siglabsoss/graviton/docs/pin_mapping.pdf

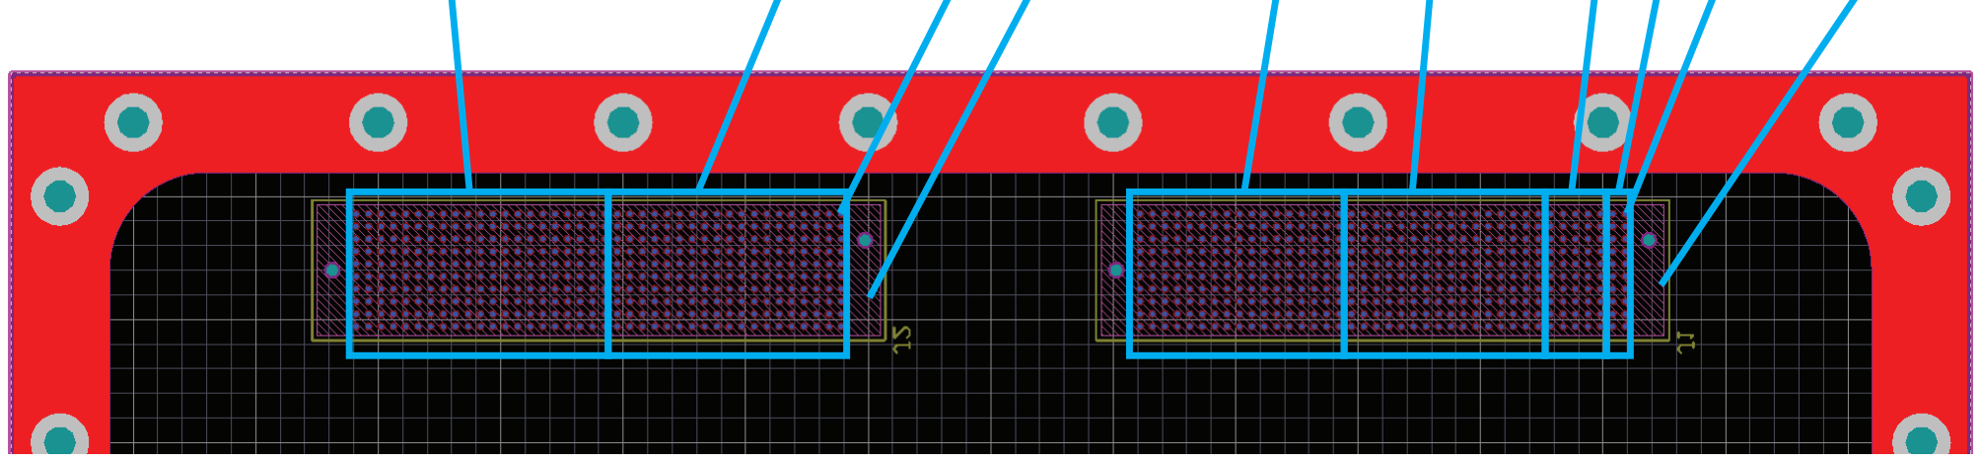
[picture p1: figure]

Graviton Connector: SEAF-40-06.5-S-10-2-A-K-TR (qty. 2)
Viewing from Top and looking through board to connectors on bottom layer

J1(Graviton) goes to J3 (Copper Suicide)
J2 (Graviton) goes to J4 (Copper Suicide)
pin1 | pin1 | J1 J2

JTAG/GPMC/SPI

DAC DATA FROM ETHERNET

ADC DATA FROM ETHERNET

ADC FPGA

DAC FPGA

POWER
