siglabsoss/graviton/docs/system_block_diagram.pdf

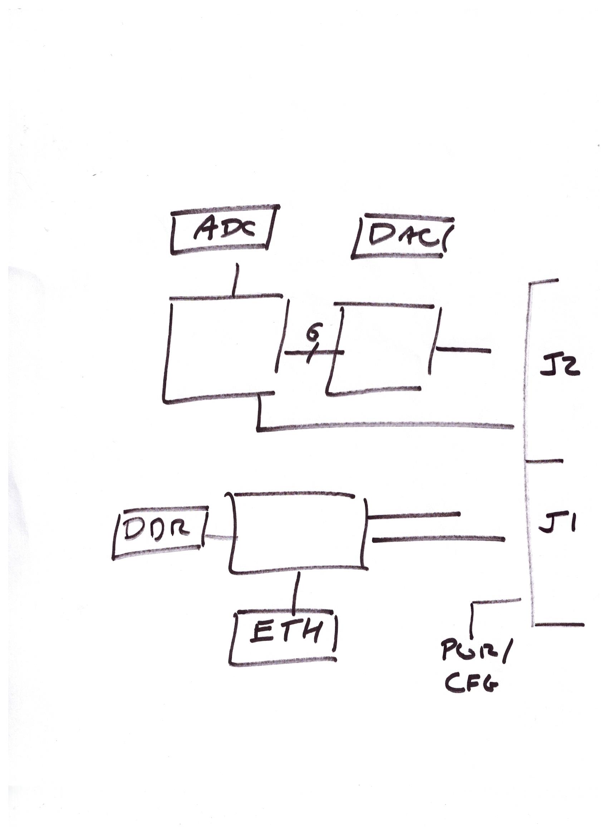
[picture p3: page 1]
