siglabsoss/graviton/docs/Block Diagram v2.png

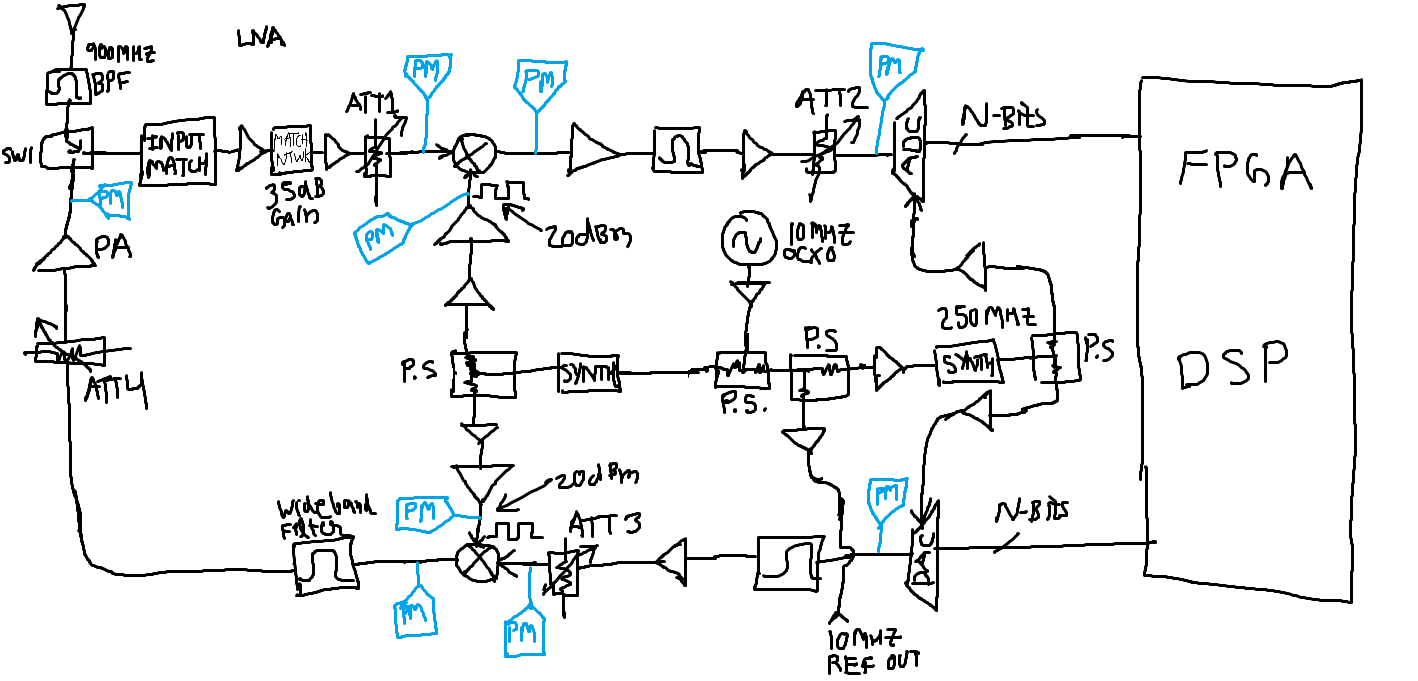
docs/Block Diagram v2.png
