siglabsoss/graviton/docs/graviton_master.xlsx

Sheet: rx_chain
 |  |  |  |  | passband, fc (Hz) | 915000000
Graviton Receiver Analog Front End Cascade Analysis |  |  |  |  | baseband, fc (Hz) | 35000000
 |  |  |  |  | subcarrier bw (Hz) | 30517.57812
 |  |  |  |  | subcarrier noise floor (dBm) | -129.1544993 | dBm
output Z | part number | desc | gain | gain | NF | F |  | cascade F | cascade NF | total gain | total gain | FS limit #1 | FS limit #2 | fs input | fs input | IIP3 | IP3 spur @ FS | noise contribution | notes
 |  |  | dB | W/W | dB |  |  |  | dB | dB | W/W | dBm | dBm | dBm | uW | dBm | dBm | db
377-Ohms S.E. |  | link | 0 | 1.0 | 0 | 1.00 |  | 1.00 | 0.0 | 0 | 1.0 |  |  | -34.8 | 0.330
50-Ohm S.E. |  | antenna matching | 0 | 1.0 | 0.0 | 1.00 |  | 1.00 | 0.0 | 0 | 1.0 |  |  | -34.8 | 0.330369541 |  |  | 0.00
50-Ohm S.E. |  | helical filter | -0.5 | 0.9 | 0.5 | 1.12 |  | 1.12 | 0.5 | -0.5 | 0.9 |  |  | -34.8 | 0.330369541 |  |  | 0.50
50-Ohm S.E. | 132136 | connector IL | -0.2 | 1.0 | 0.2 | 1.05 |  | 1.17 | 0.7 | -0.7 | 0.9 |  |  | -35.3 | 0.2944421634 |  |  | 0.20
50-Ohm S.E. | PE42820 | switch IL | -0.3 | 0.9 | 0.3 | 1.07 |  | 1.26 | 1.0 | -1 | 0.8 |  |  | -35.5 | 0.281190083 |  |  | 0.30
50-Ohm S.E. | SKY67150-396LF | LNA | 20.5 | 112.2 | 0.2 | 1.05 |  | 1.33 | 1.2 | 19.5 | 89.1 |  |  | -35.8 | 0.2624218543 |  |  | 0.23
50-Ohm S.E. | SF2098H | SAW filter IL | -2 | 0.6 | 2.0 | 1.58 |  | 1.33 | 1.3 | 17.5 | 56.2 |  |  | -15.3 | 29.44421634 |  |  | 0.02
50-Ohm S.E. | MMG3004NT1 | block RF amplifier | 16.5 | 44.7 | 3.5 | 2.24 |  | 1.36 | 1.3 | 34 | 2511.9 |  |  | -17.3 | 18.57804455 |  |  | 0.07
50-Ohm S.E. | PE43713 | DSA insersion Loss | -1.3 | 0.7 | 1.3 | 1.35 |  | 1.36 | 1.3 | 32.7 | 1862.1 |  |  | -0.8 | 829.8507675 |  |  | 0.0004449245997
50-Ohm S.E. |  | DSA setting | 0 | 1.0 | 0.0 | 1.00 |  | 1.36 | 1.3 | 32.7 | 1862.1 |  |  | -2.1 | 615.1768727 |  |  | 0.00
50-Ohm S.E. | MAX2031 | MIXER | -7 | 0.2 | 7.0 | 5.01 |  | 1.36 | 1.3 | 25.7 | 371.5 | 0 | -10 | -2.1 | 615.1768727 | 36 | -116.44 | 0.01 | critical
50-Ohm D.E. |  | impedance matching | -3 | 0.5 | 3.0 | 2.00 |  | 1.36 | 1.3 | 22.7 | 186.2 |  |  | -9.1 | 122.7439231 |  |  | 0.01
100-Ohm D.E. | XLF-151+ | reflectionless filter | -1.4 | 0.7 | 1.4 | 1.38 |  | 1.36 | 1.3 | 21.3 | 134.9 |  |  | -12.1 | 61.51768727 |  |  | 0.01
300-Ohm D.E. | LMH6554 | IF Amp | 9 | 7.9 | 6.7 | 4.68 |  | 1.39 | 1.4 | 30.3 | 1071.5 |  |  | -13.5 | 44.56562484 | 20.1 |  | 0.09 | NF derived from Spice simulation
100-Ohm D.E. | TC3-1TG2+ | transformer (Z = 3:1) | -0.49 | 0.9 | 0.5 | 1.12 |  | 1.39 | 1.4 | 29.8 | 957.2 |  |  | -4.5 | 353.9973411 |  |  | 0.0003481871951
100-Ohm D.E. | MEM2012SC470 | MEMS filter | 0 | 1.0 | 0.0 | 1.00 |  | 1.39 | 1.4 | 29.8 | 957.2 |  |  | -5.0 | 316.227766 |  |  | 0.00
300-Ohm D.E. | LMH6554 | AMP | 12 | 15.8 | 7.7 | 5.89 |  | 1.40 | 1.4 | 41.8 | 15170.5 |  |  | -5.0 | 316.227766 |  |  | 0.02
100-Ohm D.E. | placeholder | placeholder | 0 | 1.0 | 0.0 | 1.00 |  | 1.40 | 1.4 | 41.8 | 15170.5 |  |  | 7.0 | 5011.872336 |  |  | 0.00
100-Ohm D.E. | placeholder | placeholder | 0 | 1.0 | 0.0 | 1.00 |  | 1.40 | 1.4 | 41.8 | 15170.5 |  |  | 7.0 | 5011.872336 |  |  | 0.00
50-Ohm D.E. | placeholder | placeholder | 0 | 1.0 | 0.0 | 1.00 |  | 1.40 | 1.4 | 41.8 | 15170.5 |  |  | 7.0 | 5011.872336 |  |  | 0.00
 | AD42LB69 | ADC (250 Msps), Vpp(diff) = 2.0V | 0 | 1.0 | 27.0 | 501.19 |  | 1.43 | 1.5 | 41.8 | 15170.5 | 9 | 7 | 7.0 | 5011.872336 |  |  | 0.10 | Vpp=2Vdiff, Z=100(D.E.), Pin(rms)=5mW(7dBm)
 |  | legend
 | [NUMBER] | things that you can program

Sheet: tx_chain
output z | P/N | desc | gain (worse) | gain (typ) |  | out (worse) | out (typ) | p (W, worse) | r | vrms (worse)
 |  | digital attenuation
 | DAC3484 | DAC (4.7mArms @ 50-Ohm) | -2.5 | -2.6 | dBm | -2.5 | -2.6 | 0.0006 | 50 | 0.167
100 D.E. | TC1-1TG2+ | transformer | -0.3 | -0.4 | dB | -2.9 | -3.0 | 0.001 | 50 | 0.160
100 D.E. | MEM2012V121R | MEMS | -0.2 | -0.2 | dB | -3.1 | -3.2 | 0.0004897788194 | 51 | 0.158
100 D.E. | LMH6554 | IF amp | -4.7 | -4.7 | dB | -7.8 | -7.9 | 0.0001659586907 | 52 | 0.093
100 D.E. | XLF-151+ | reflectionless filter | -1.8 | -1.4 | dB | -9.6 | -9.3 | 0.0001096478196 | 53 | 0.076
 |  | matching (attenuation approximate, depends on matching) | -7.3 | -7.3 | dB | -16.9 | -16.6 | 2.041737945e-05 | 54 | 0.033
50 S.E. | MAX2031 | mixer | -7.0 | -7.0 | dB | -23.9 | -23.6 | 4.073802778e-06 | 54 | 0.015
50 S.E. | SKY67150-396LF | preamp | 19.0 | 20.5 | dB | -4.9 | -3.1 | 0.0003235936569 | 55 | 0.133
50 S.E. | SF2098H | SAW filter | -3.0 | -2.0 | dB | -7.9 | -5.1 | 0.0001621810097 | 56 | 0.095
50 S.E. | MMG3006NT1 | preamp | 16.5 | 17.5 | dB | 8.6 | 12.4 | 0.007 | 57 | 0.643
50 S.E. |  | placeholder | 0.0 | 0.0 | dB | 8.6 | 12.4 | 0.007 | 58 | 0.648
50 S.E. | MMG3006NT1 | preamp | 16.5 | 17.5 | dB | 25.1 | 29.9 | 0.324 | 59 | 4.369
50 S.E. | NPA1006 | power amplifier (12.5W, 41dBm max) | 16.5 | 18.5 | dB | 41.6 | 48.4 | 14.454 | 60 | 29.449
50 S.E. |  | power meter | -0.3 | -0.3 | dB | 41.3 | 48.1 | 13.490 | 61 | 28.686
50 S.E. | PE42820MLBA-X | switch | -0.3 | -0.3 | dB | 41.0 | 47.8 | 12.589 | 62 | 27.938
50 S.E. |  | helical Filter | -1.0 | -1.0 | dB | 40.0 | 46.8 | 10.000 | 63 | 25.100
 |  |  |  |  |  |  |  | Rs | 150 | Ohm
 |  |  |  |  |  |  |  | Rp | 13.63636364 | Ohm
 |  | amp output (dBm) | 40.0 | 46.8 | dBm |  |  | gain | 0.08 | V/V
 |  | power (W) | 10.0 | 47.9 | Watts
 |  | worse case (over spec): | 0.6 |  |  |  |  | op gain | 2.333333333
 |  | typical case (over spec): | 7.4
 |  |  |  |  |  |  |  | total gain | 0.1944444444
 |  |  |  |  |  |  |  | Pin/Pout | 0.07561728395 | W/W
 |  |  |  |  |  |  |  |  | -11.2 | dB

Sheet: power_budget
5.5V Supply
eff | volts | amps | watts
0.85 | 3.8 | 5.8 | 22.1 | 3.7V Supply
1 | 5.5 | 2.4 | 13.2 | AFE #1 5V
1 | 5.5 | 0.1 | 0.6 | AFE #1 -5V
1 | 5.5 | 2.4 | 13.2 | AFE #2 5V
1 | 5.5 | 0.1 | 0.6 | AFE #2 -5V
1 | 5.5 | 2 | 11.0 | Amps
1 | 5.5 | 0.5 | 2.8 | OCXO
1 | 5.5 | 3 | 16.5 | SigCarrier
1 | 5.5 | 1 | 5.5 | Fans
 |  | watts | 85.3
 |  | overrating (W) | 93.9
 |  | volts | 5.5
 |  | amps | 17.1
3.8 Supply
eff | volts | amps | watts
1 | 3.8 | 0.245 | 0.9 | ADC (DRVDD 1.8V)
1 | 3.8 | 0.522 | 2.0 | ADC (AVDD 3.3V)
1 | 3.8 | 0.182 | 0.7 | ADC (AVDD 1.8V)
1 | 3.8 | 0.135 | 0.5 | DAC (AVDD 3.3V)
1 | 3.8 | 0.65 | 2.5 | DAC (DVDD 1.2V)
1 | 3.8 | 0.15 | 0.6 | DAC (DACVDD 1.2)
1 | 3.8 | 0.385 | 1.5 | SYNTH (3.3V)
1 | 3.8 | 0.665 | 2.5 | CLK (3.3V)
1 | 3.8 | 0.14 | 0.5 | MCU (3.0V)
1 | 3.8 | 1 | 3.8 | 2.5V Supply
1 | 3.8 | 1 | 3.8 | 1.8V Supply
1 | 3.8 | 0.2 | 0.8 | ETH (3.3V)
1 | 3.8 | 0.01 | 0.038 | AFE (3.3)
 |  | watts | 20.1
 |  | overrating (W) | 22.1
 |  | volts | 3.8
 |  | amps | 5.8
-5.5V Supply
eff | volts | amps | watts
 |  | watts | 0.0
 |  | volts | 5.5
 |  | amps | 0.0
29V Supply
eff | volts | amps | watts
0.85 | 5.5 | 17.1 | 110.4 | 5.5V supply
0.85 | 5.5 | 5.8 | 37.6 | 3.7V supply
0.85 | 3.7 | 0.0 | 0.0 | -5V supply
1 | 29 | 1 | 29.0 | TX PA #1
1 | 29 | 1 | 29.0 | TX PA #2
 |  | watts | 206.0
 |  | volts | 29.0
 |  | amps | 7.1
