siglabsoss/graviton/docs/20180918-1_grav3_rework_instructions(rev3.1).docx

#1. “DAC 1.2V regulators not regulating”

Solution: Connect feedback pin.

Instructions: Jumper C412 and C416

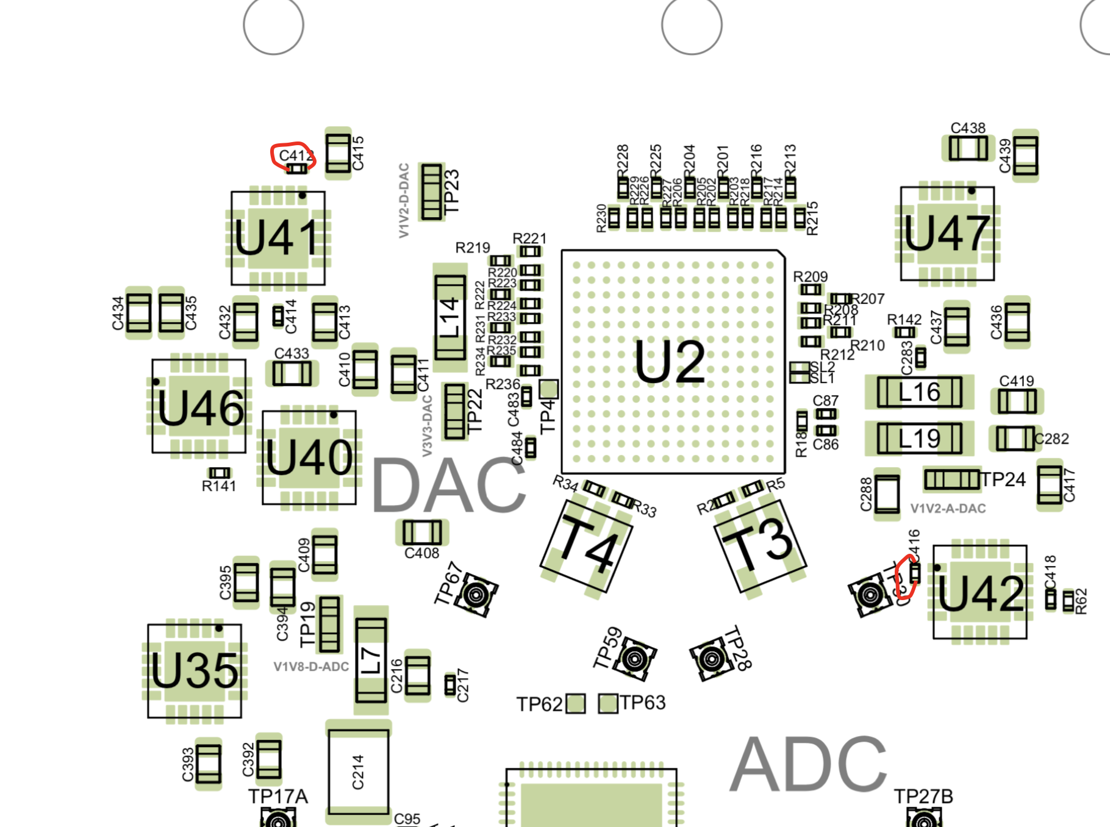
[picture p5: figure]

#2. “SPI bus being held low”

Solution: DAC, SYNTH, and CLOCK power supplies need to be jumpered ON (i.e. on by default).

Instructions: Jumper R62 to C417 (as shown below). Jumper R66 to C428 (as shown below). Jumper R60 to C404 (as shown below).

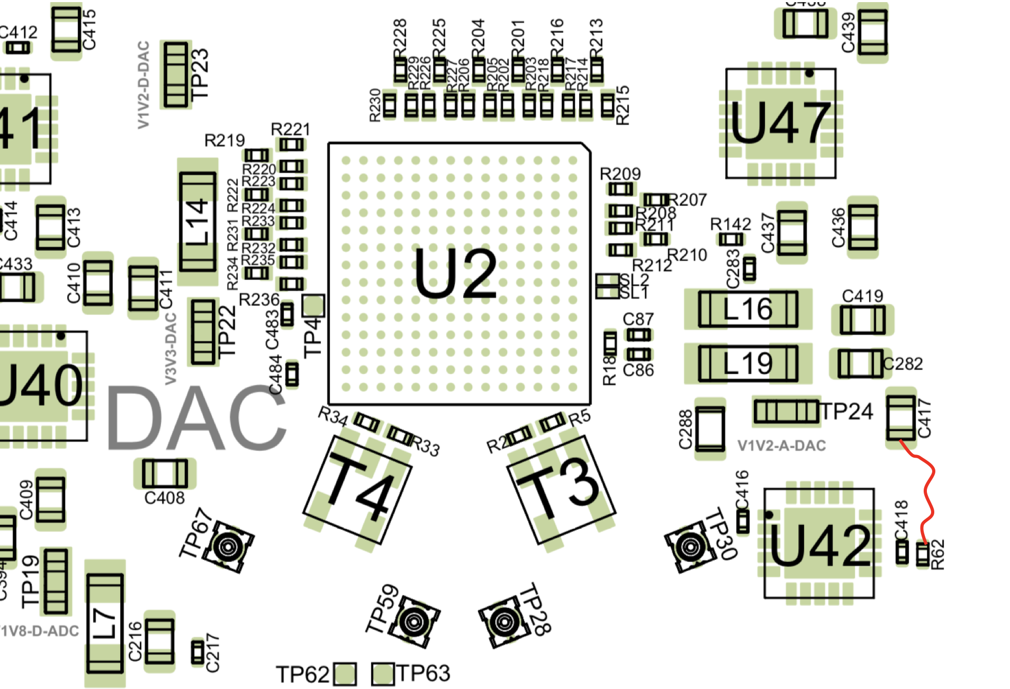
[picture p6: figure]
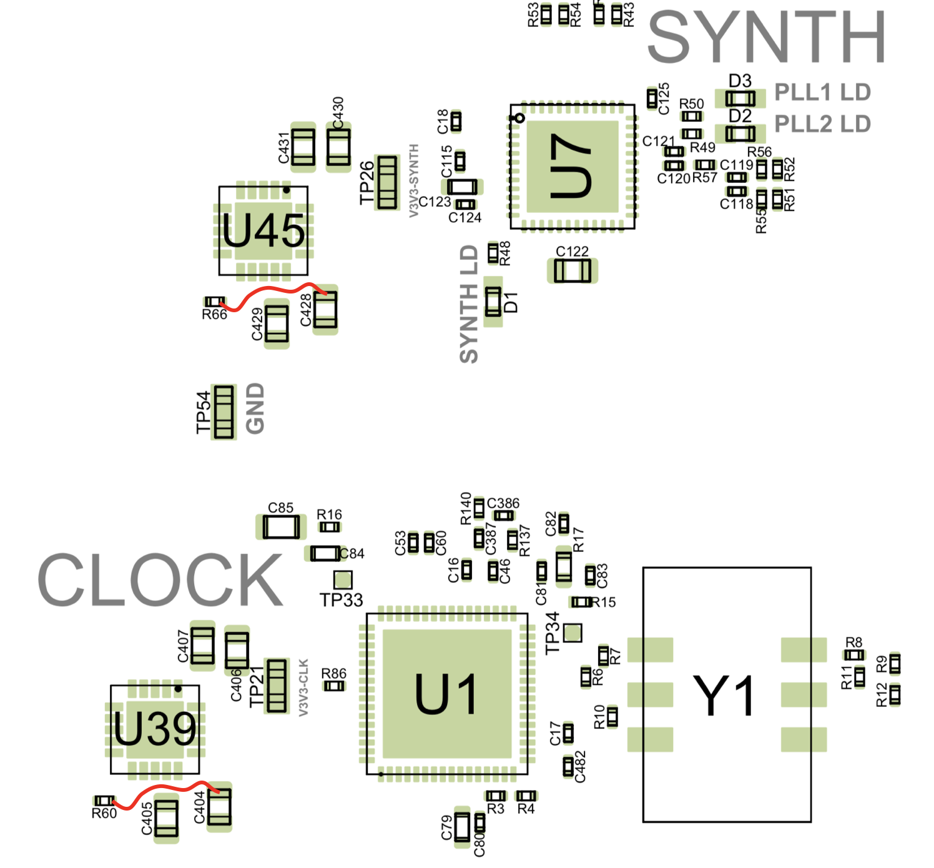
[picture p7: figure]

3. “Not enough solder on Solder-Link pads”

Solution: Verify all solder-links are bridged. If not, bridge them. All solder links are highlighted below.

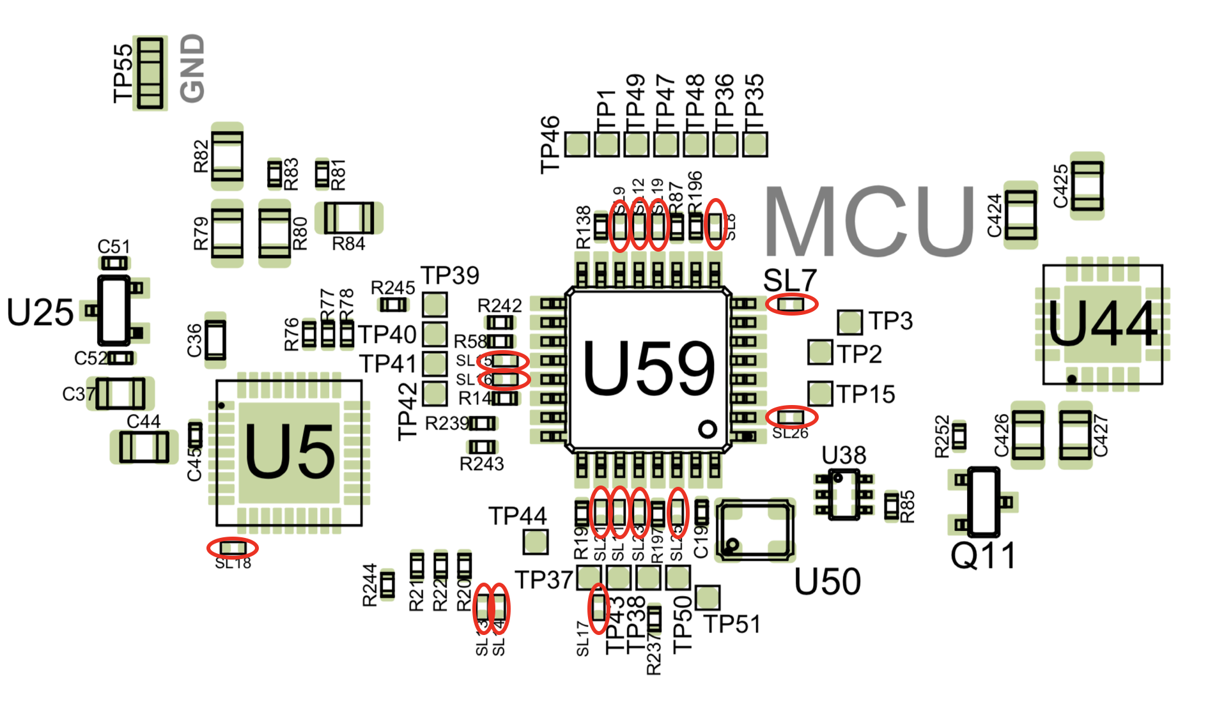
[picture p8: figure]

4. “U25 is wrong”

Solution: substitute P/N MCP1700T-5002E/TT and rotate 120 degrees (as shown below).

Note: MCP1700T-5002E/TT is already in BOM. It just needs rotating.

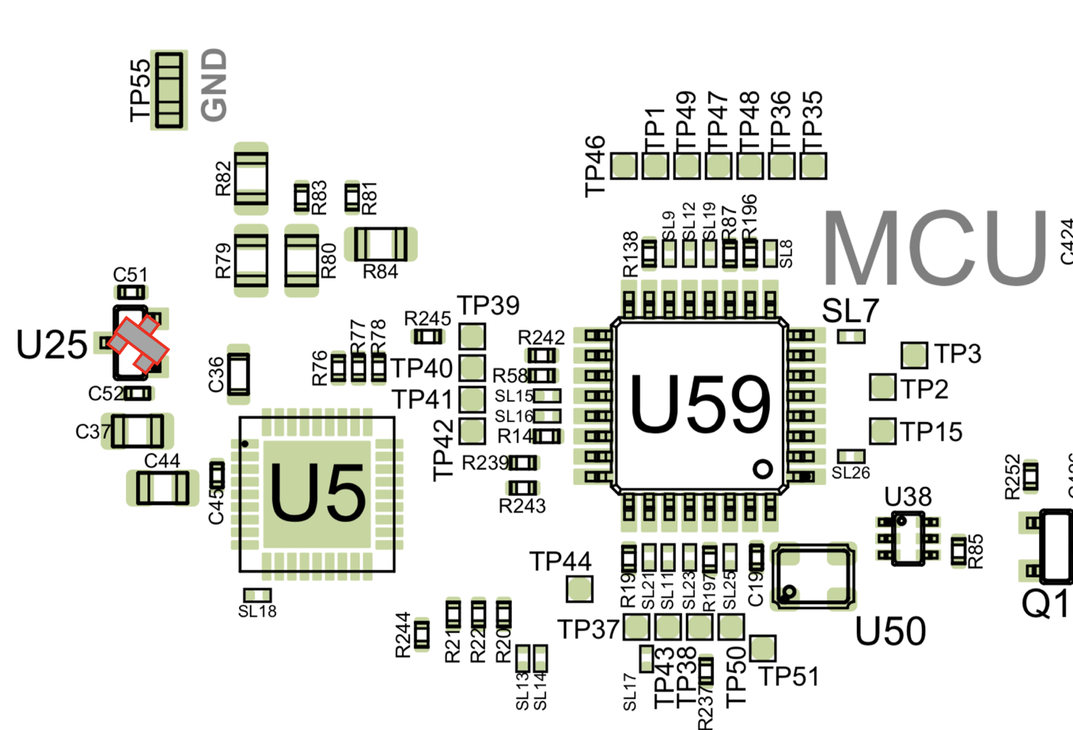
[picture p9: figure]

5. “5MHZ Oscillator Quality Issue”

Solution: terminate at drive side instead of receive side

Instructions: Short R137 (as shown below). Make R198 22-Ohms. Make C385 100nF.

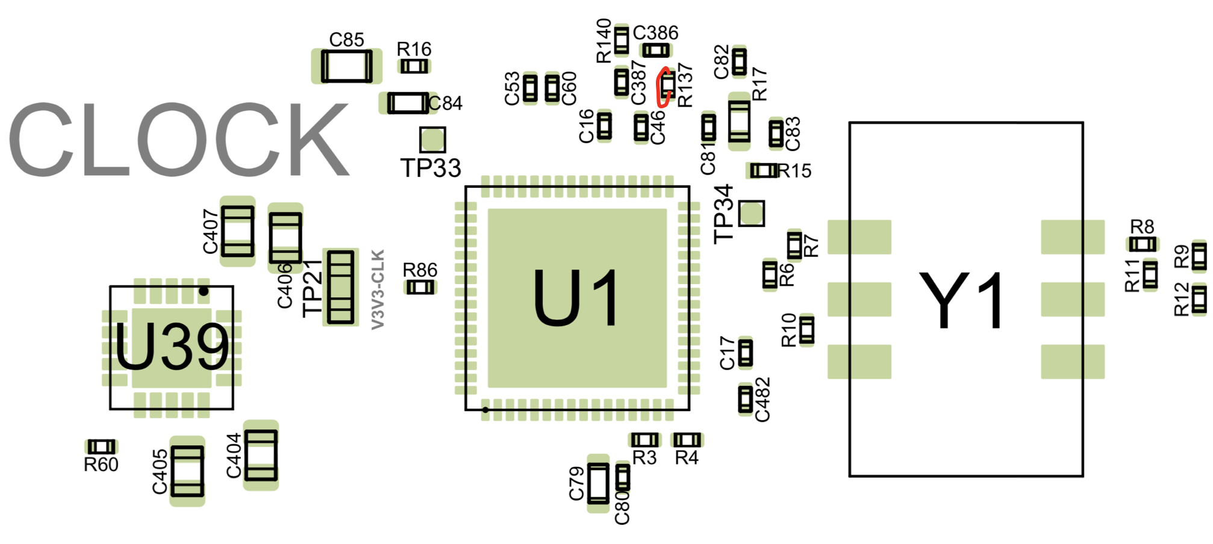
[picture p10: figure]
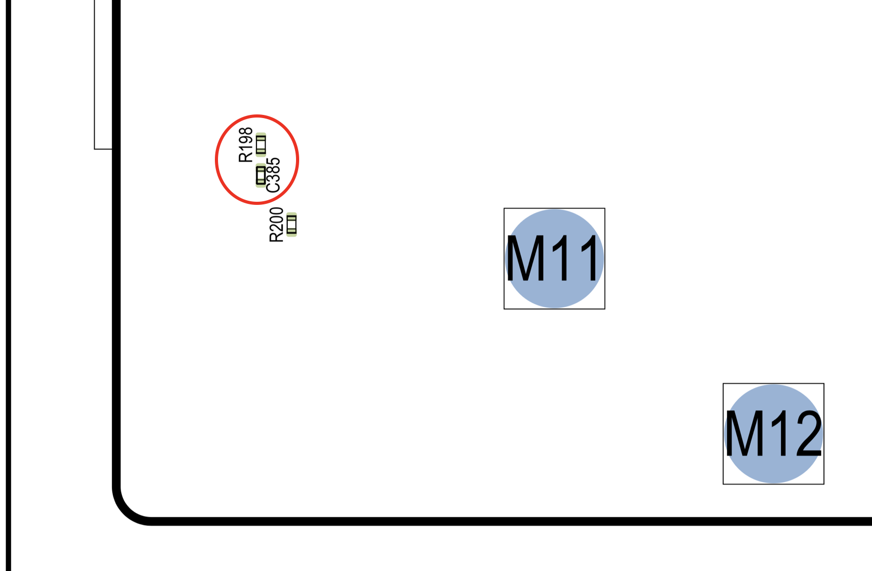
[picture p11: figure]

REWORK INSTRUCTIONS, GRAVITON REV. 3.1
