siglabsoss/graviton/docs/User Guide Block Diagrams.pptx

RX FPGA

RF Front End (x2)

TX Chain

LO from CLOCK
(see clock diagram)

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
RX Chain

BPF

MIX

X

IF AMP

VGA

ADC

LVDS

SPI

TX/RX SW

LO from CLOCK
(see clock diagram)

LVDS

SPI

CONFIG
FPGA

GPIO

SPI

PARALLEL

TX FPGA

## Slide 2

RX FPGA

CONFIG
FPGA

JTAG

MAIN JTAG CONNECTOR

SPI

FLASH

ENET
PHY

MDIO

sysCONFIG SPI

sysCONFIG SPI

SDRAM

DDR3

GPMC 23

RGMII

sysCONFIG SPI

RX FPGA

JTAG

ETHERNET FPGA

JTAG

JTAG

GPIO 8

DDR 47

SDR 23

DDR 47

SDR 23

SDR 23

DDR 47

SDR 23

DDR 47

COPPER SUICIDE CONNECTOR J2

COPPER SUICIDE CONNECTOR J1

GRAVITON JUMPER CONNECTOR J4

GRAVITON JUMPER CONNECTOR J3

GRAVITON JUMPER
(optional)

## Slide 3

BIAS
LDO

8V

RF Front End

PoE
ETH
JACK

48V

5V/6A
BUCK

-2.7

1.2V/2A
BUCK

DAC Core

2.5V/2A
BUCK

I/O Supply, FPGA VCCAUX

COPPER SUICIDE CONENCTOR

1.8V/2A BUCK

I/O Supply

Oscillators, RF LNAs, PAs, Mixers, DSAs, VGAs

1.35V/2A
BUCK

SDRAM

1.1V/6A
BUCK

FPGA Core

3.3V/2A
BUCK

PLLs, ADC

Ultra-low-noise
Supply for LNAs

0.68V
LDO

SDRAM
VTERM

4.8V
LDO

1.8V
LDO

ADC
AVDD

5V/6A
BUCK

x4
