siglabsoss/graviton/hardware/180706-1_graviton(schem_rev3).pdf

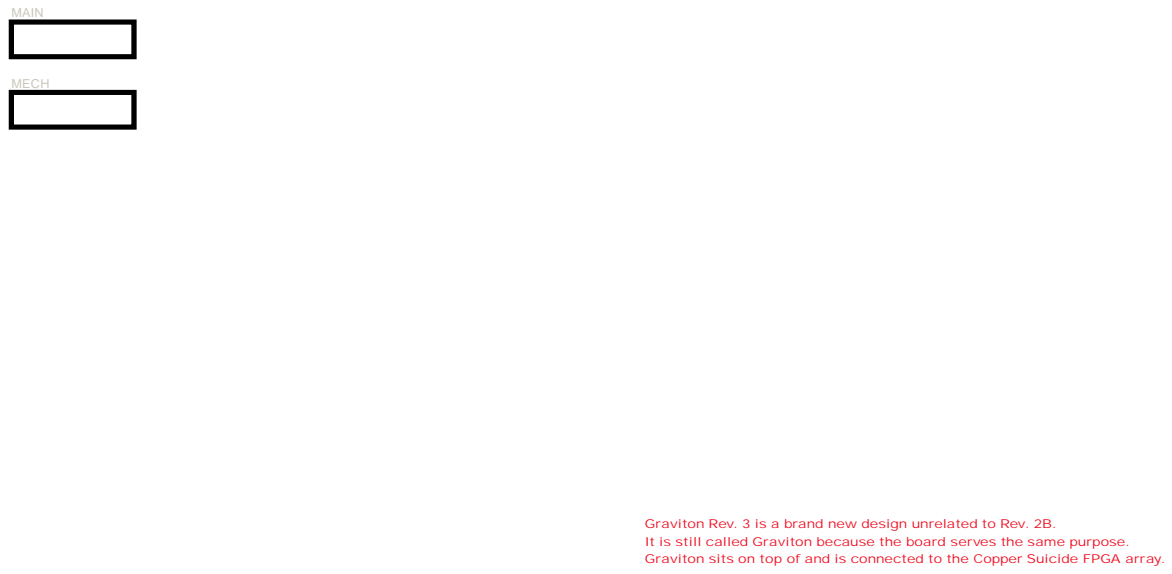
[picture p18: page 1]

Graviton Rev. 3 is a brand new design unrelated to Rev. 2B.
It is still called Graviton because the board serves the same purpose.
Graviton sits on top of and is connected to the Copper Suicide FPGA array.

Signal Laboratories, Inc. 3479 Edison Way Menlo Park CA 94025 +1 (877) 778-8435 siglabs.com | Title Graviton SDR

Engineer J. Brinton | Drawn By J. Brinton | Checked By J. Brinton

Date 7/6/2018 Sheet 1 of 49 Revision

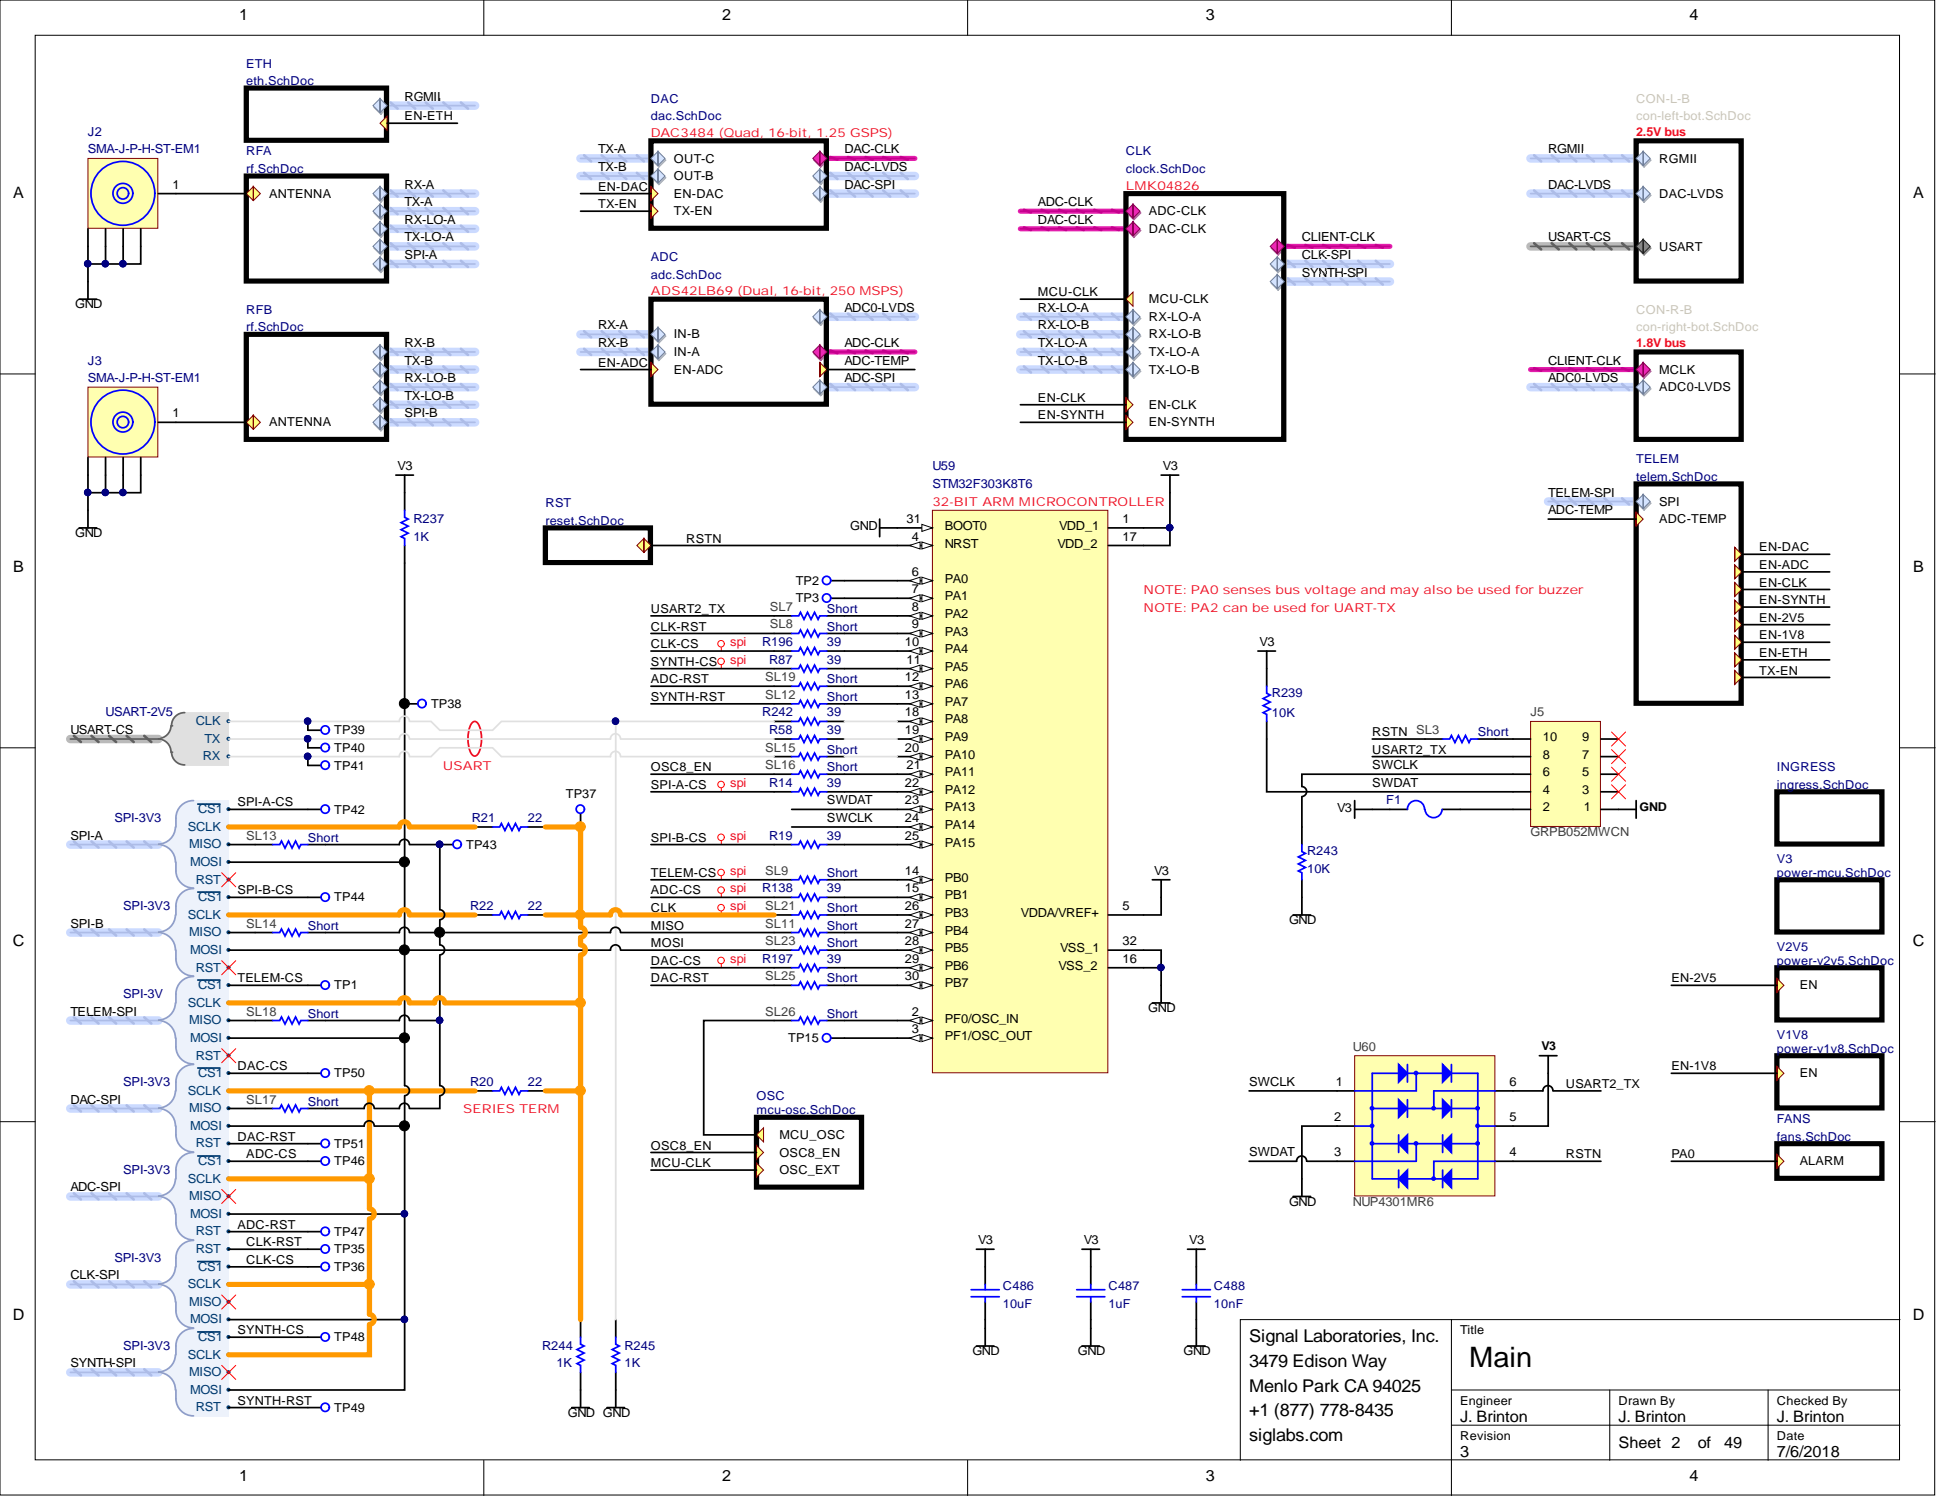
[picture p19: page 2]

CON-L-B
con-left-bot.SchDoc
2.5V bus

CON-R-B
con-right-bot.SchDoc
1.8V bus

NOTE: PA0 senses bus voltage and may also be used for buzzer
NOTE: PA2 can be used for UART-TX

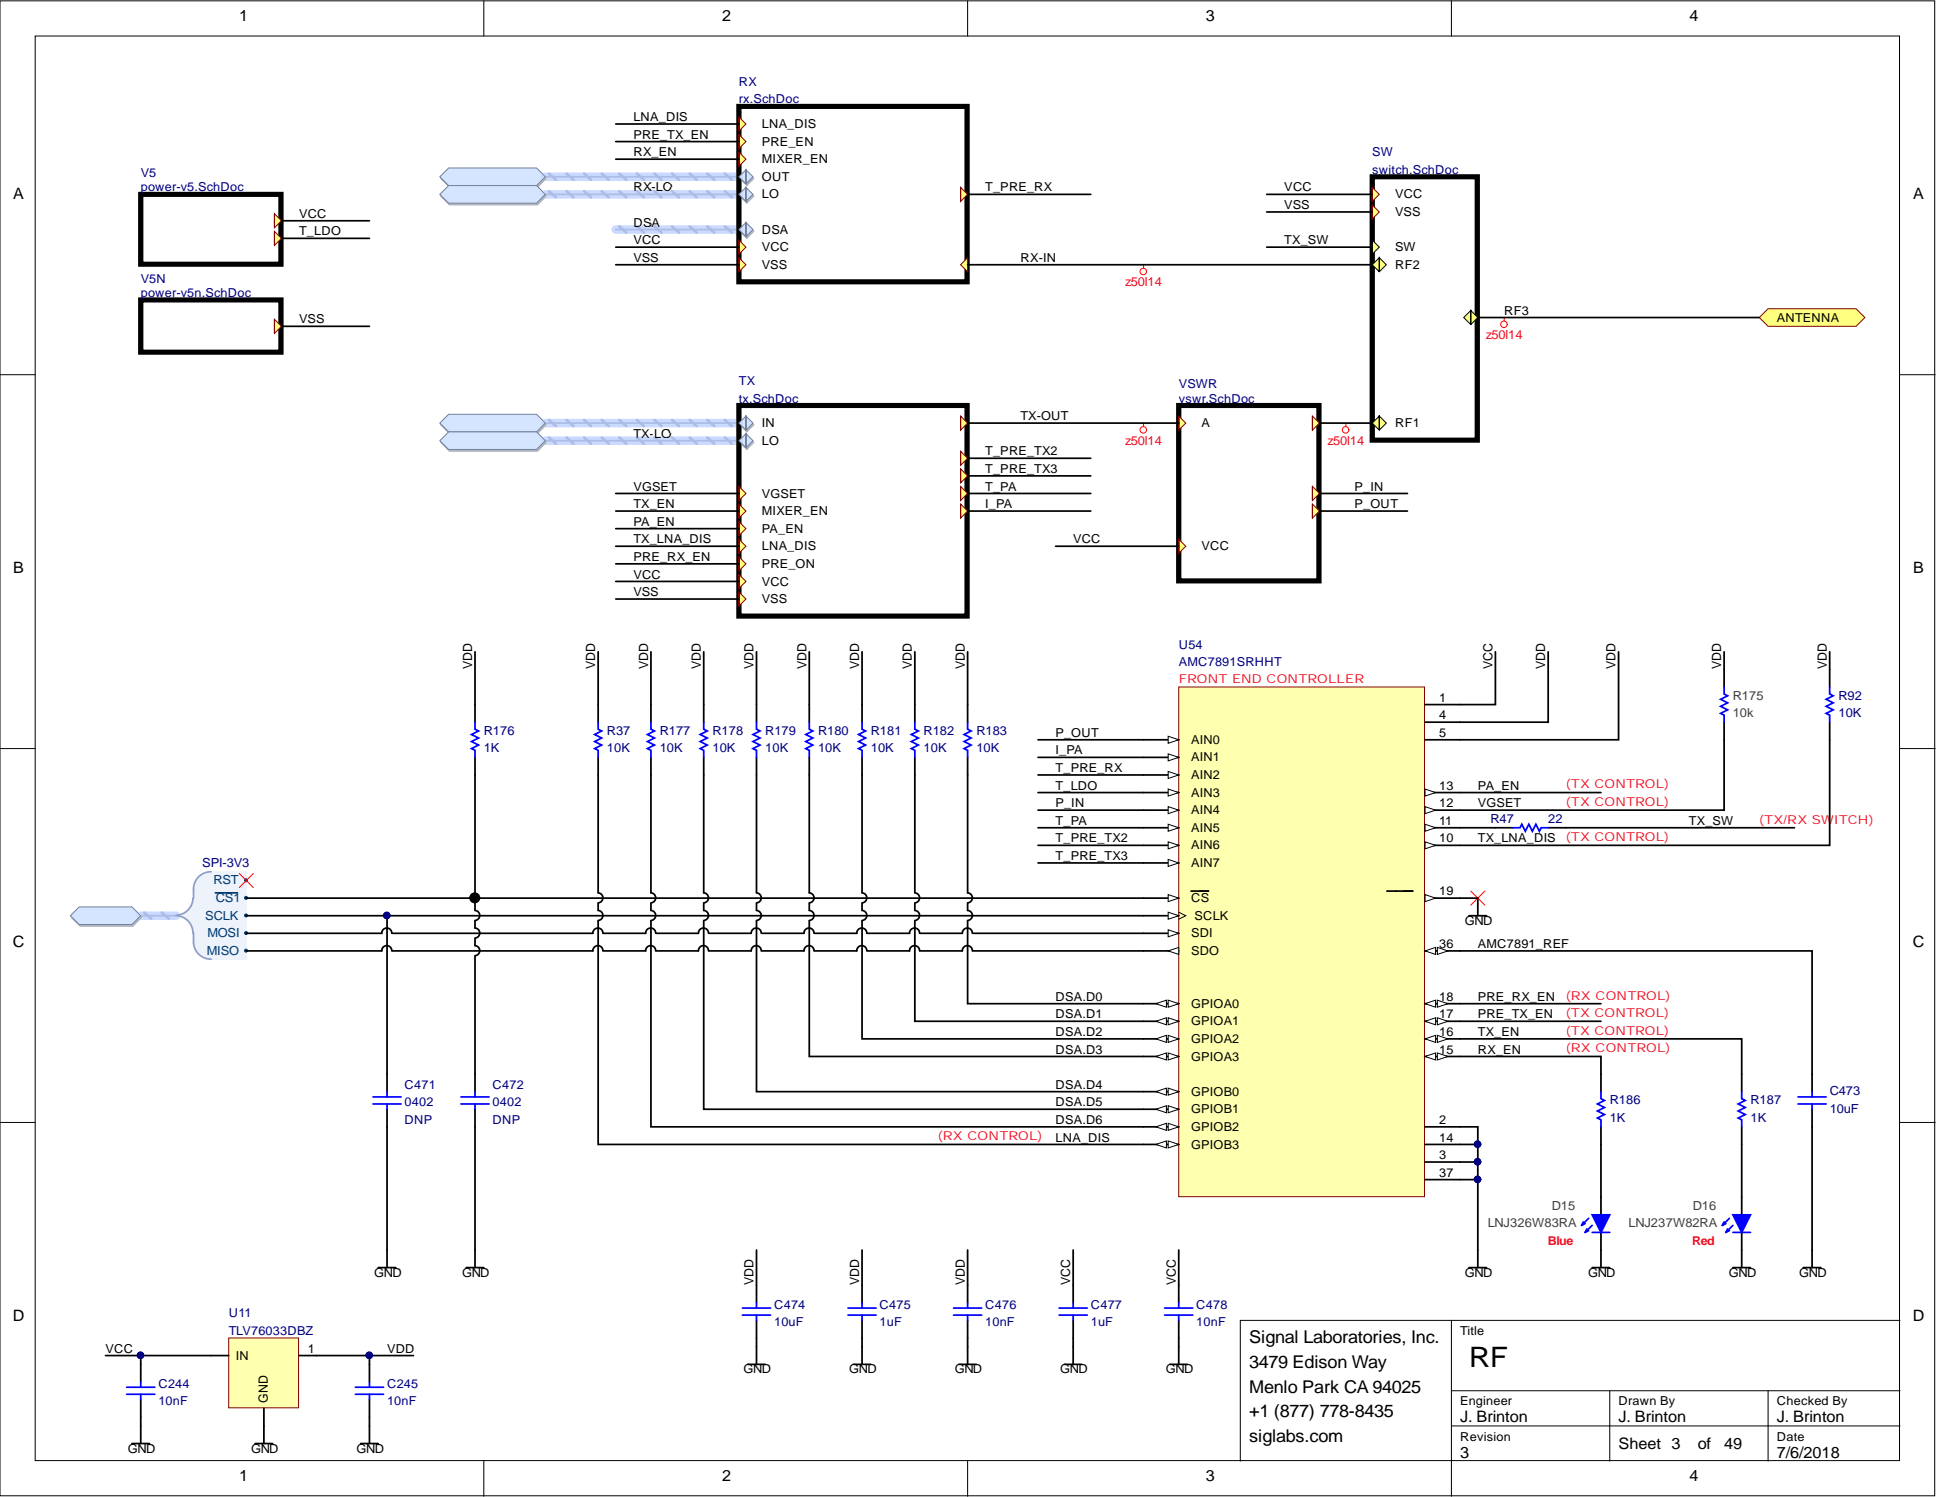
[picture p20: page 3]

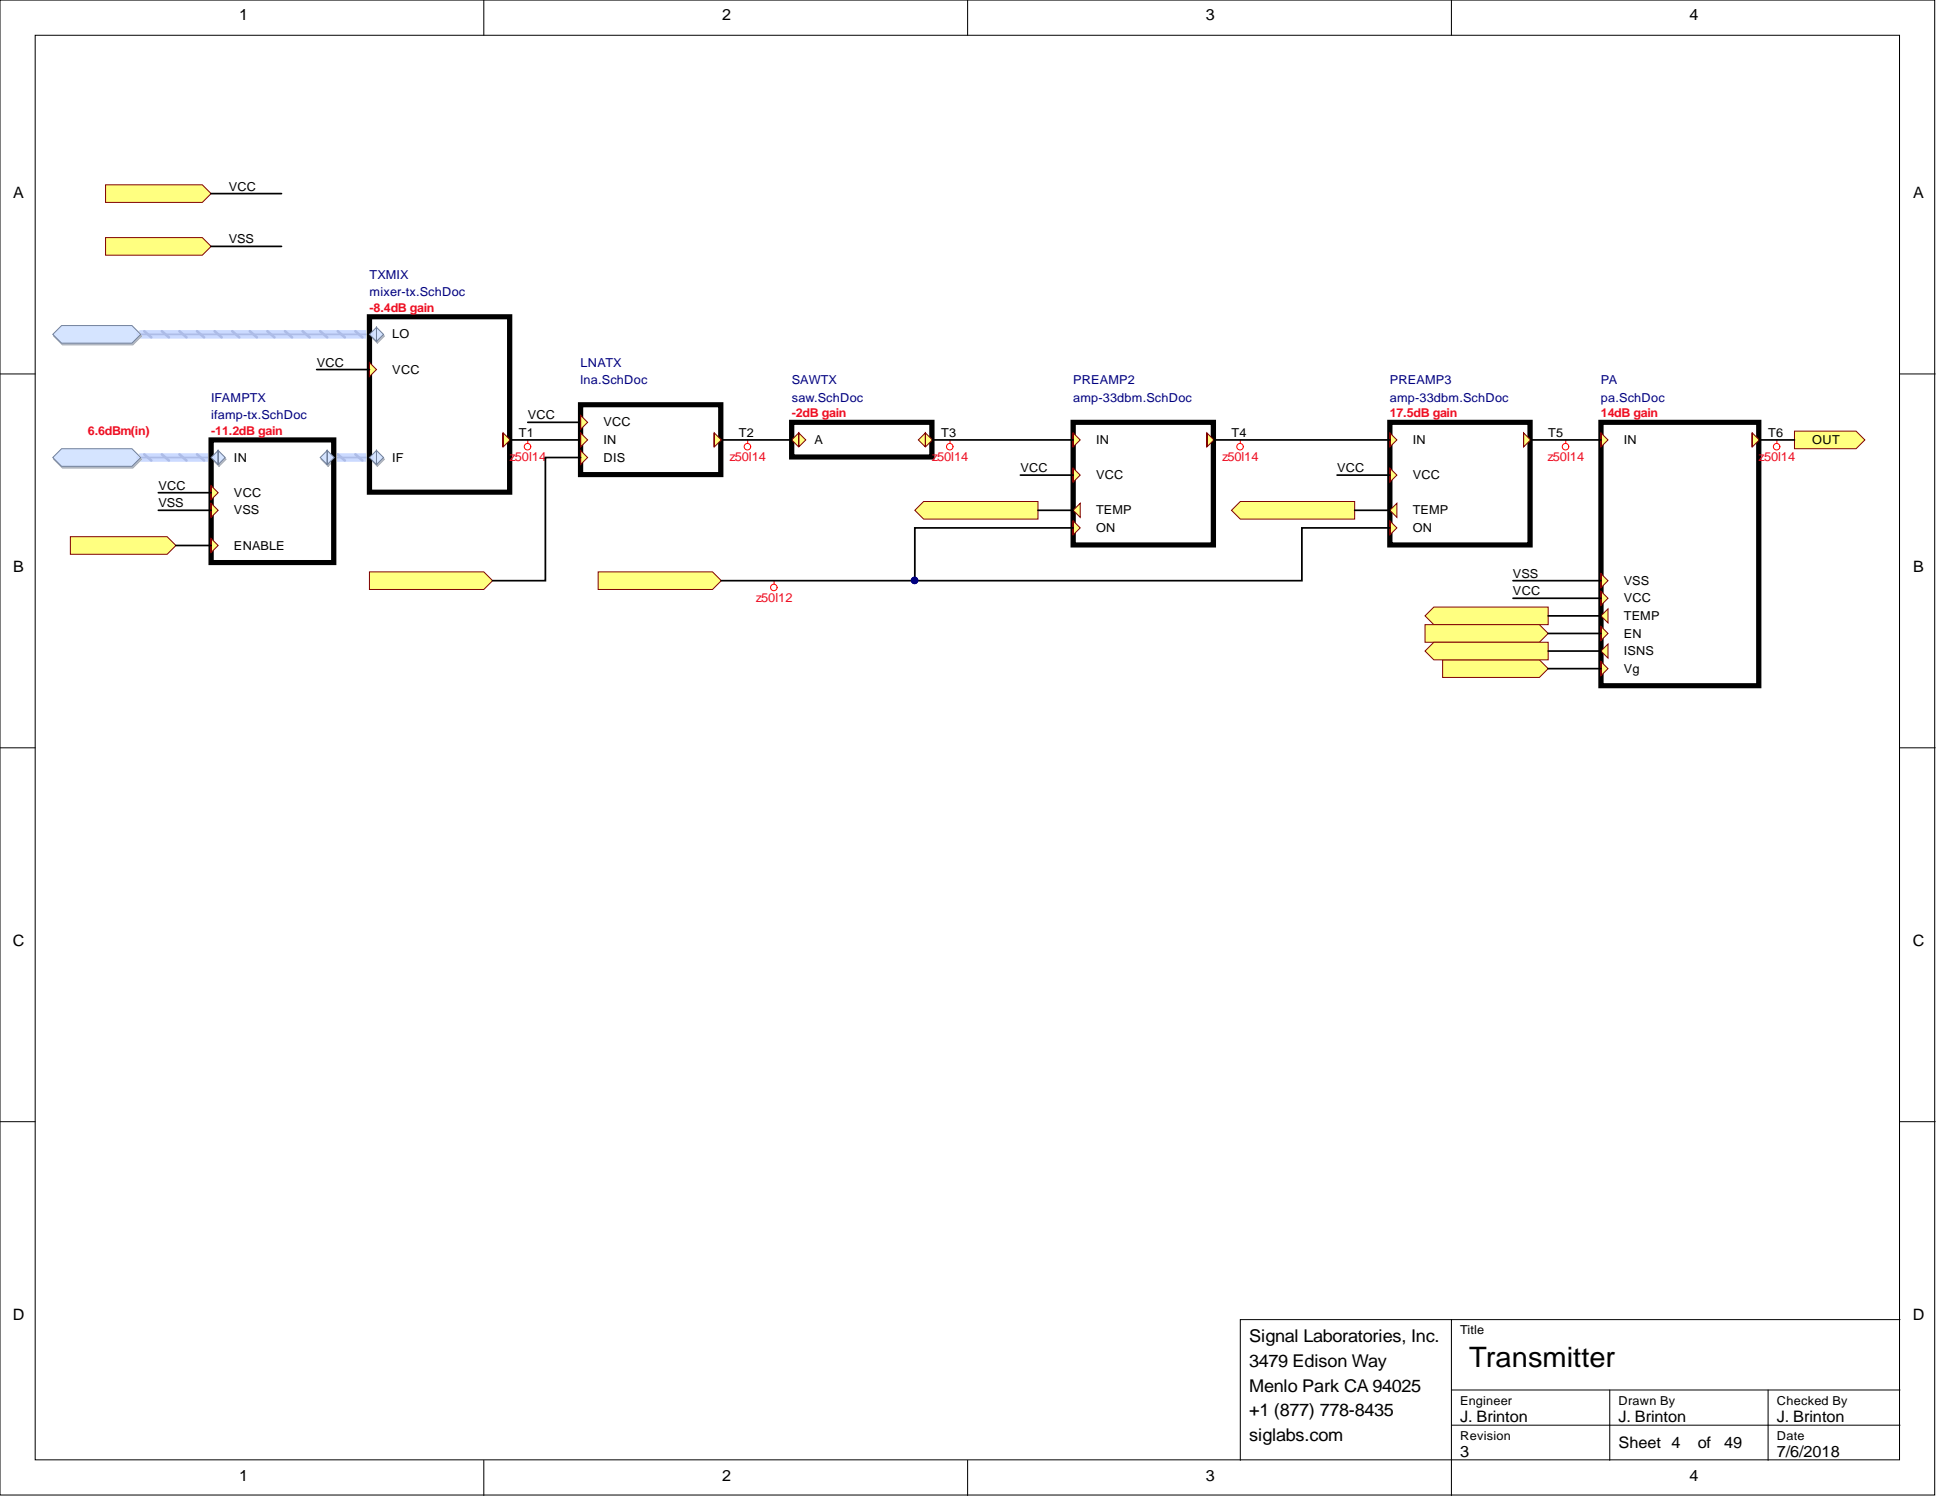
[picture p21: page 4]

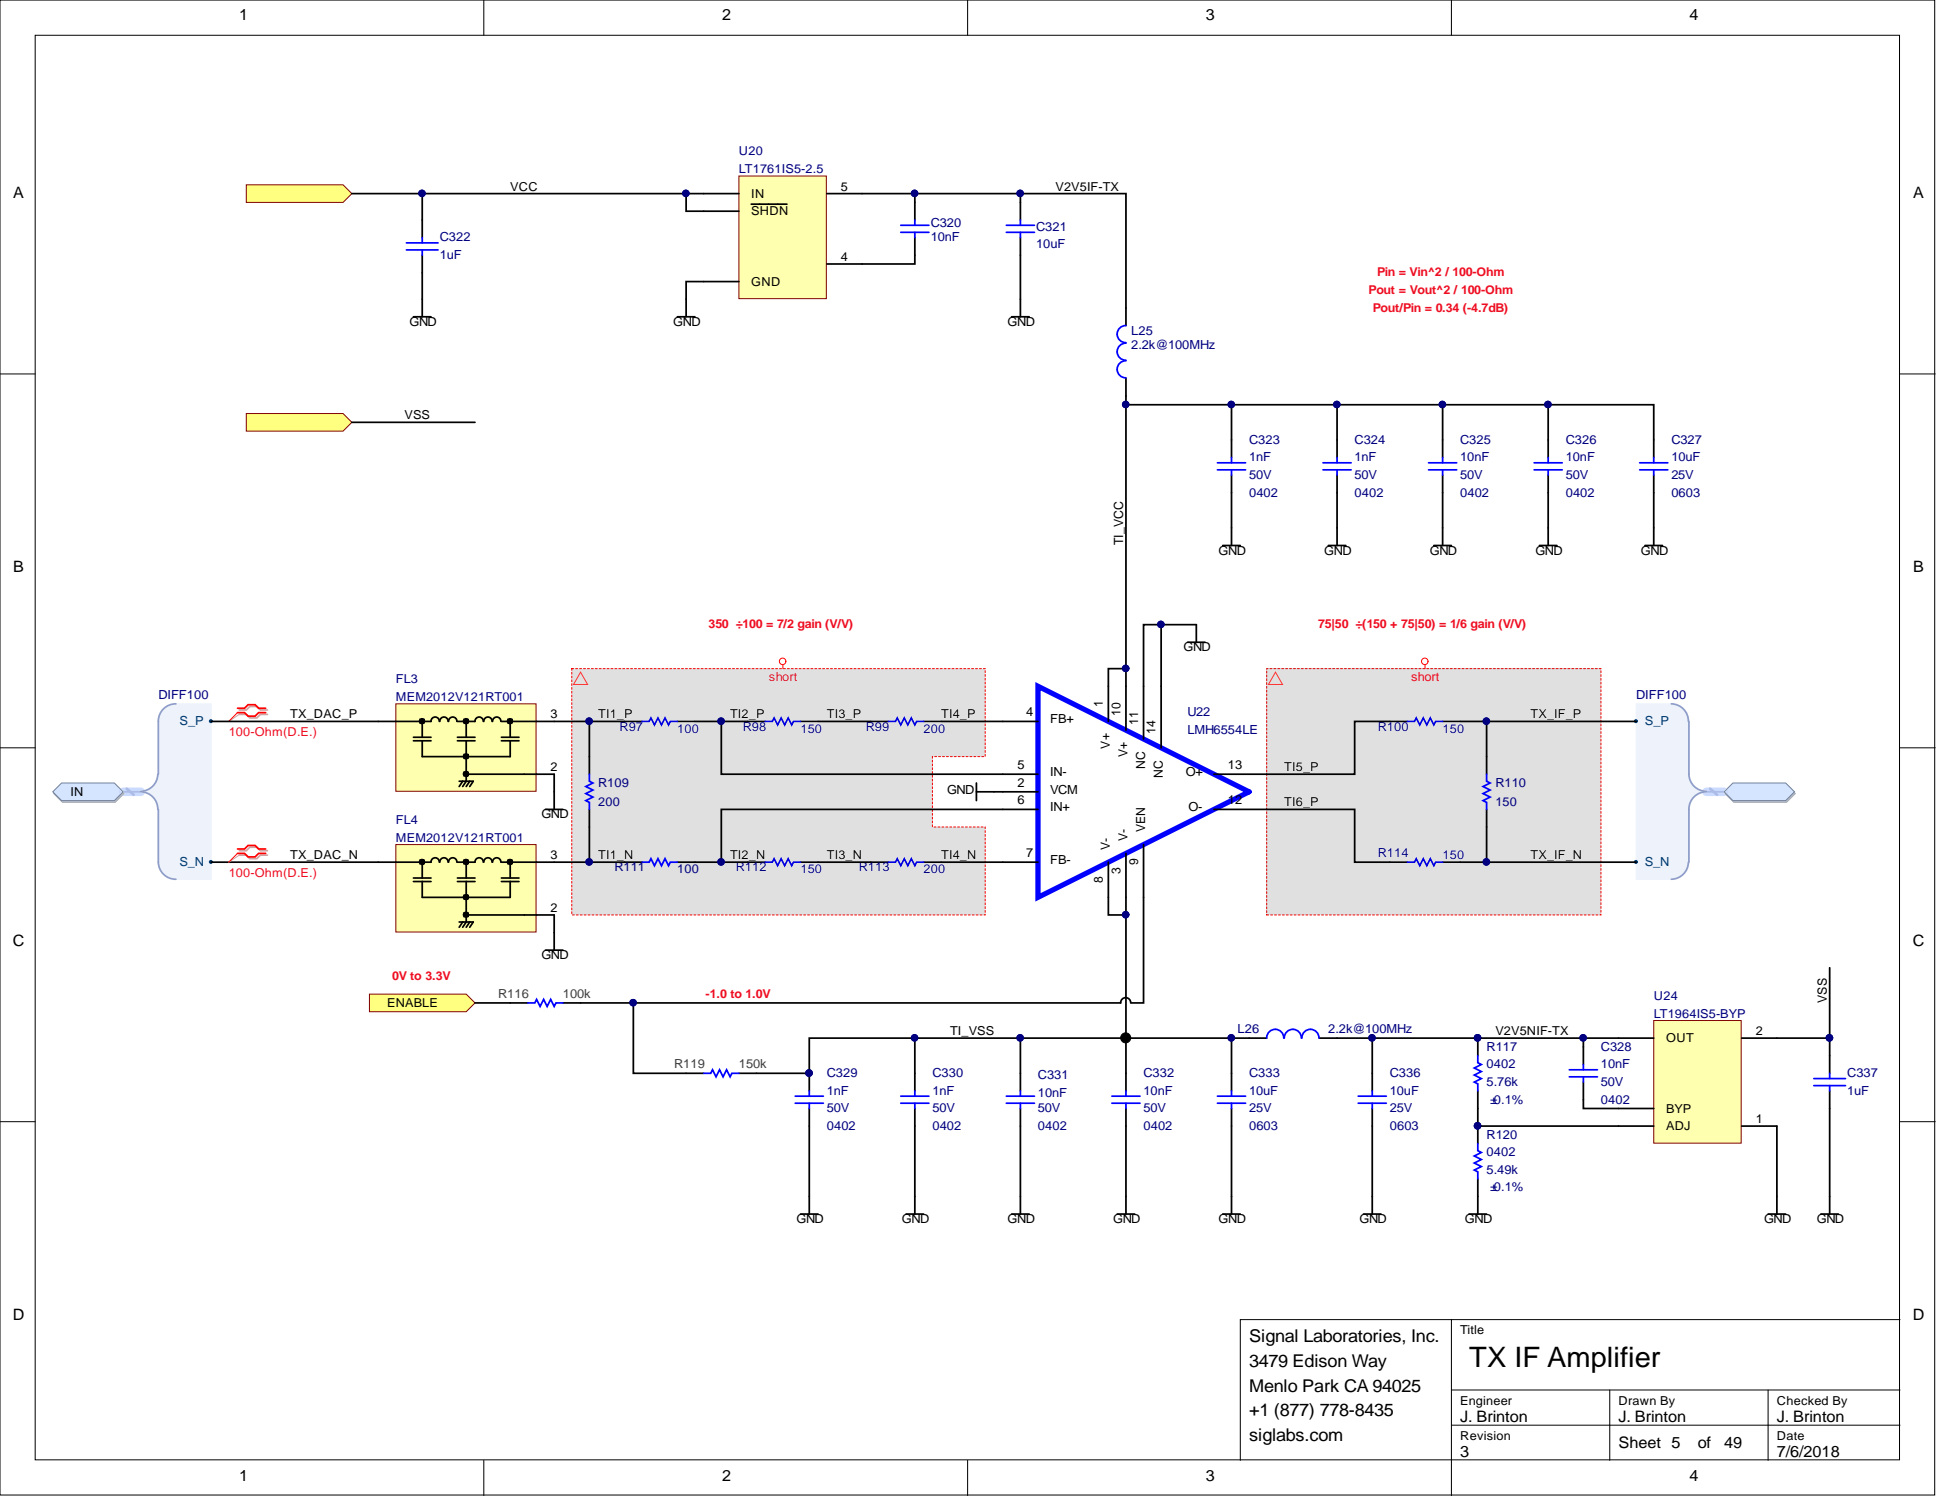
[picture p22: page 5]

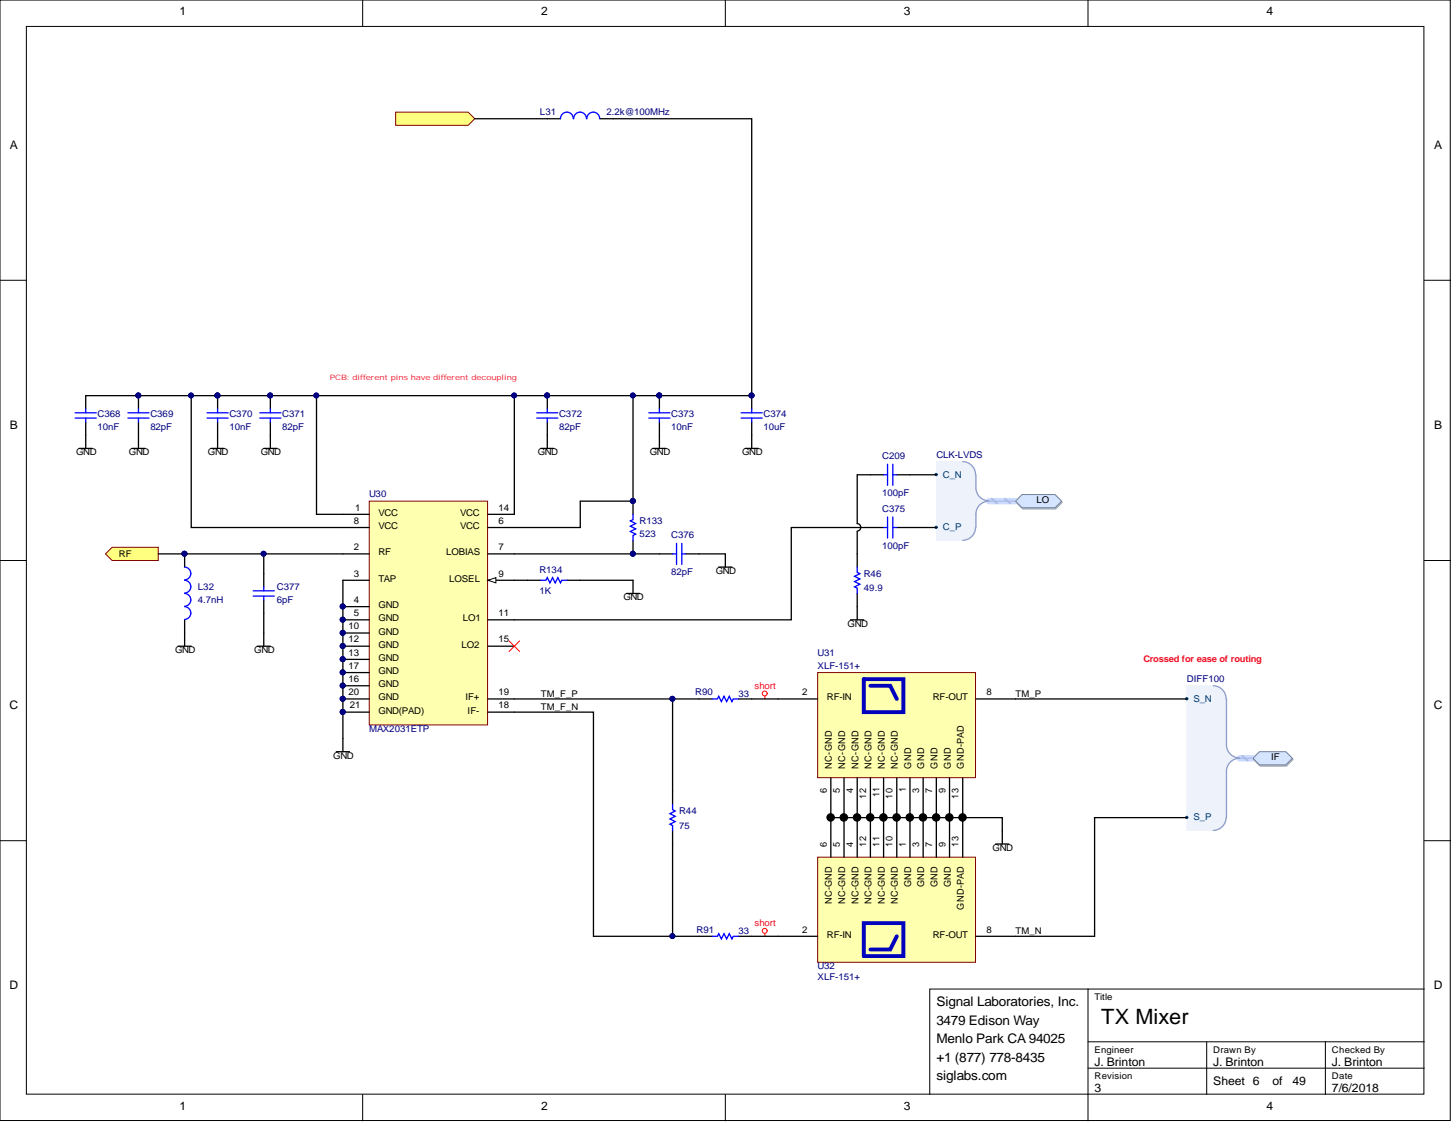
[picture p23: page 6]

PCB: different pins have different decoupling

Crossed for ease of routing

NC-GND 4 NC-GND 5 NC-GND 6

NC-GND 10 NC-GND 11 NC-GND 12

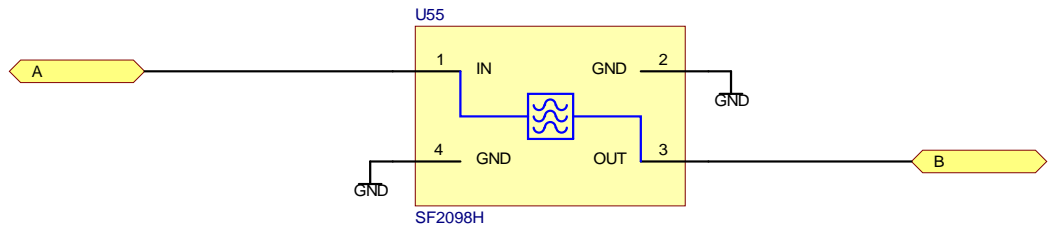
[picture p24: page 7]

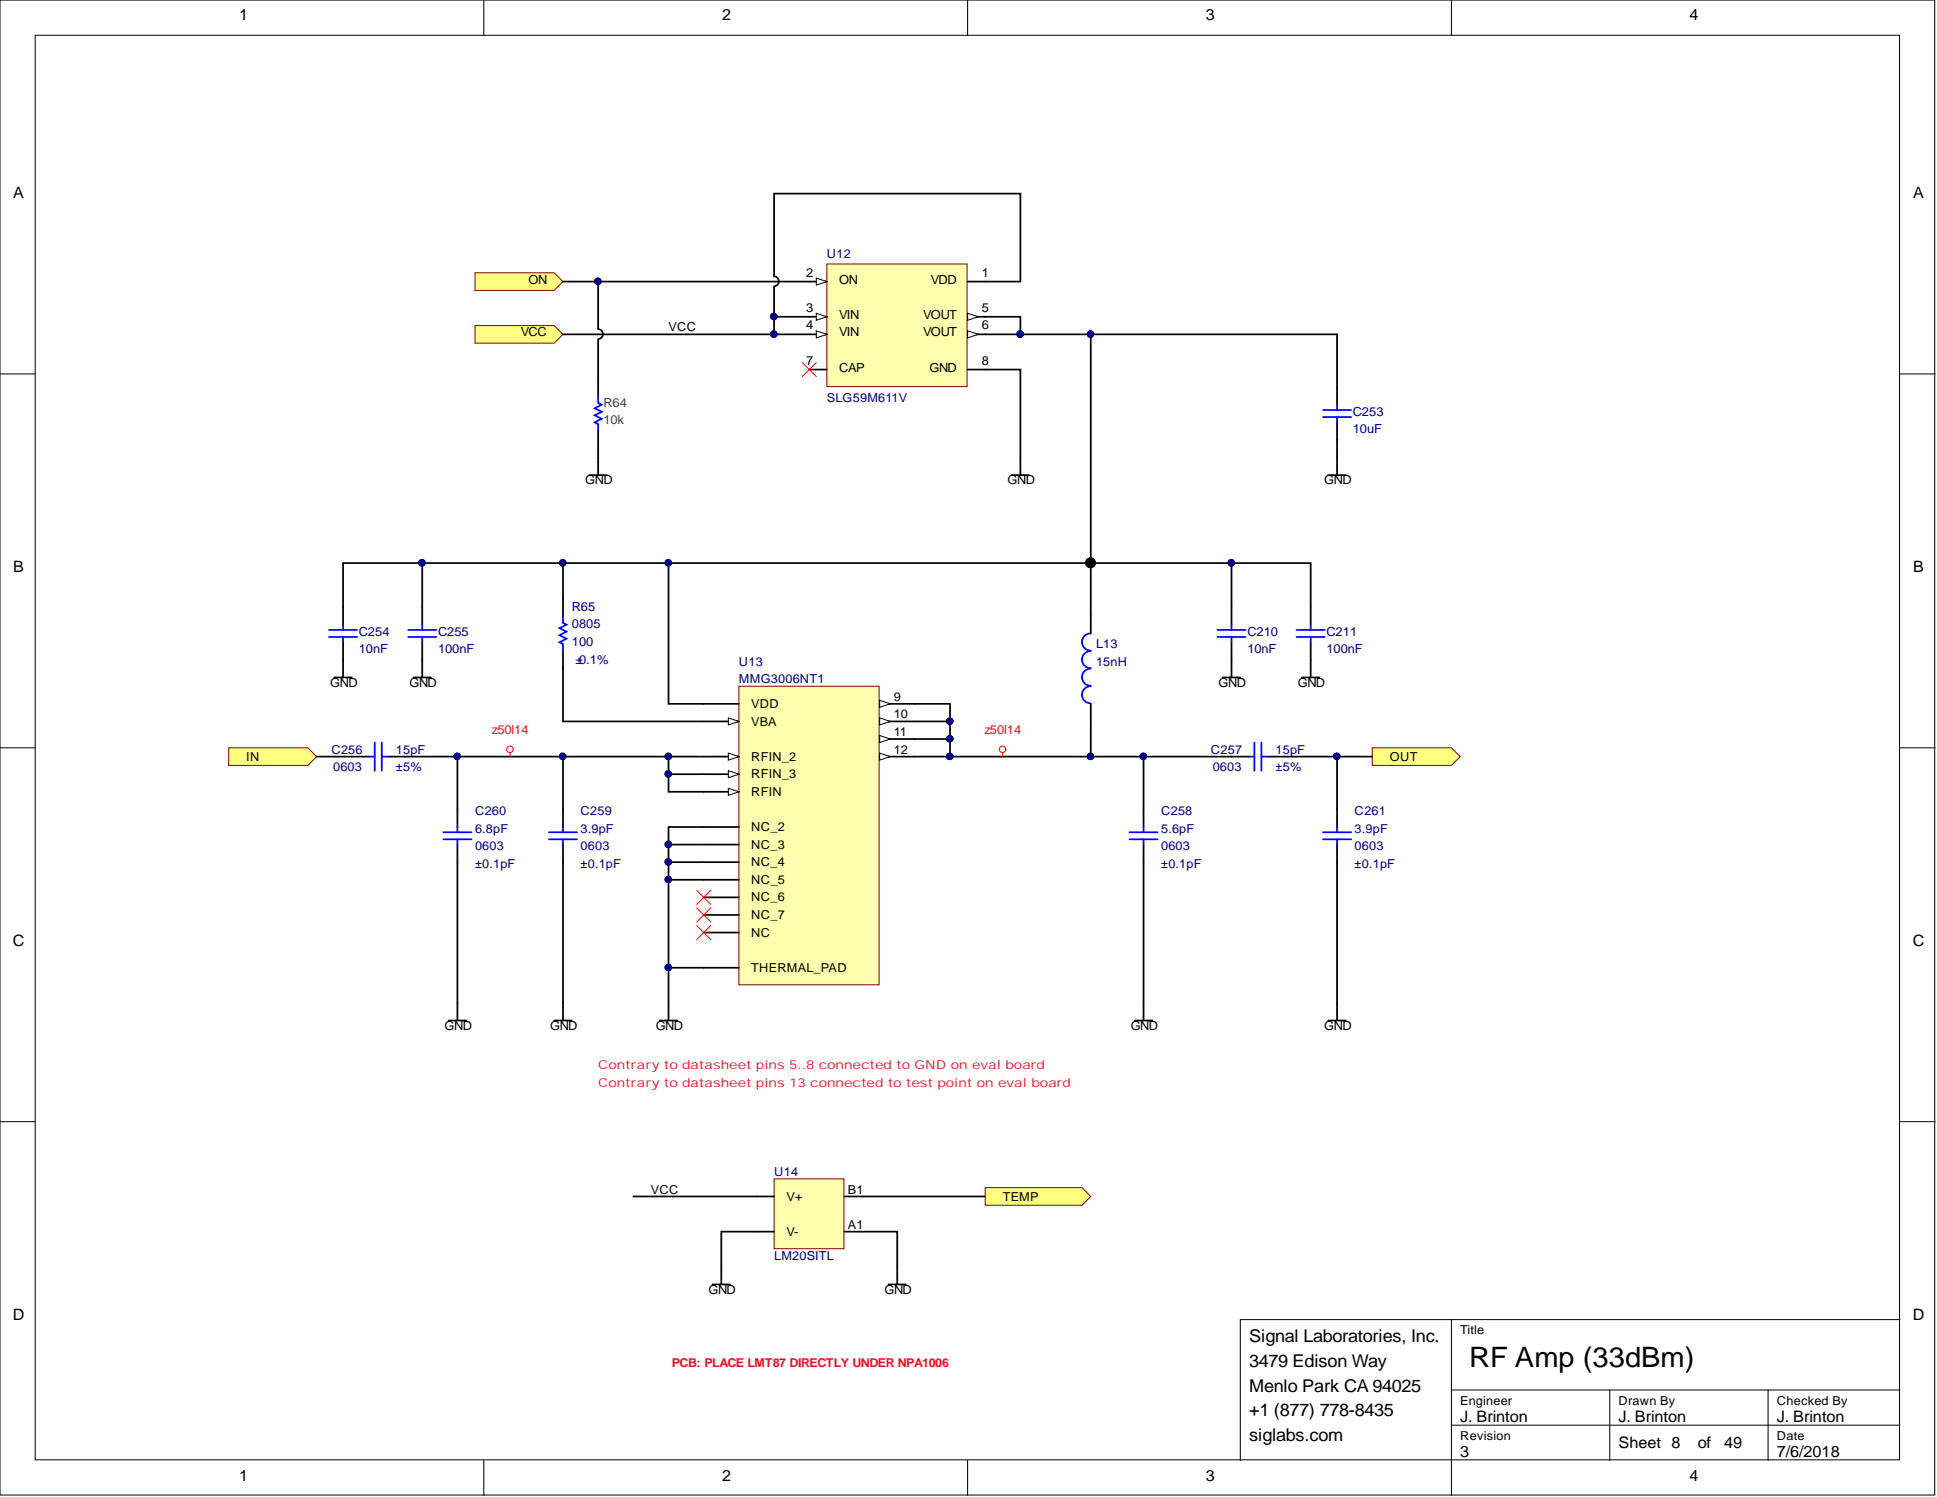
[picture p25: page 8]

VCC | | GND

CAP 7 | 8

Contrary to datasheet pins 5..8 connected to GND on eval board
Contrary to datasheet pins 13 connected to test point on eval board

PCB: PLACE LMT87 DIRECTLY UNDER NPA1006

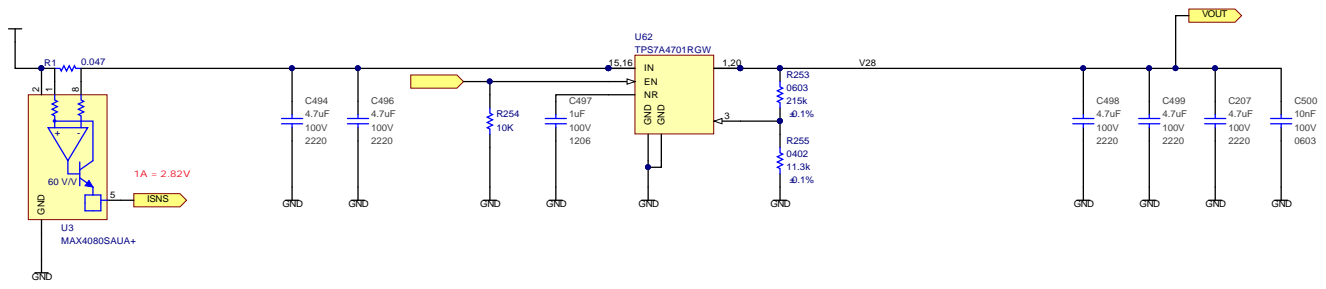
[picture p26: page 9]

Si g n a l L a b ora t ori es, I nc. 3 4 7 9 Ed iso n W a y Me n l o Park C A + 1 (8 7) 8-8 si g l a bs.co m | T itl e Power Amplifier

En g i n e e r J . Brinton | Dra w n By J . Brinton | C h e c k e d By J . Brinton

R e v i s i o n | | D ate 7/6/2018 Sheet 9 of 49

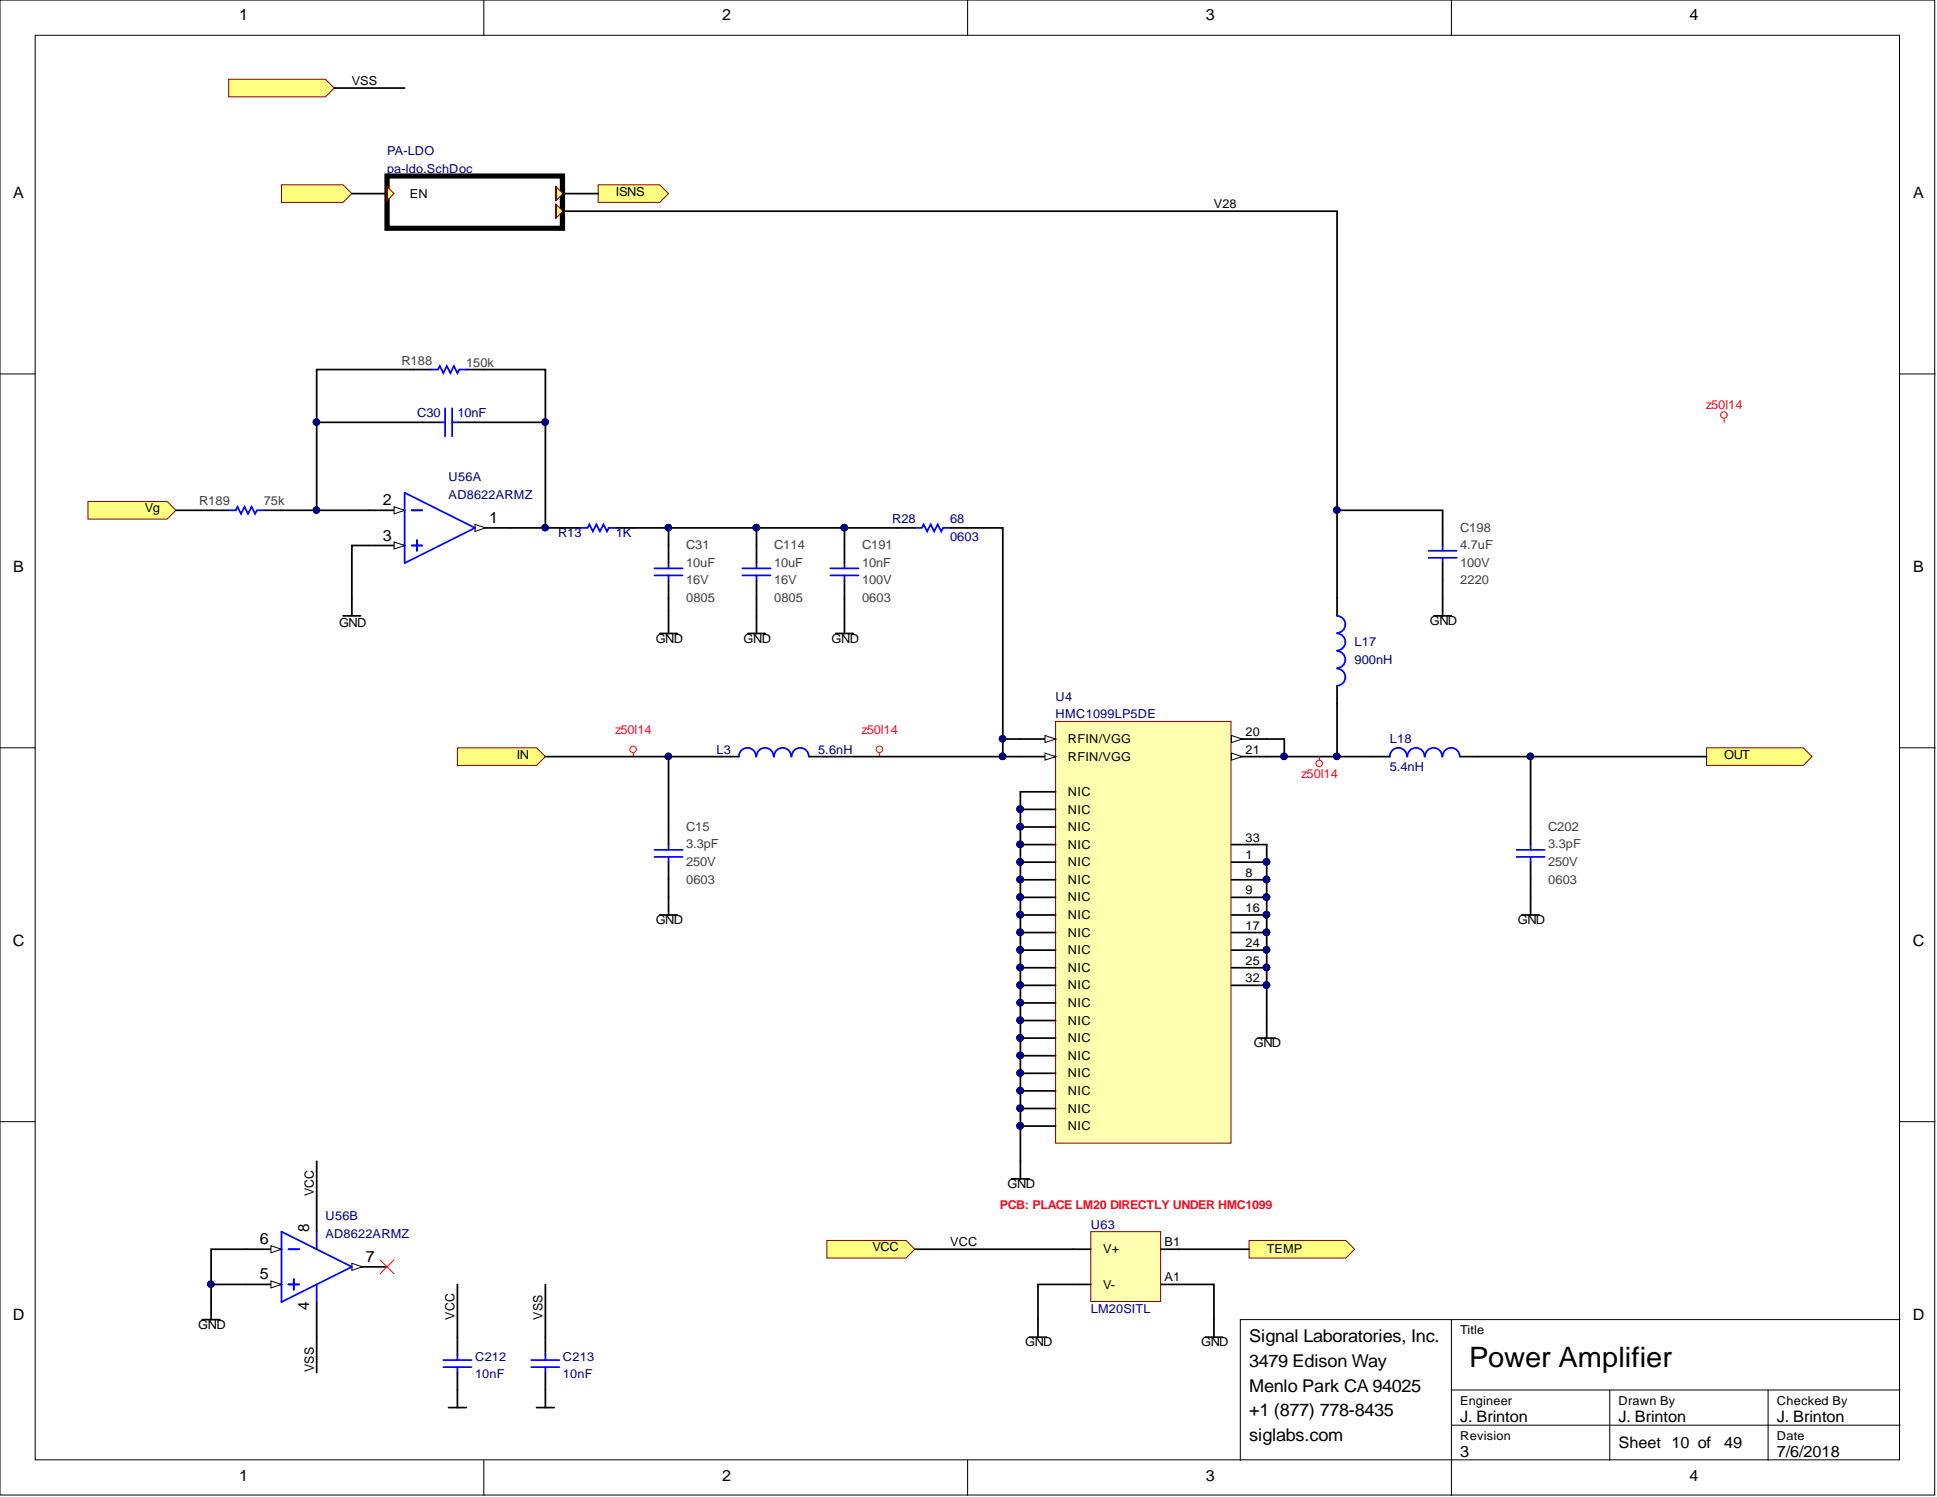
[picture p27: page 10]

GND
PCB: PLACE LM20 DIRECTLY UNDER HMC1099

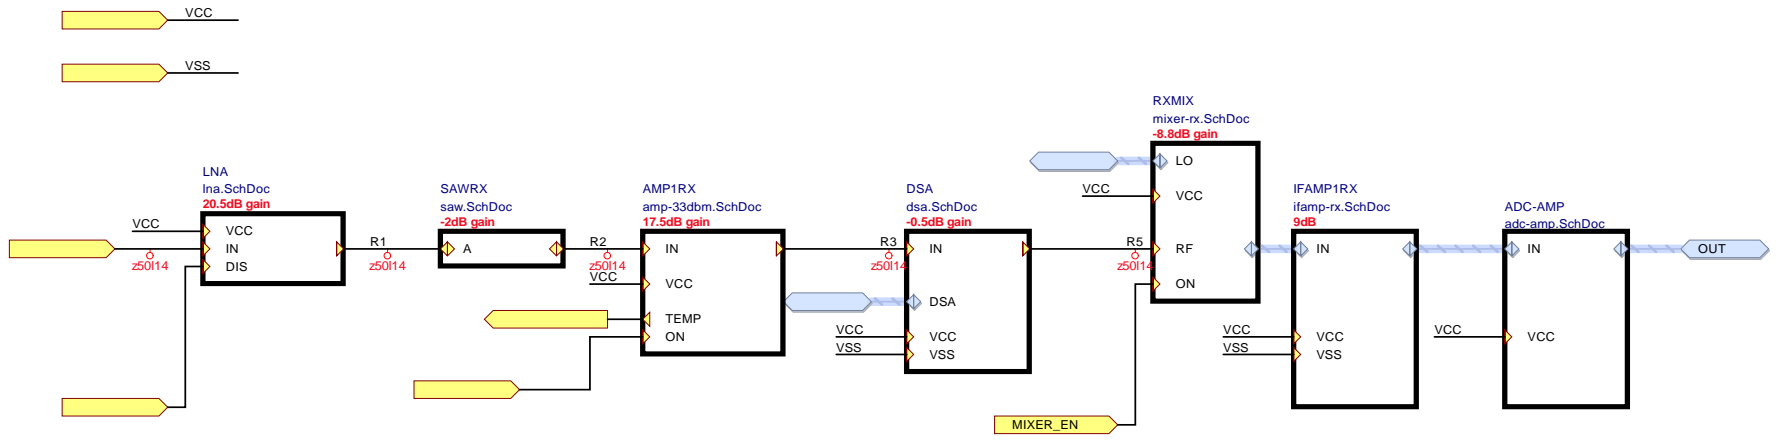
[picture p28: page 11]

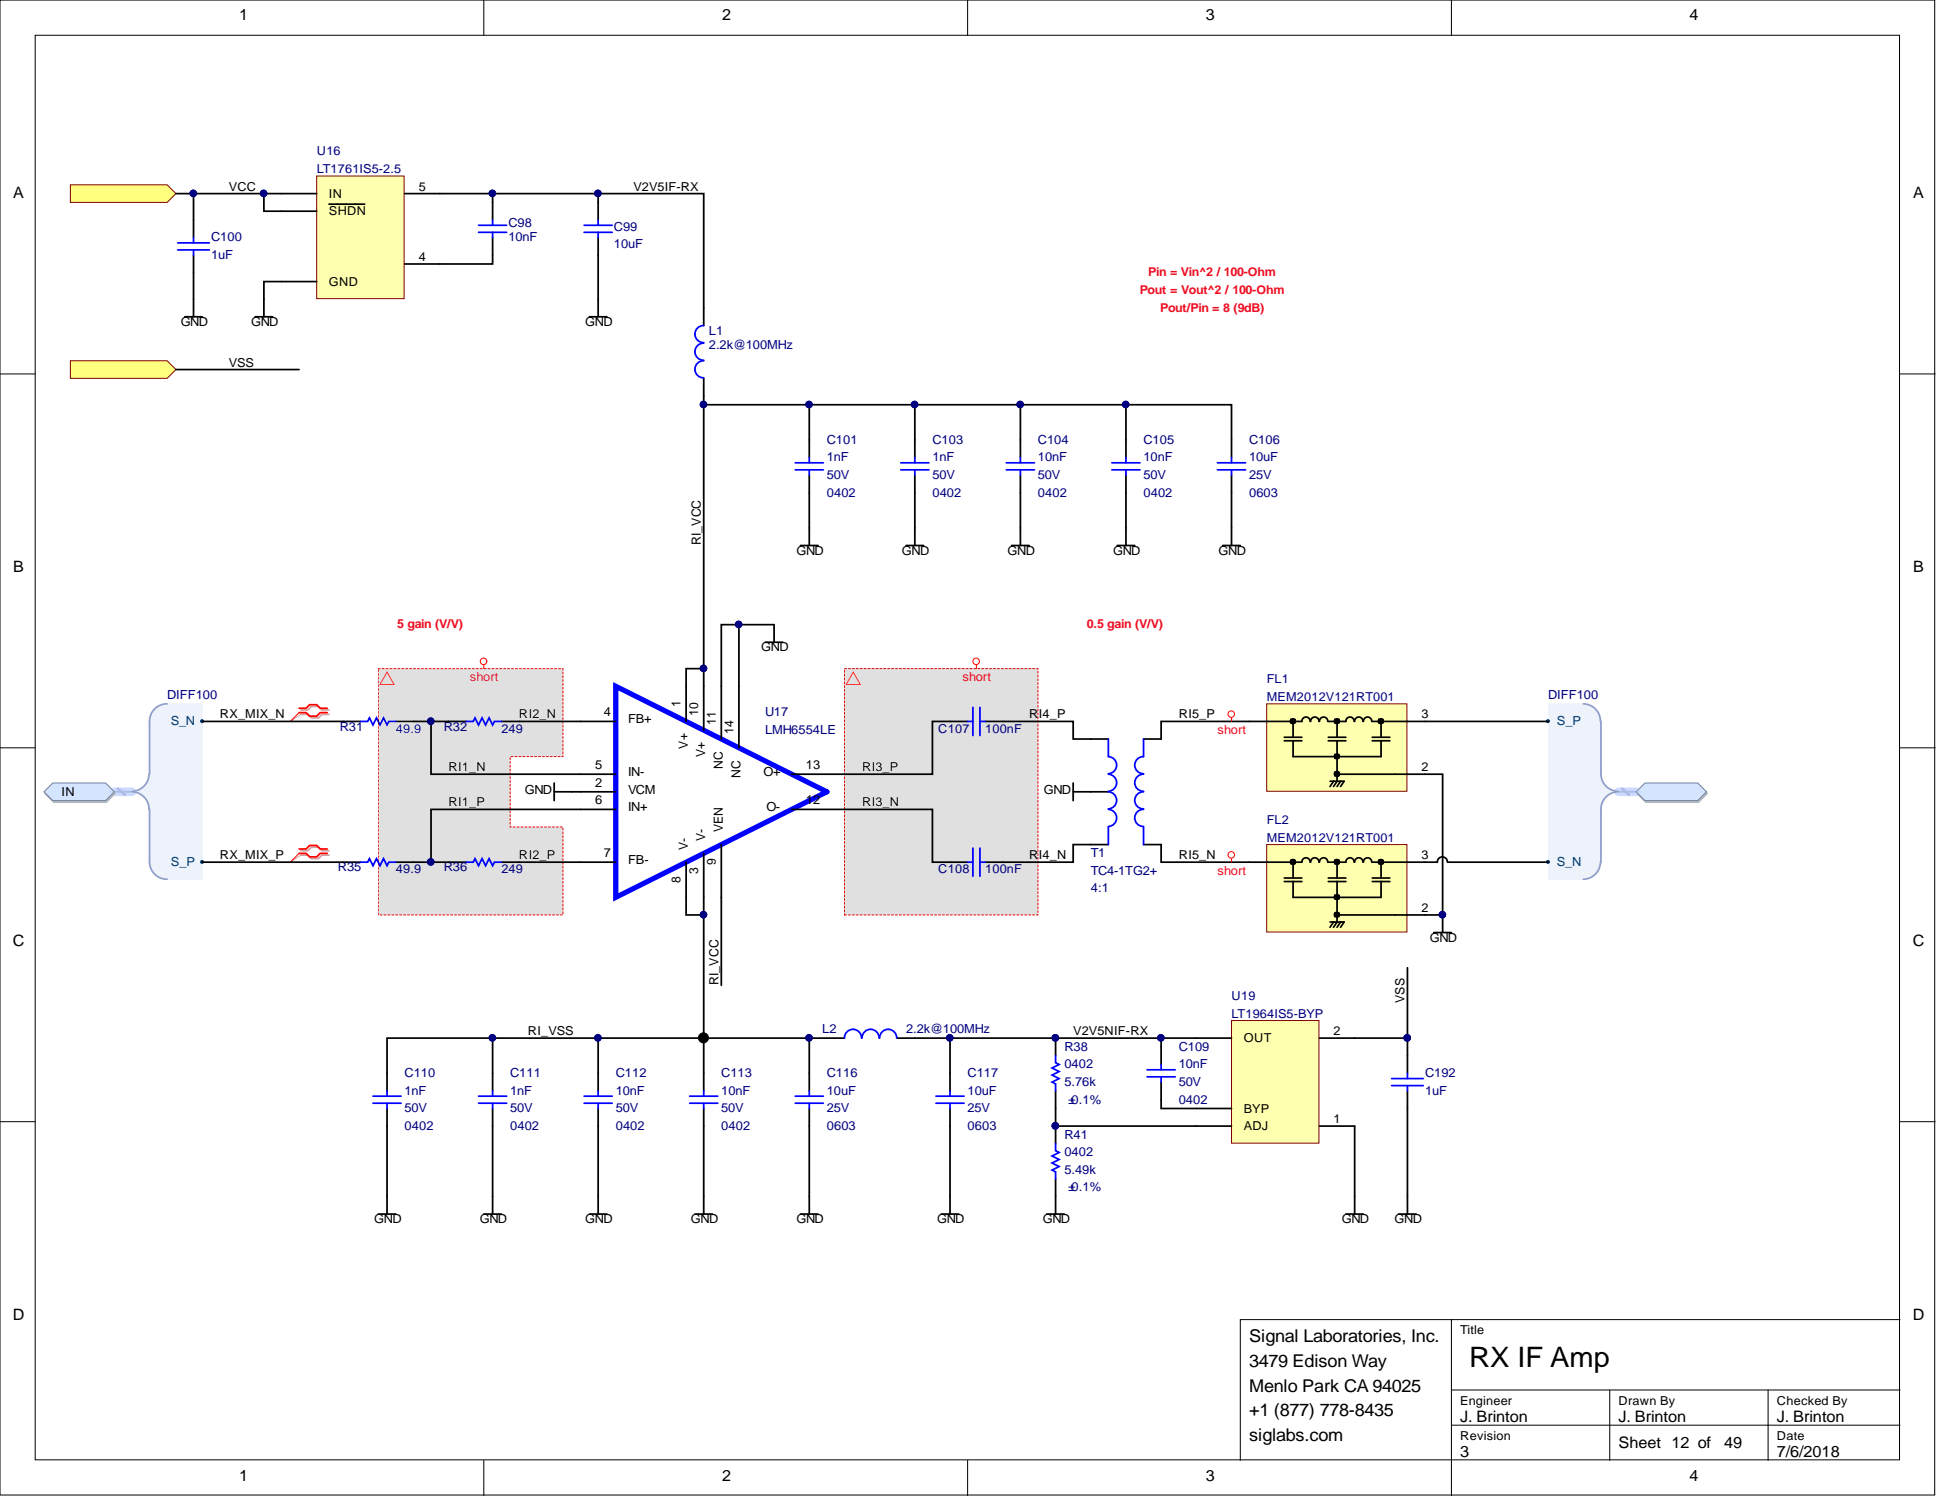
[picture p29: page 12]

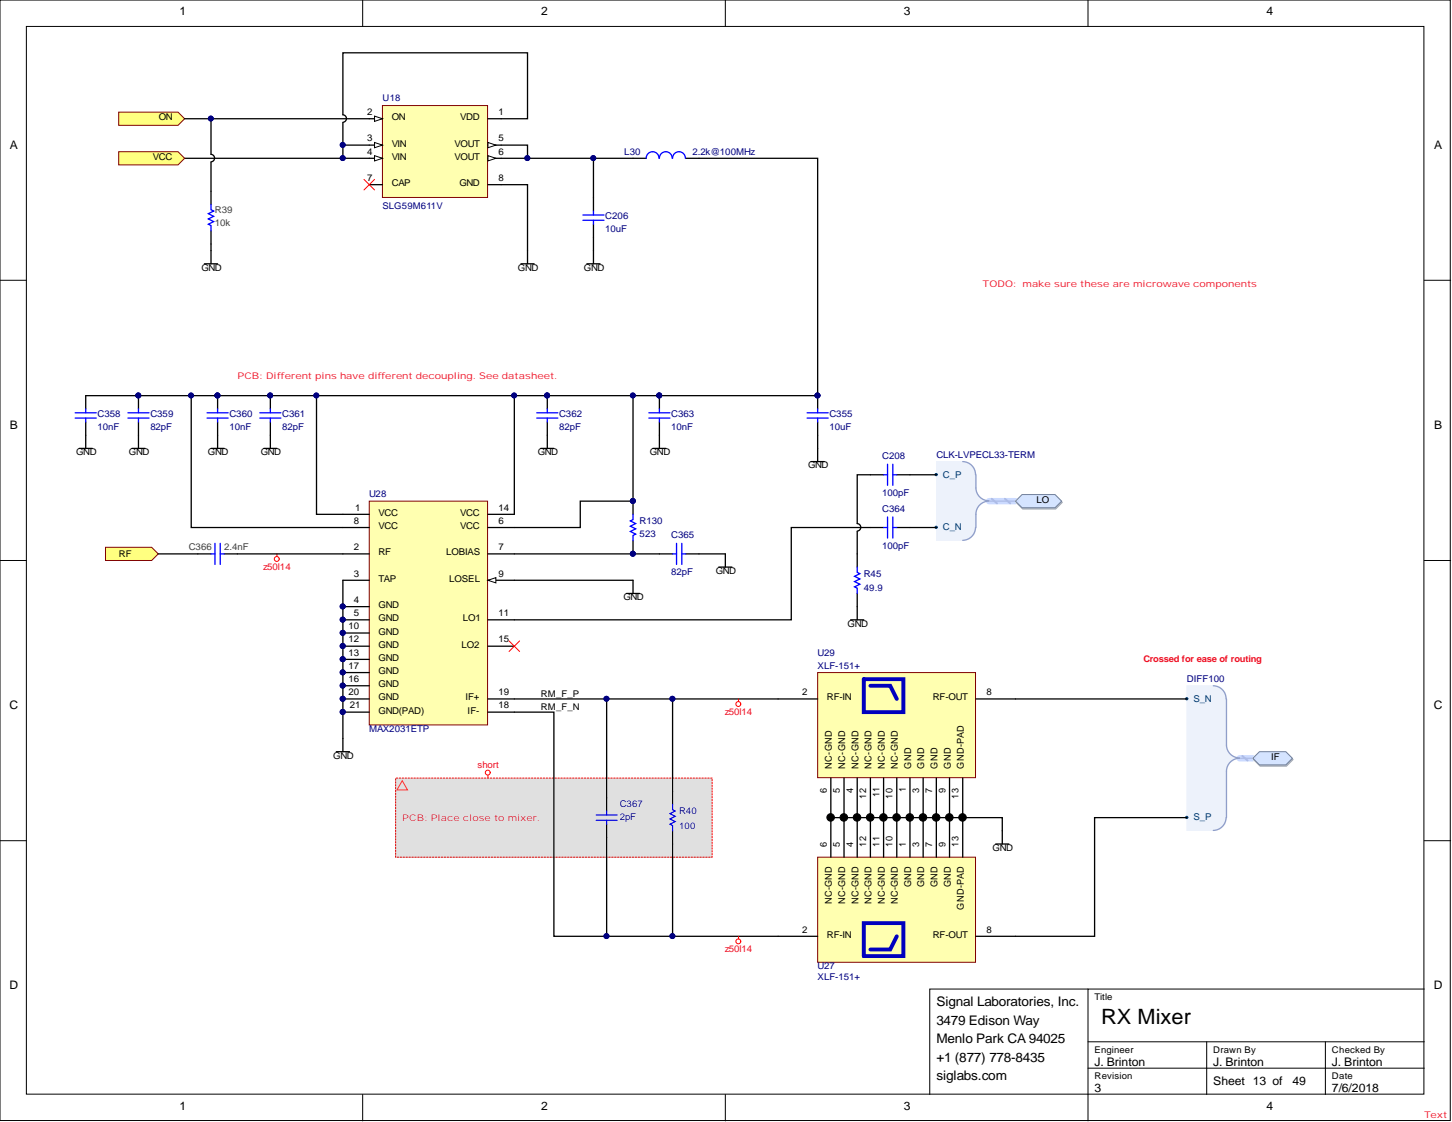
[picture p30: page 13]

TODO: make sure these are microwave components

PCB: Different pins have different decoupling. See datasheet.

Crossed for ease of routing

NC-GND 4 NC-GND 5 NC-GND 6

NC-GND 10 NC-GND 11 NC-GND 12

PCB: Place close to mixer.

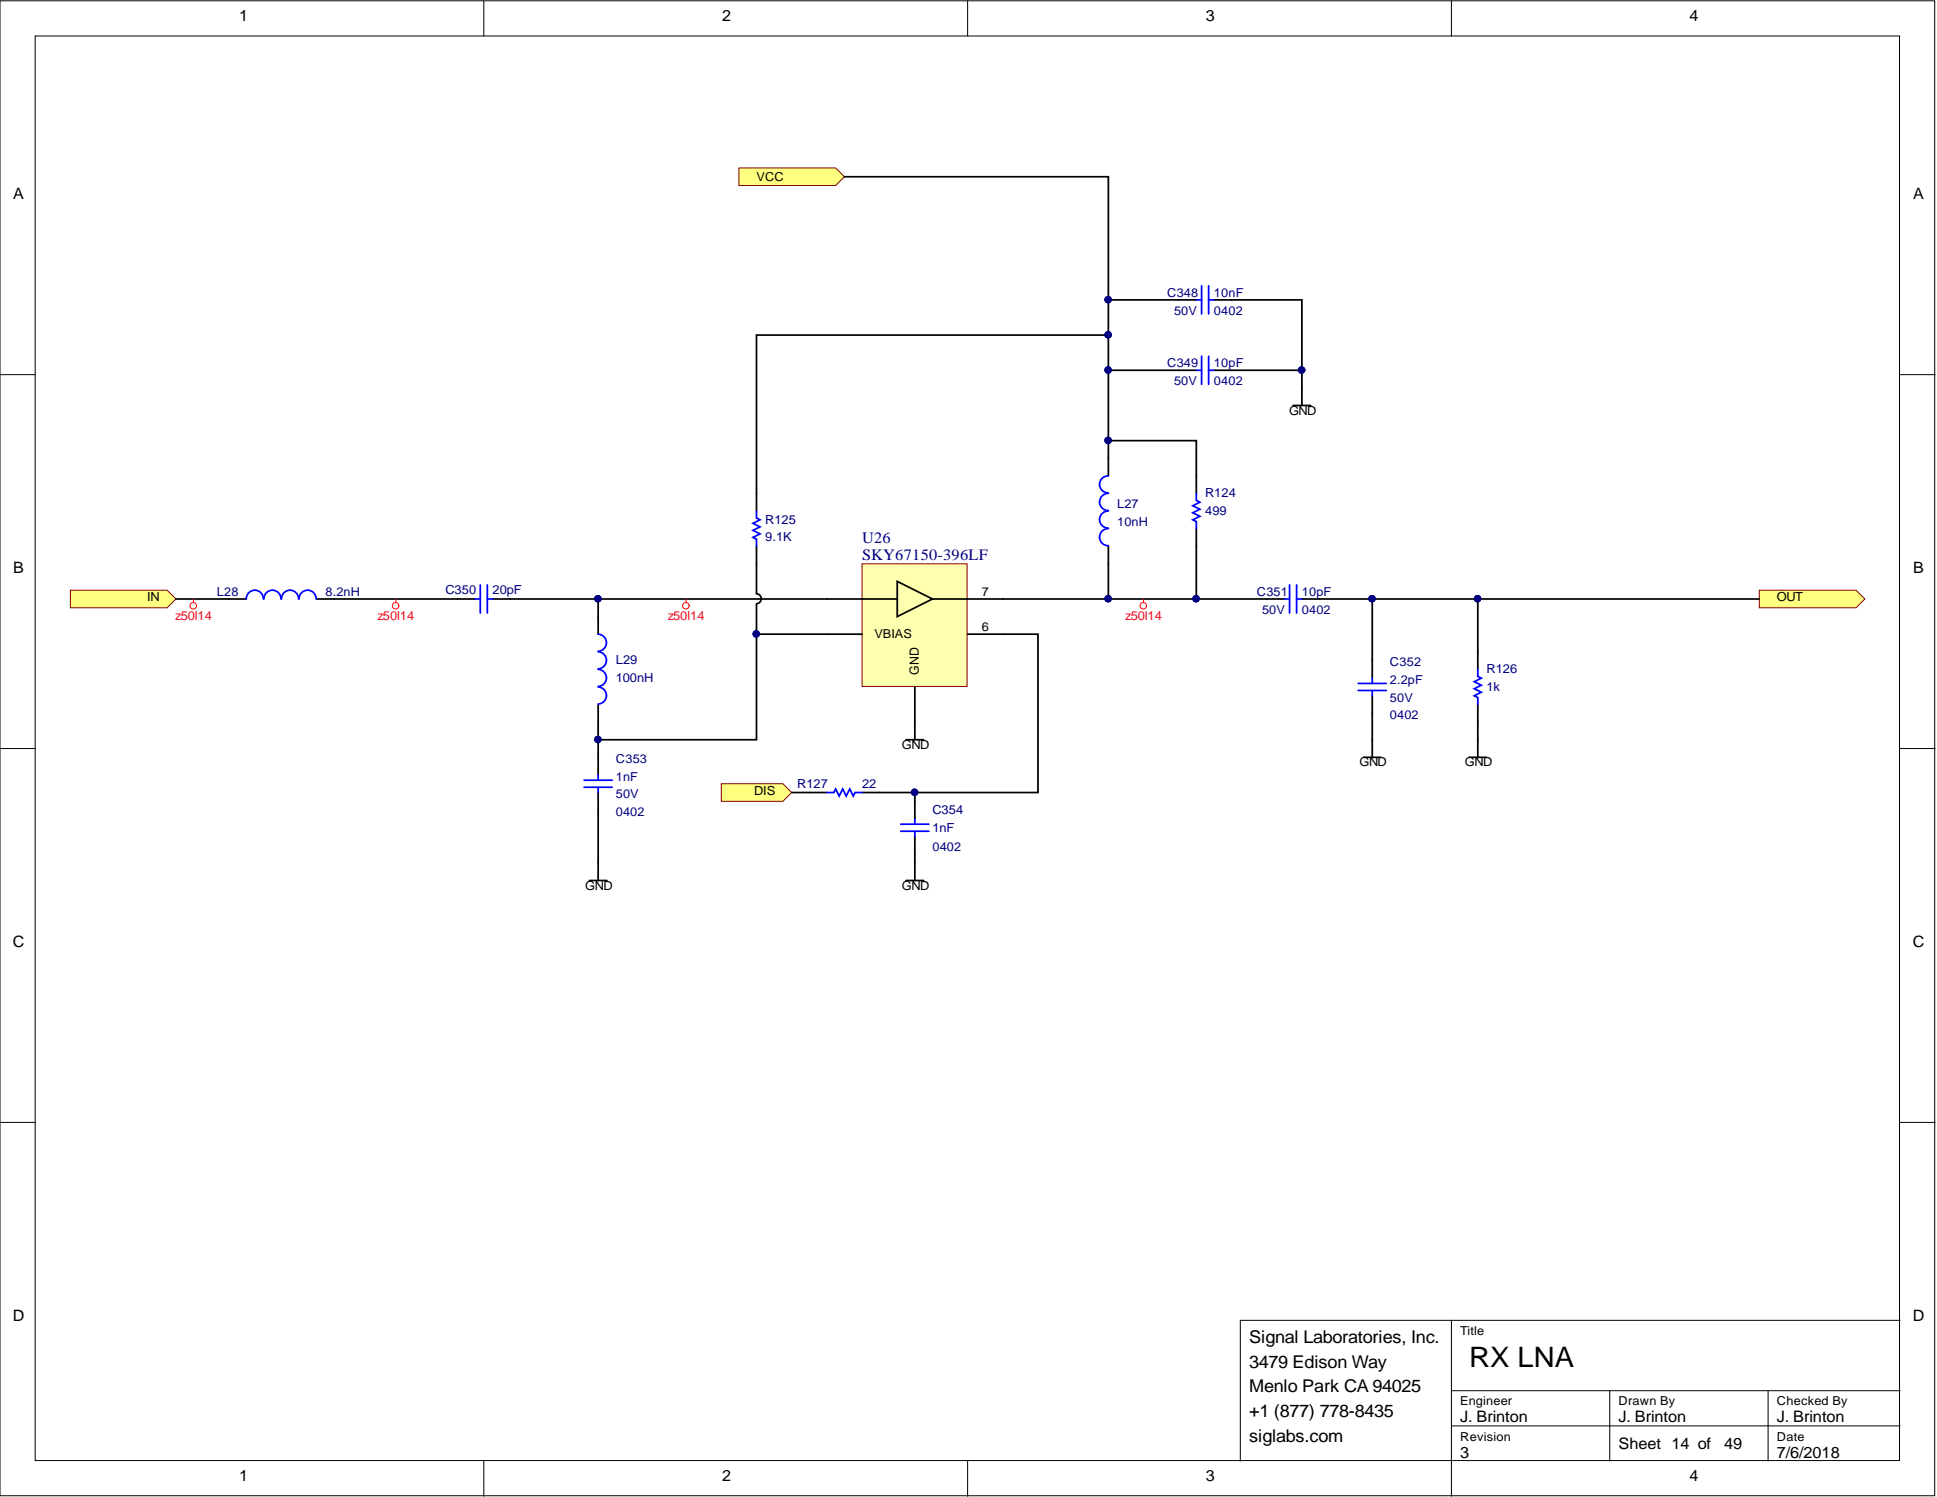
[picture p31: page 14]

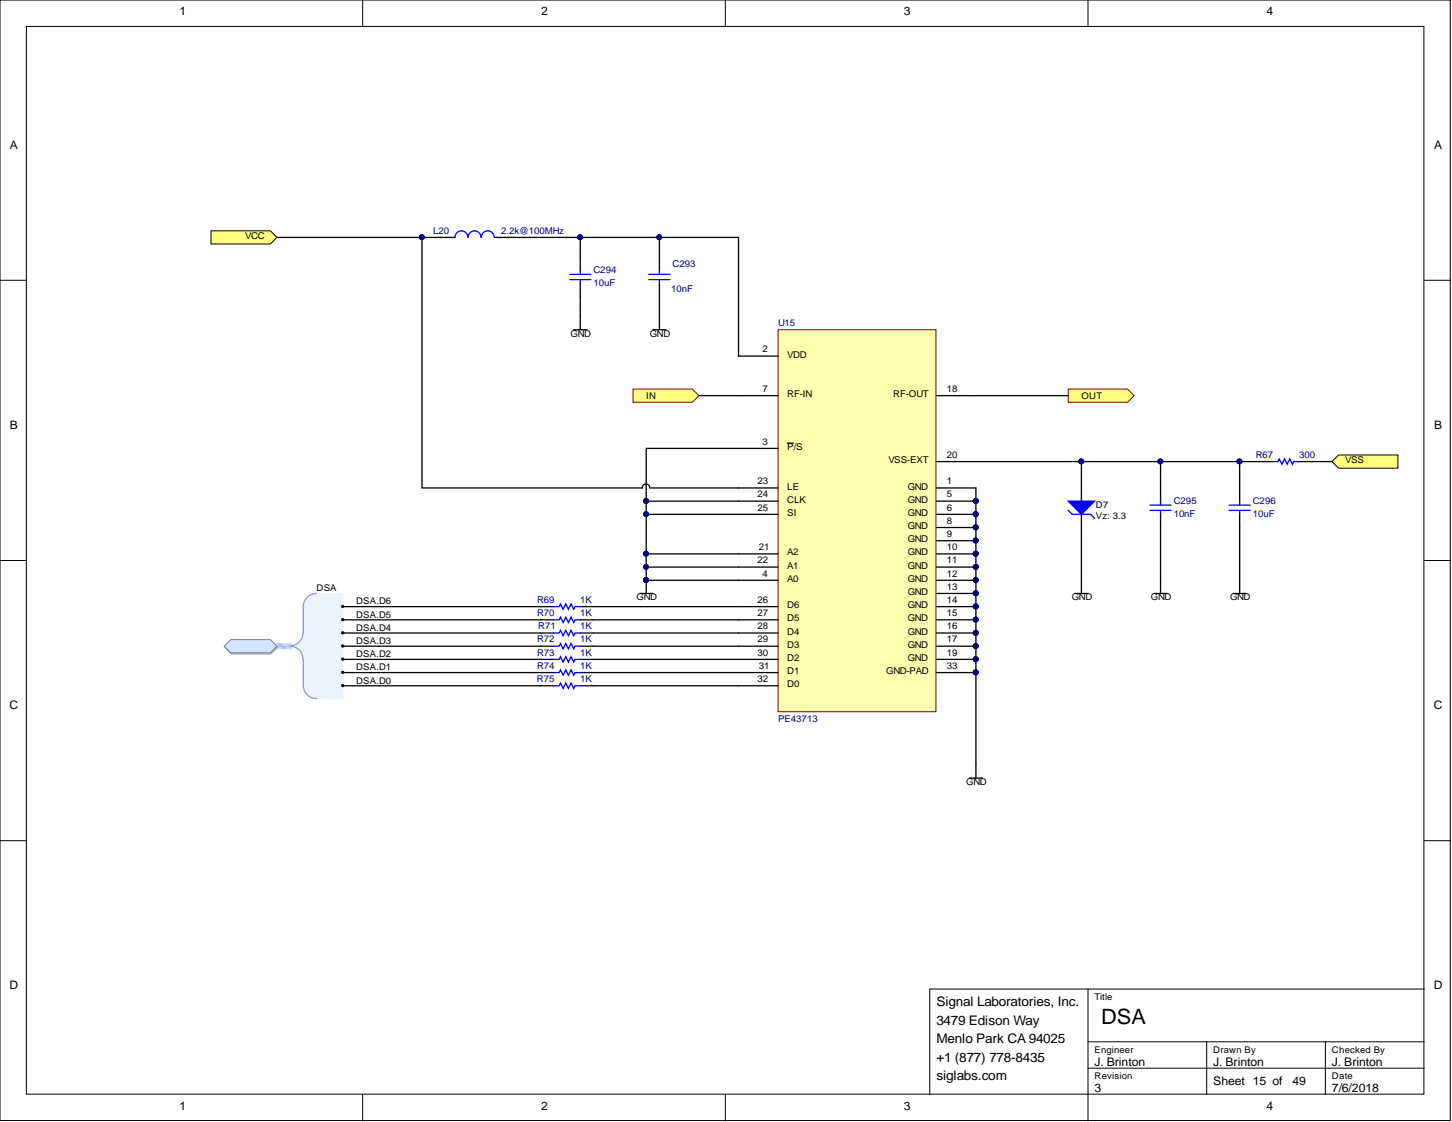
[picture p32: page 15]

LE 23 CLK 24

Si g n a l L a b ora t ori es, I nc. 3 4 7 9 Ed iso n W a y Me n l o Park C A + 1 (8 7) 8-8 si g l a bs.co m | T itl e DSA

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

R e v i s i o n | | D ate 7/6/2018 Sheet 15 of 49

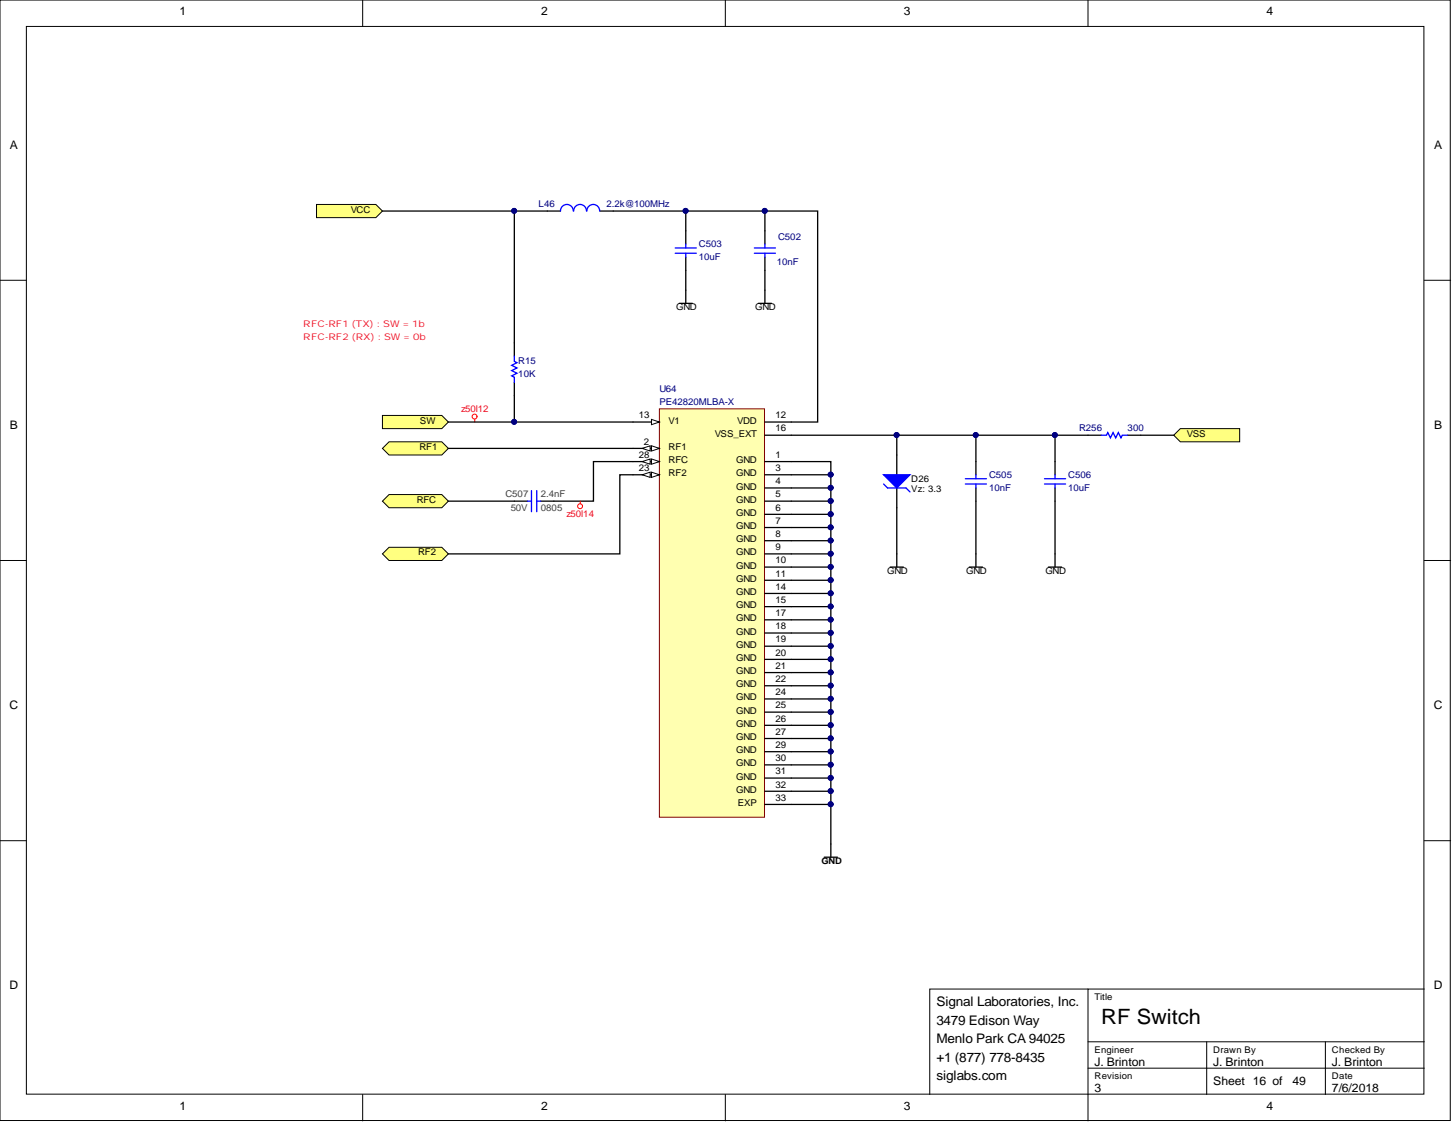
[picture p33: page 16]

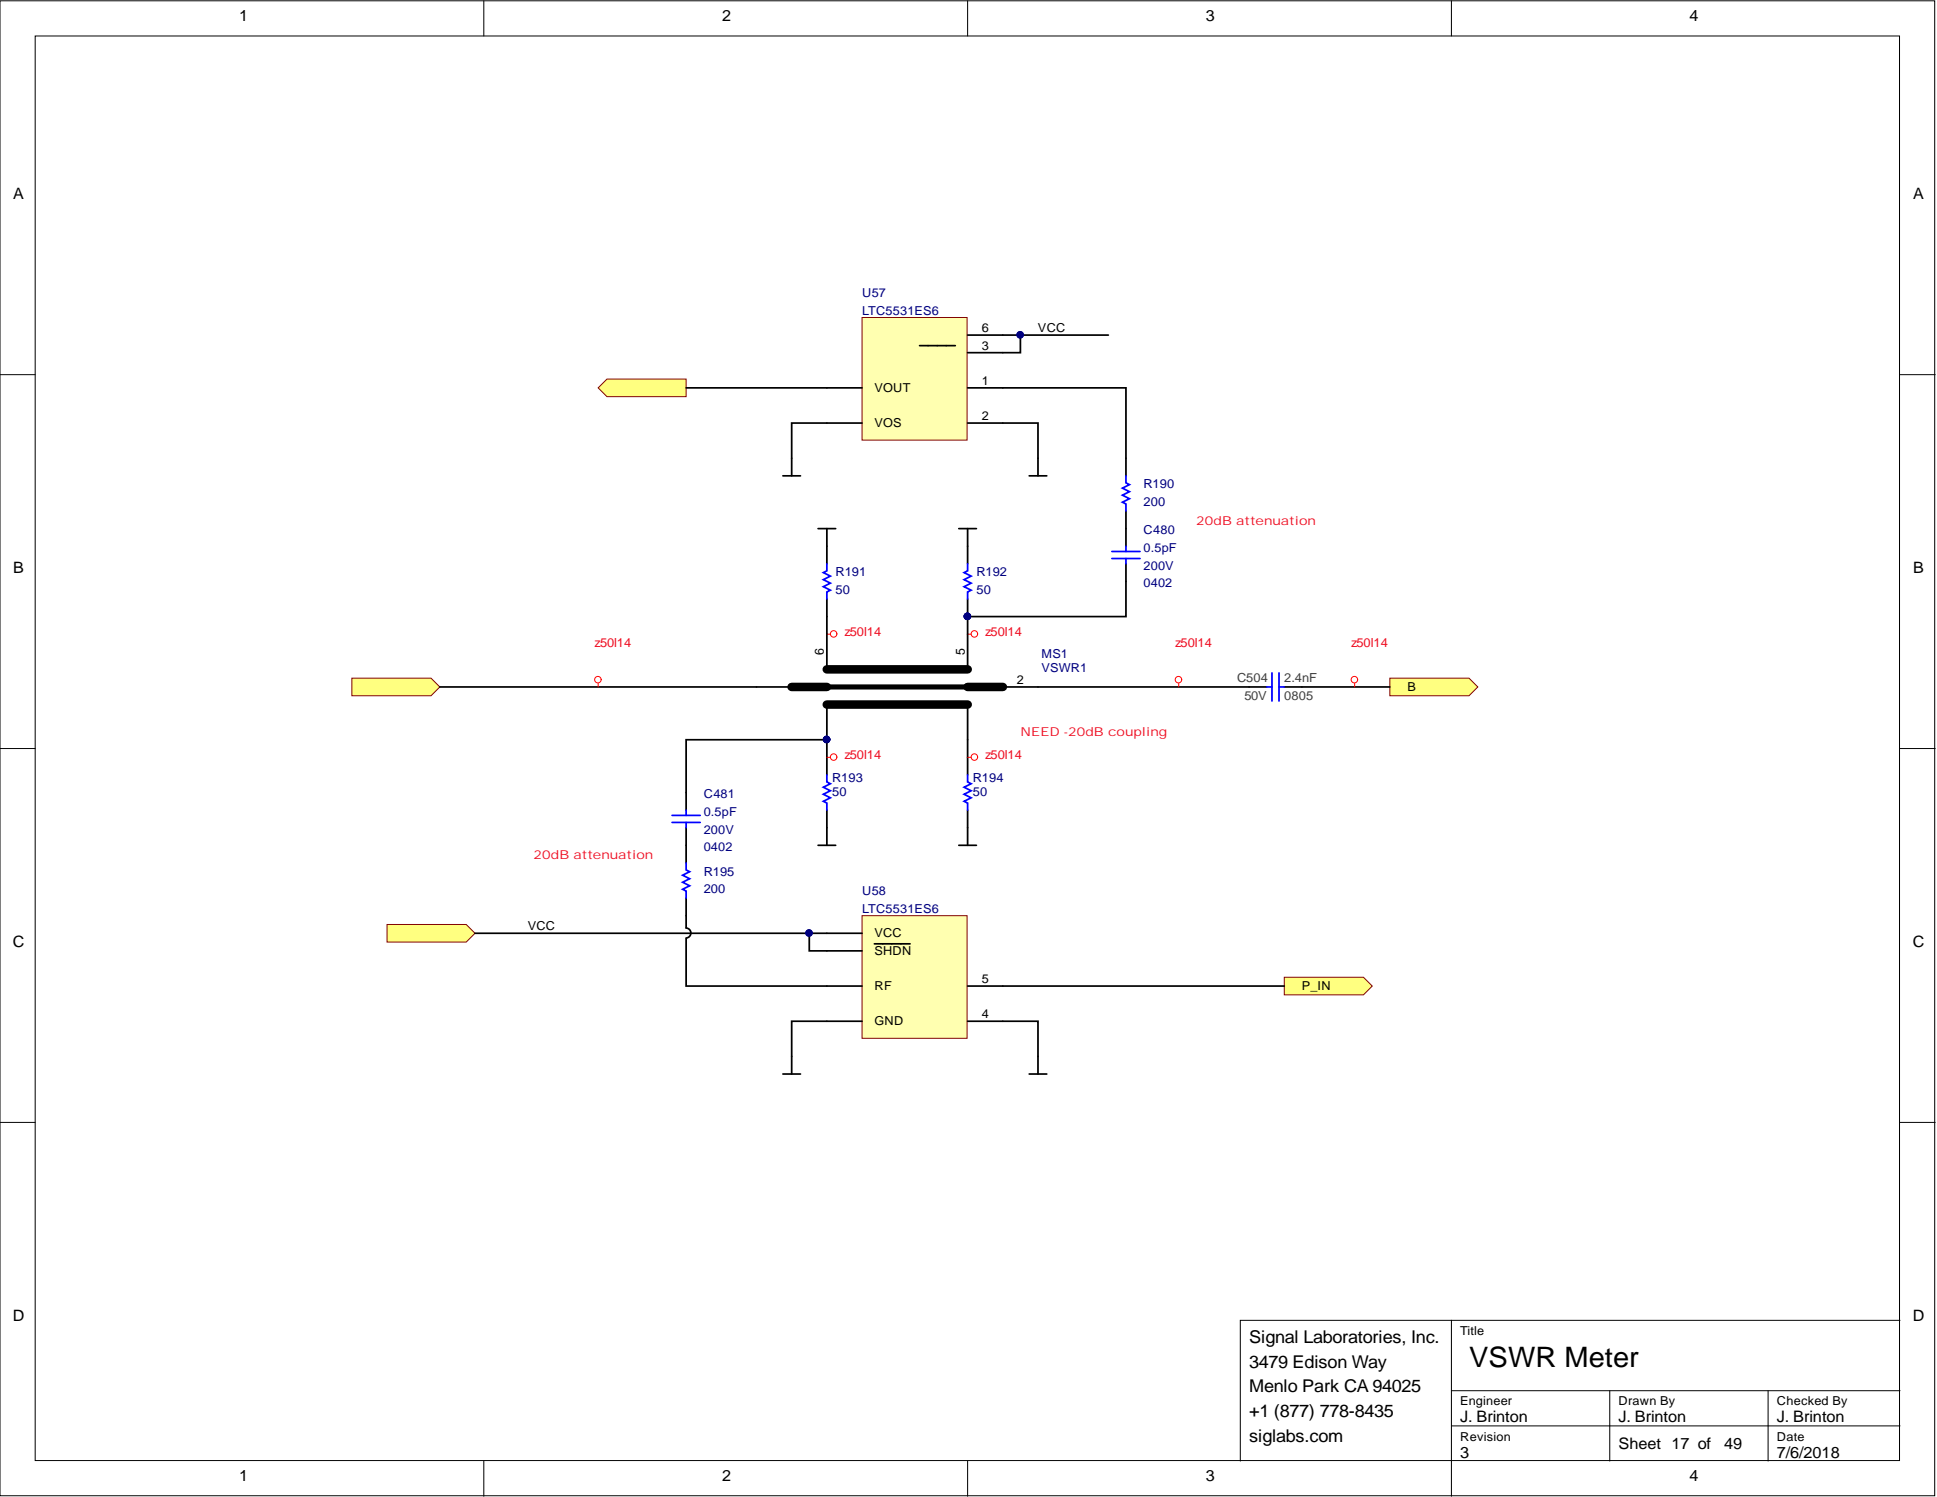
[picture p34: page 17]

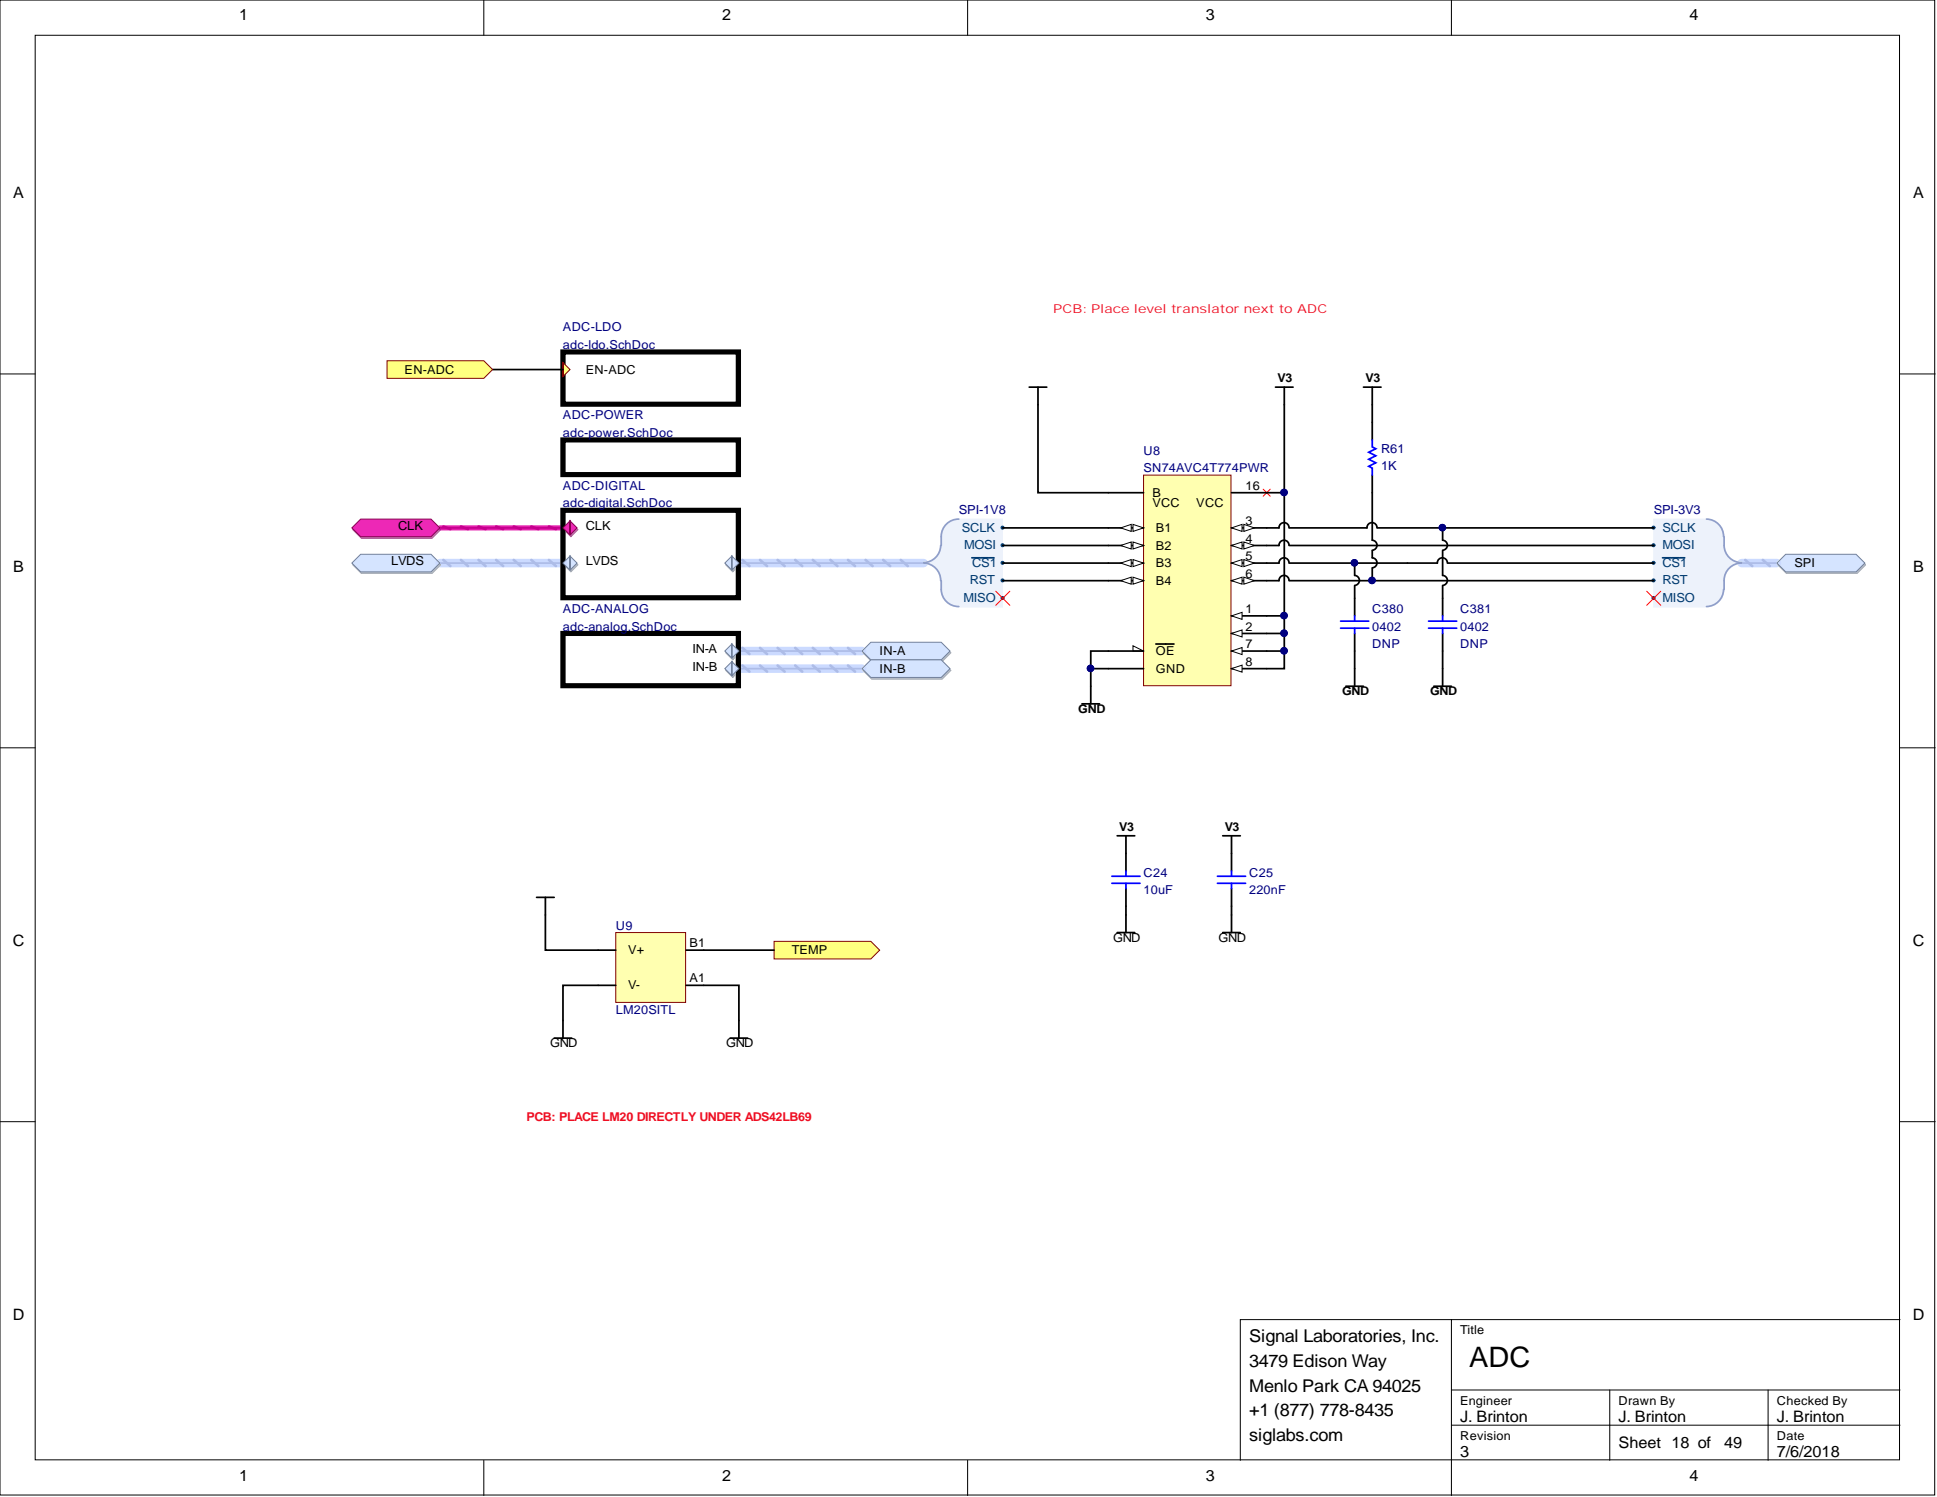
[picture p35: page 18]

PCB: Place level translator next to ADC

PCB: PLACE LM20 DIRECTLY UNDER ADS42LB69

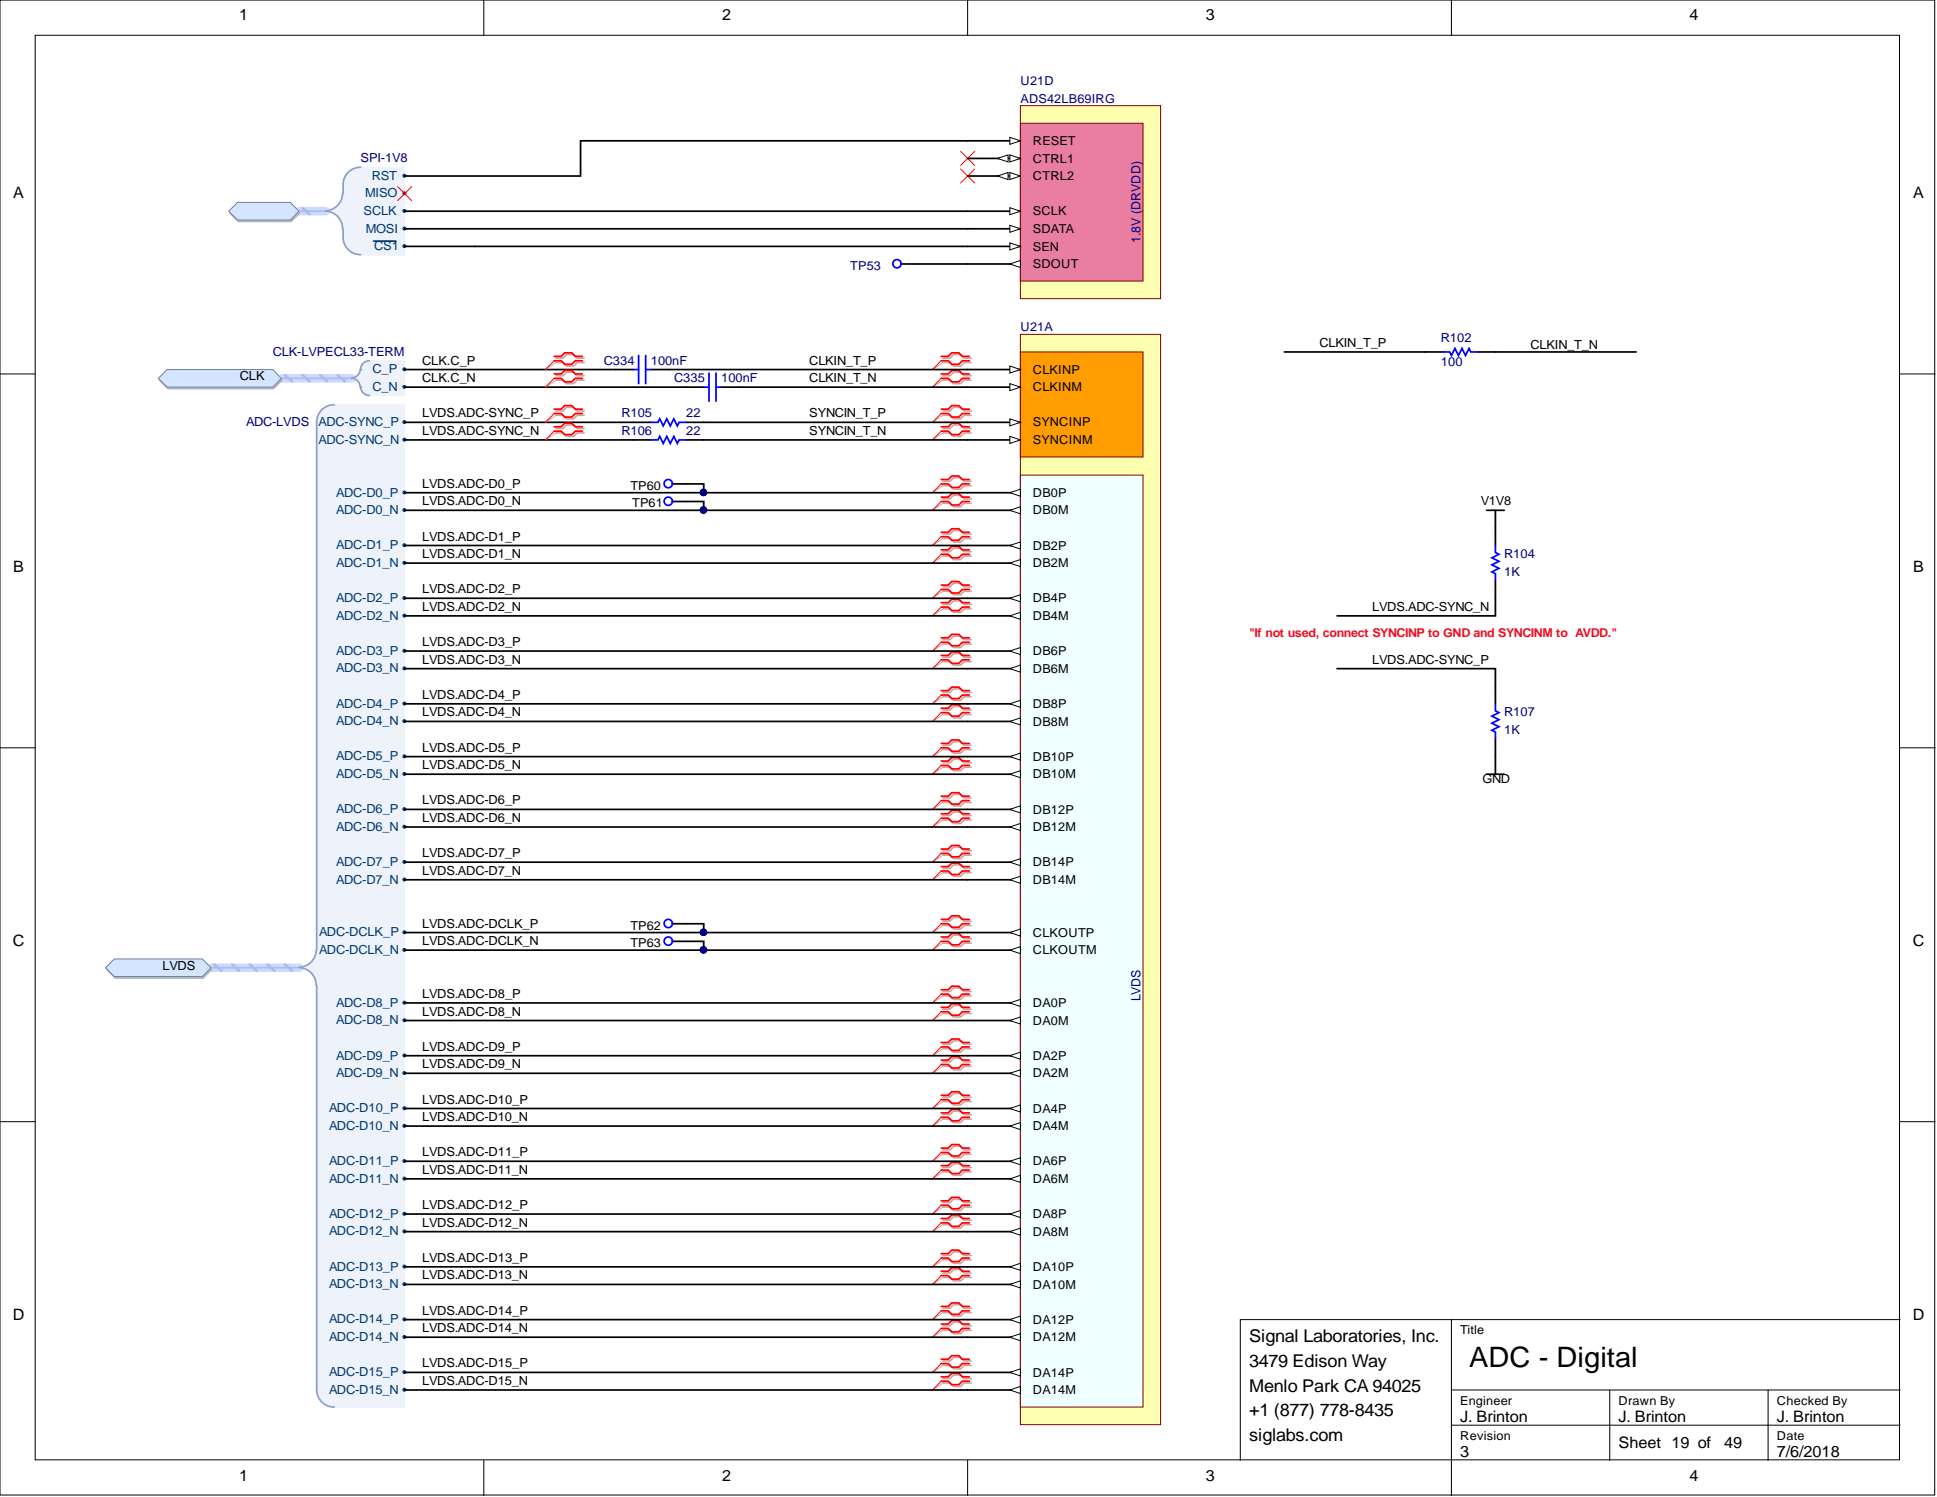
[picture p36: page 19]

"If not used, connect SYNCINP to GND and SYNCINM to AVDD."

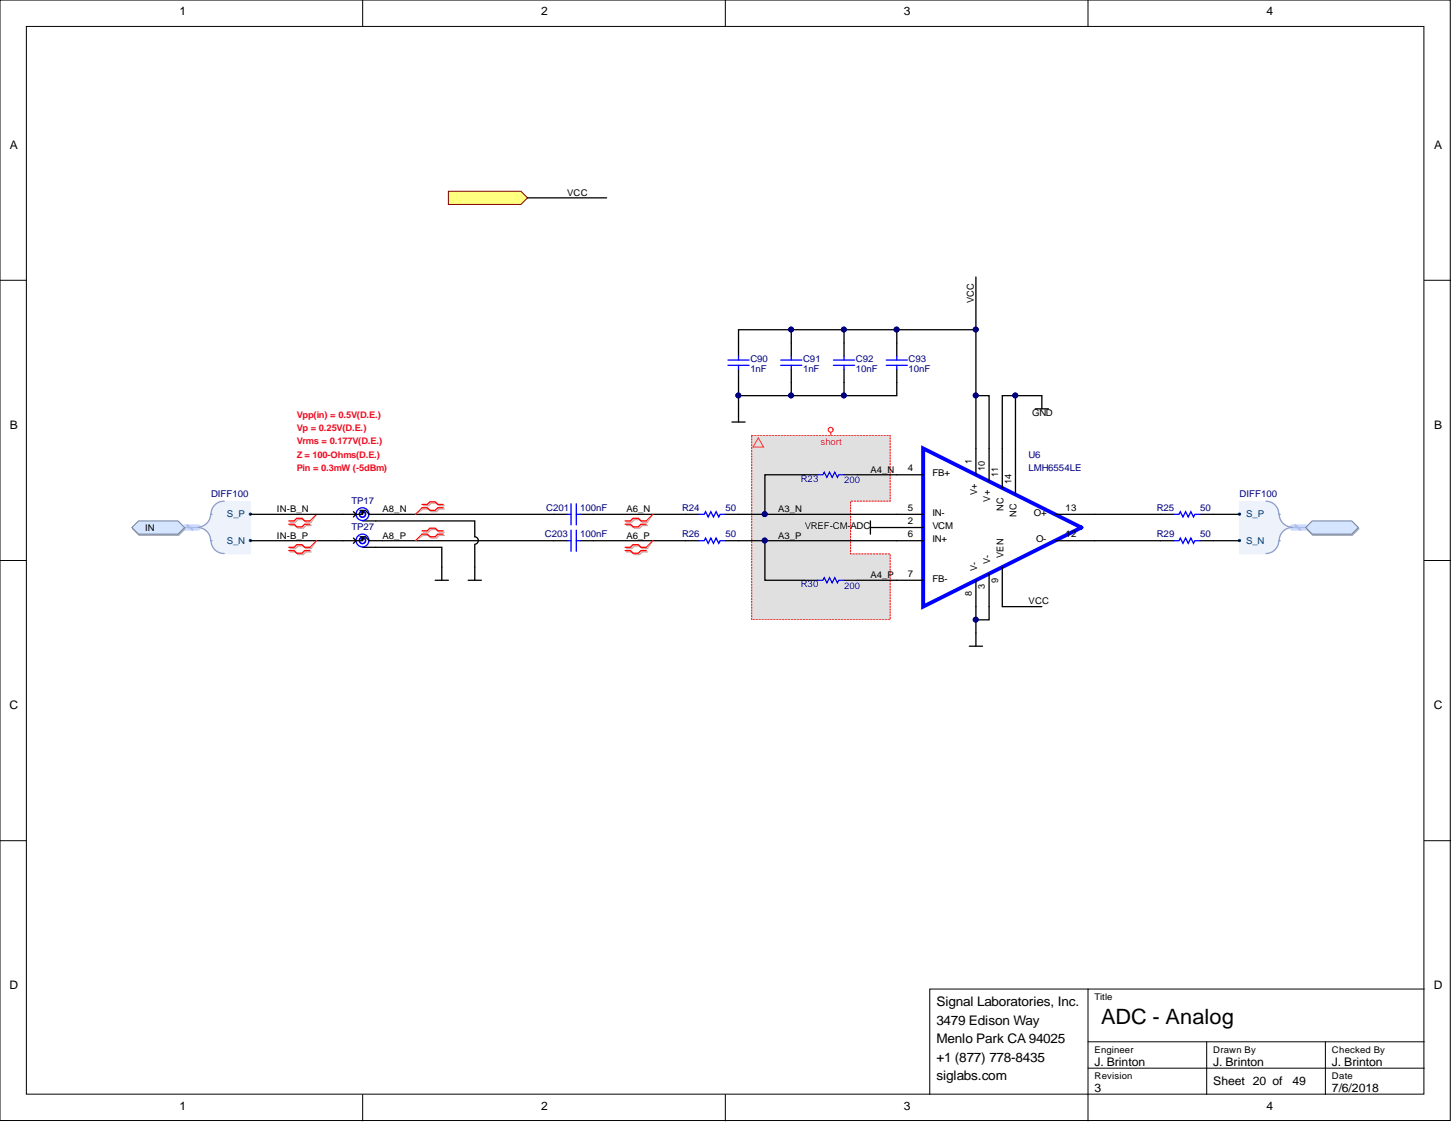
[picture p37: page 20]

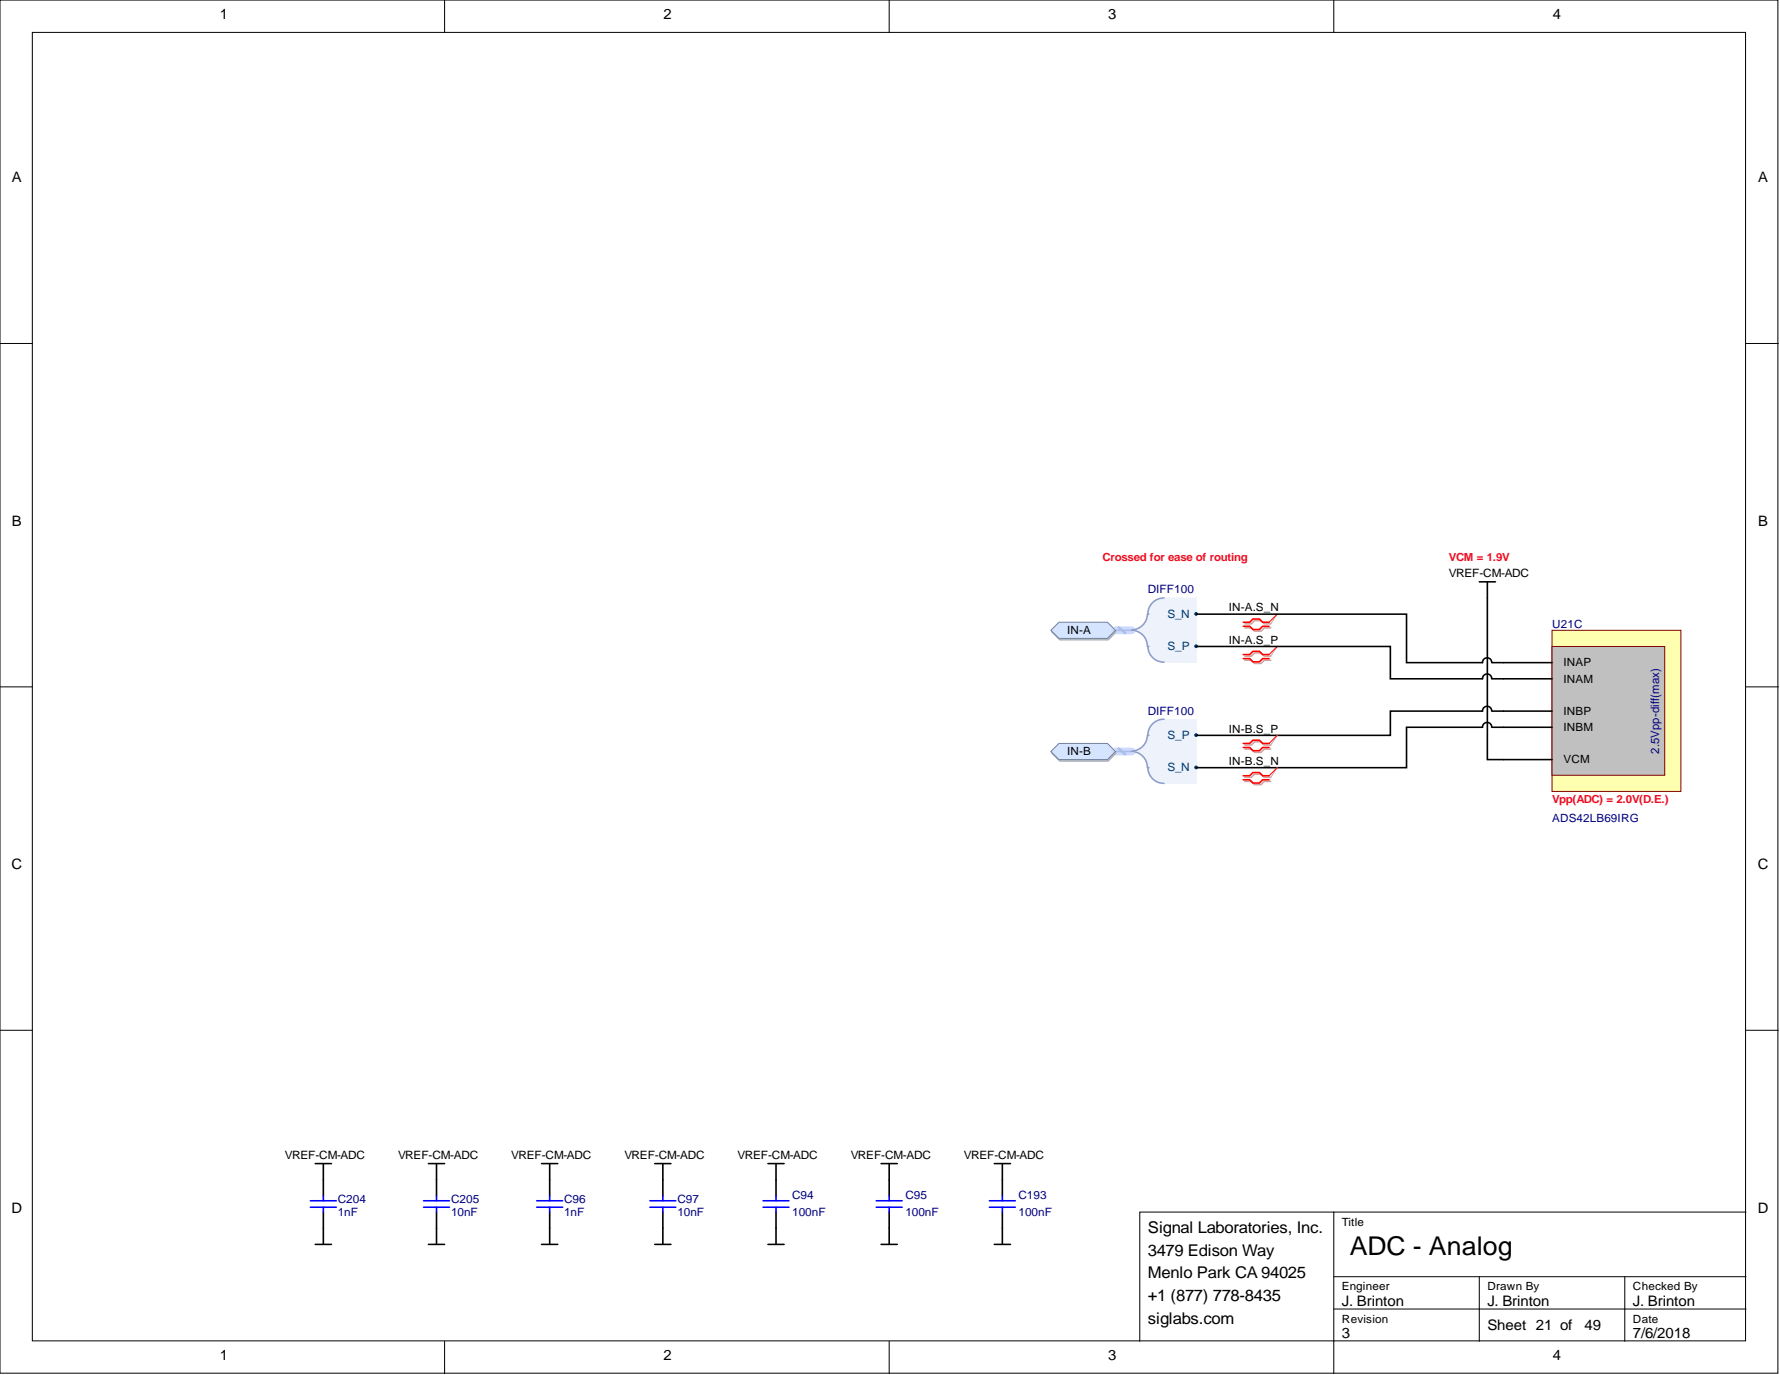
[picture p38: page 21]

Crossed for ease of routing

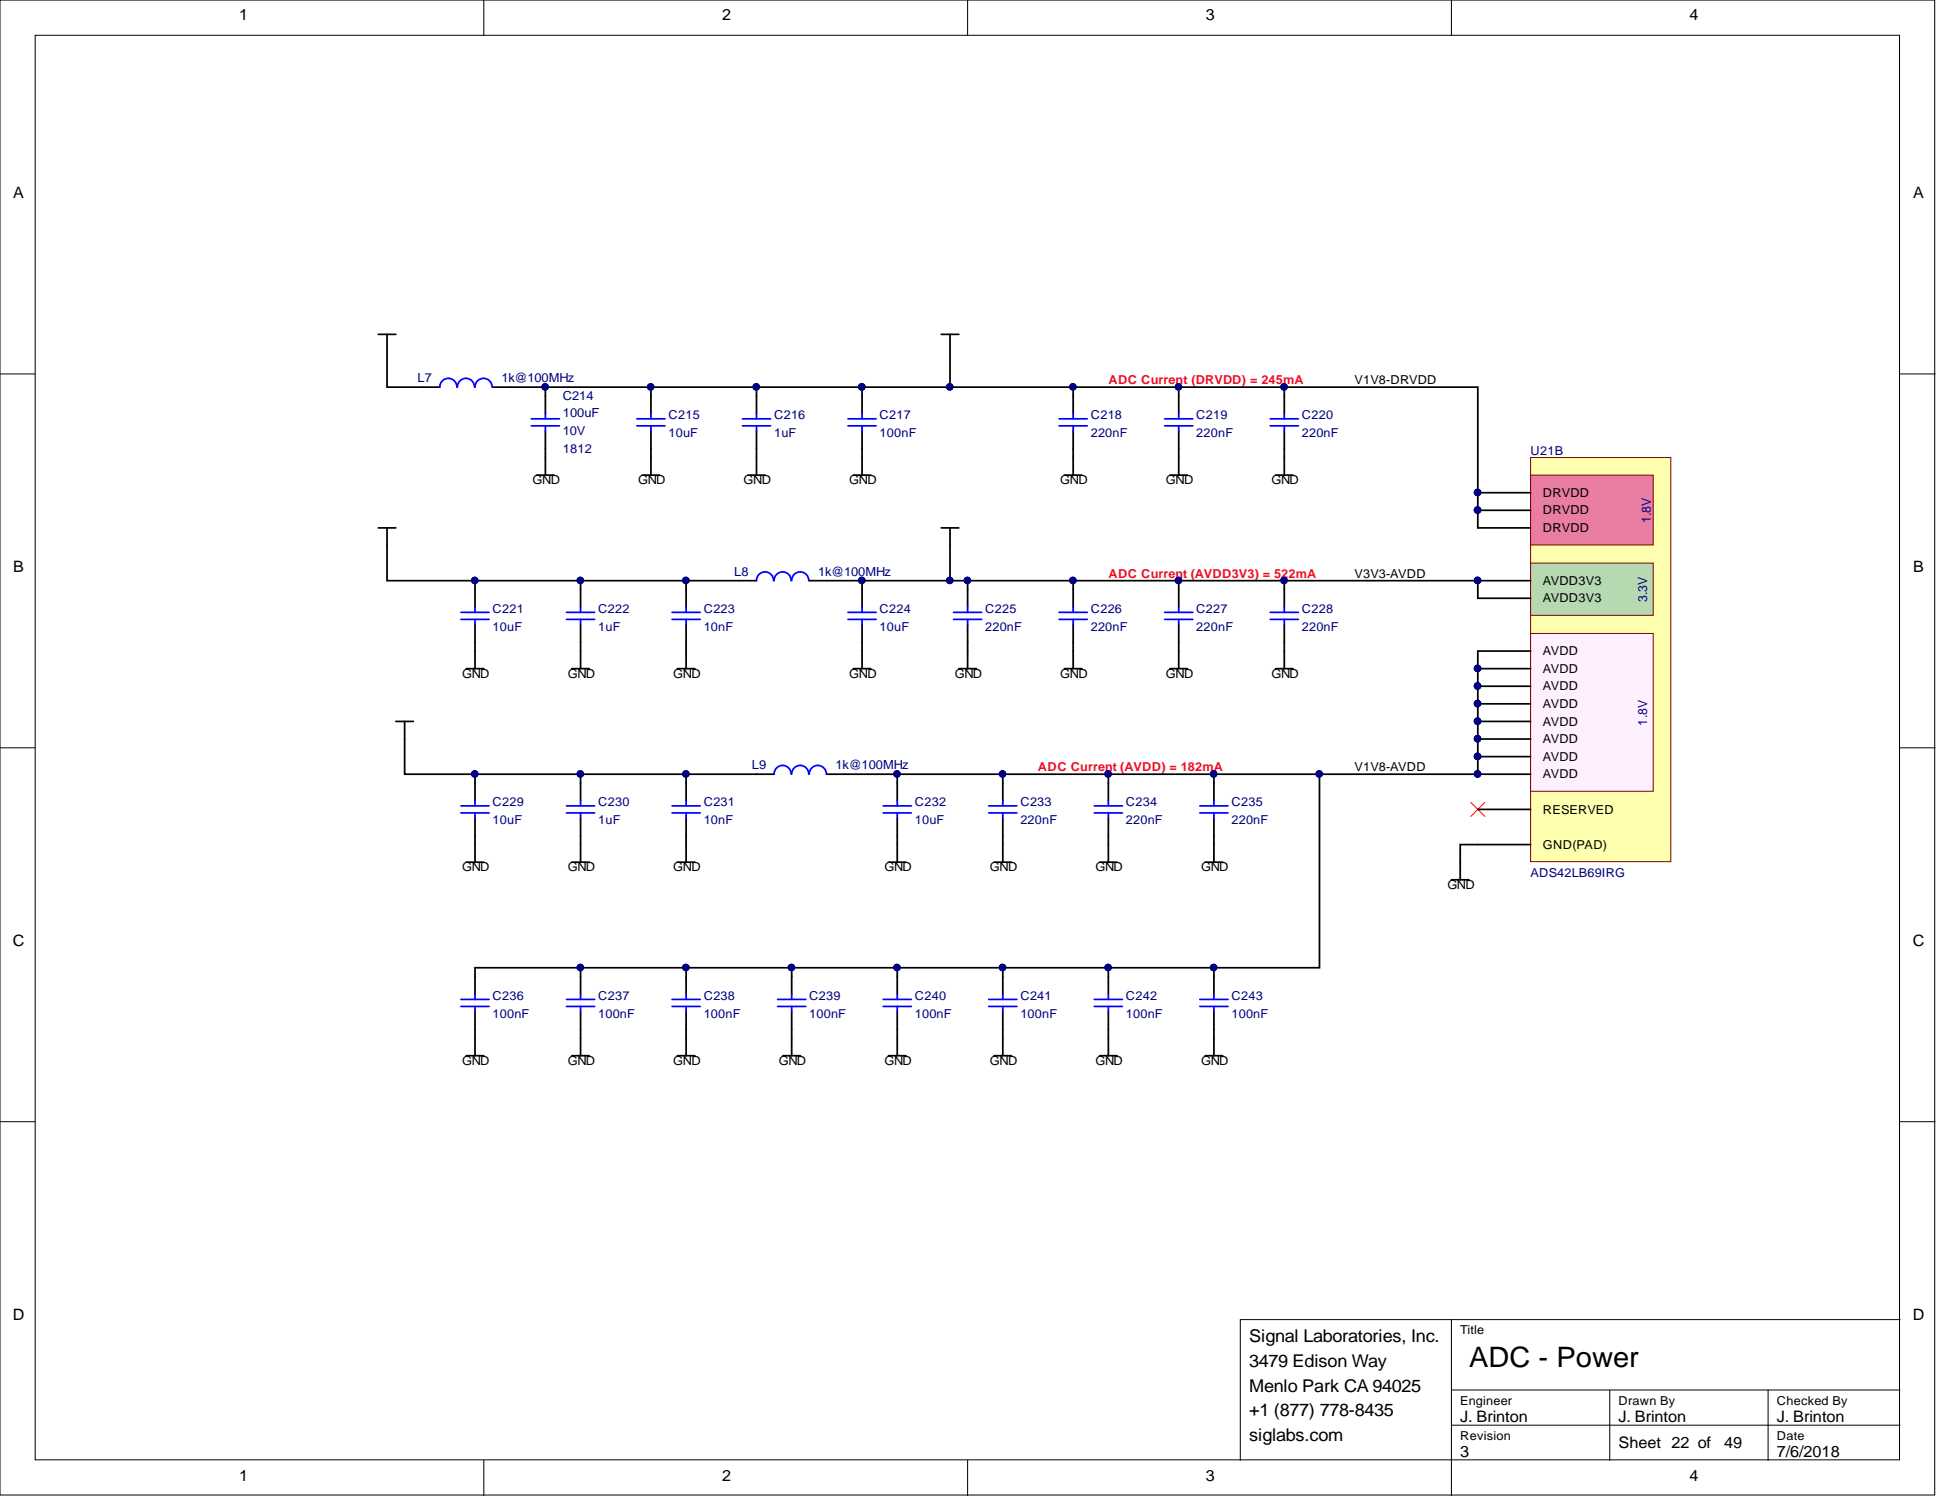
[picture p39: page 22]

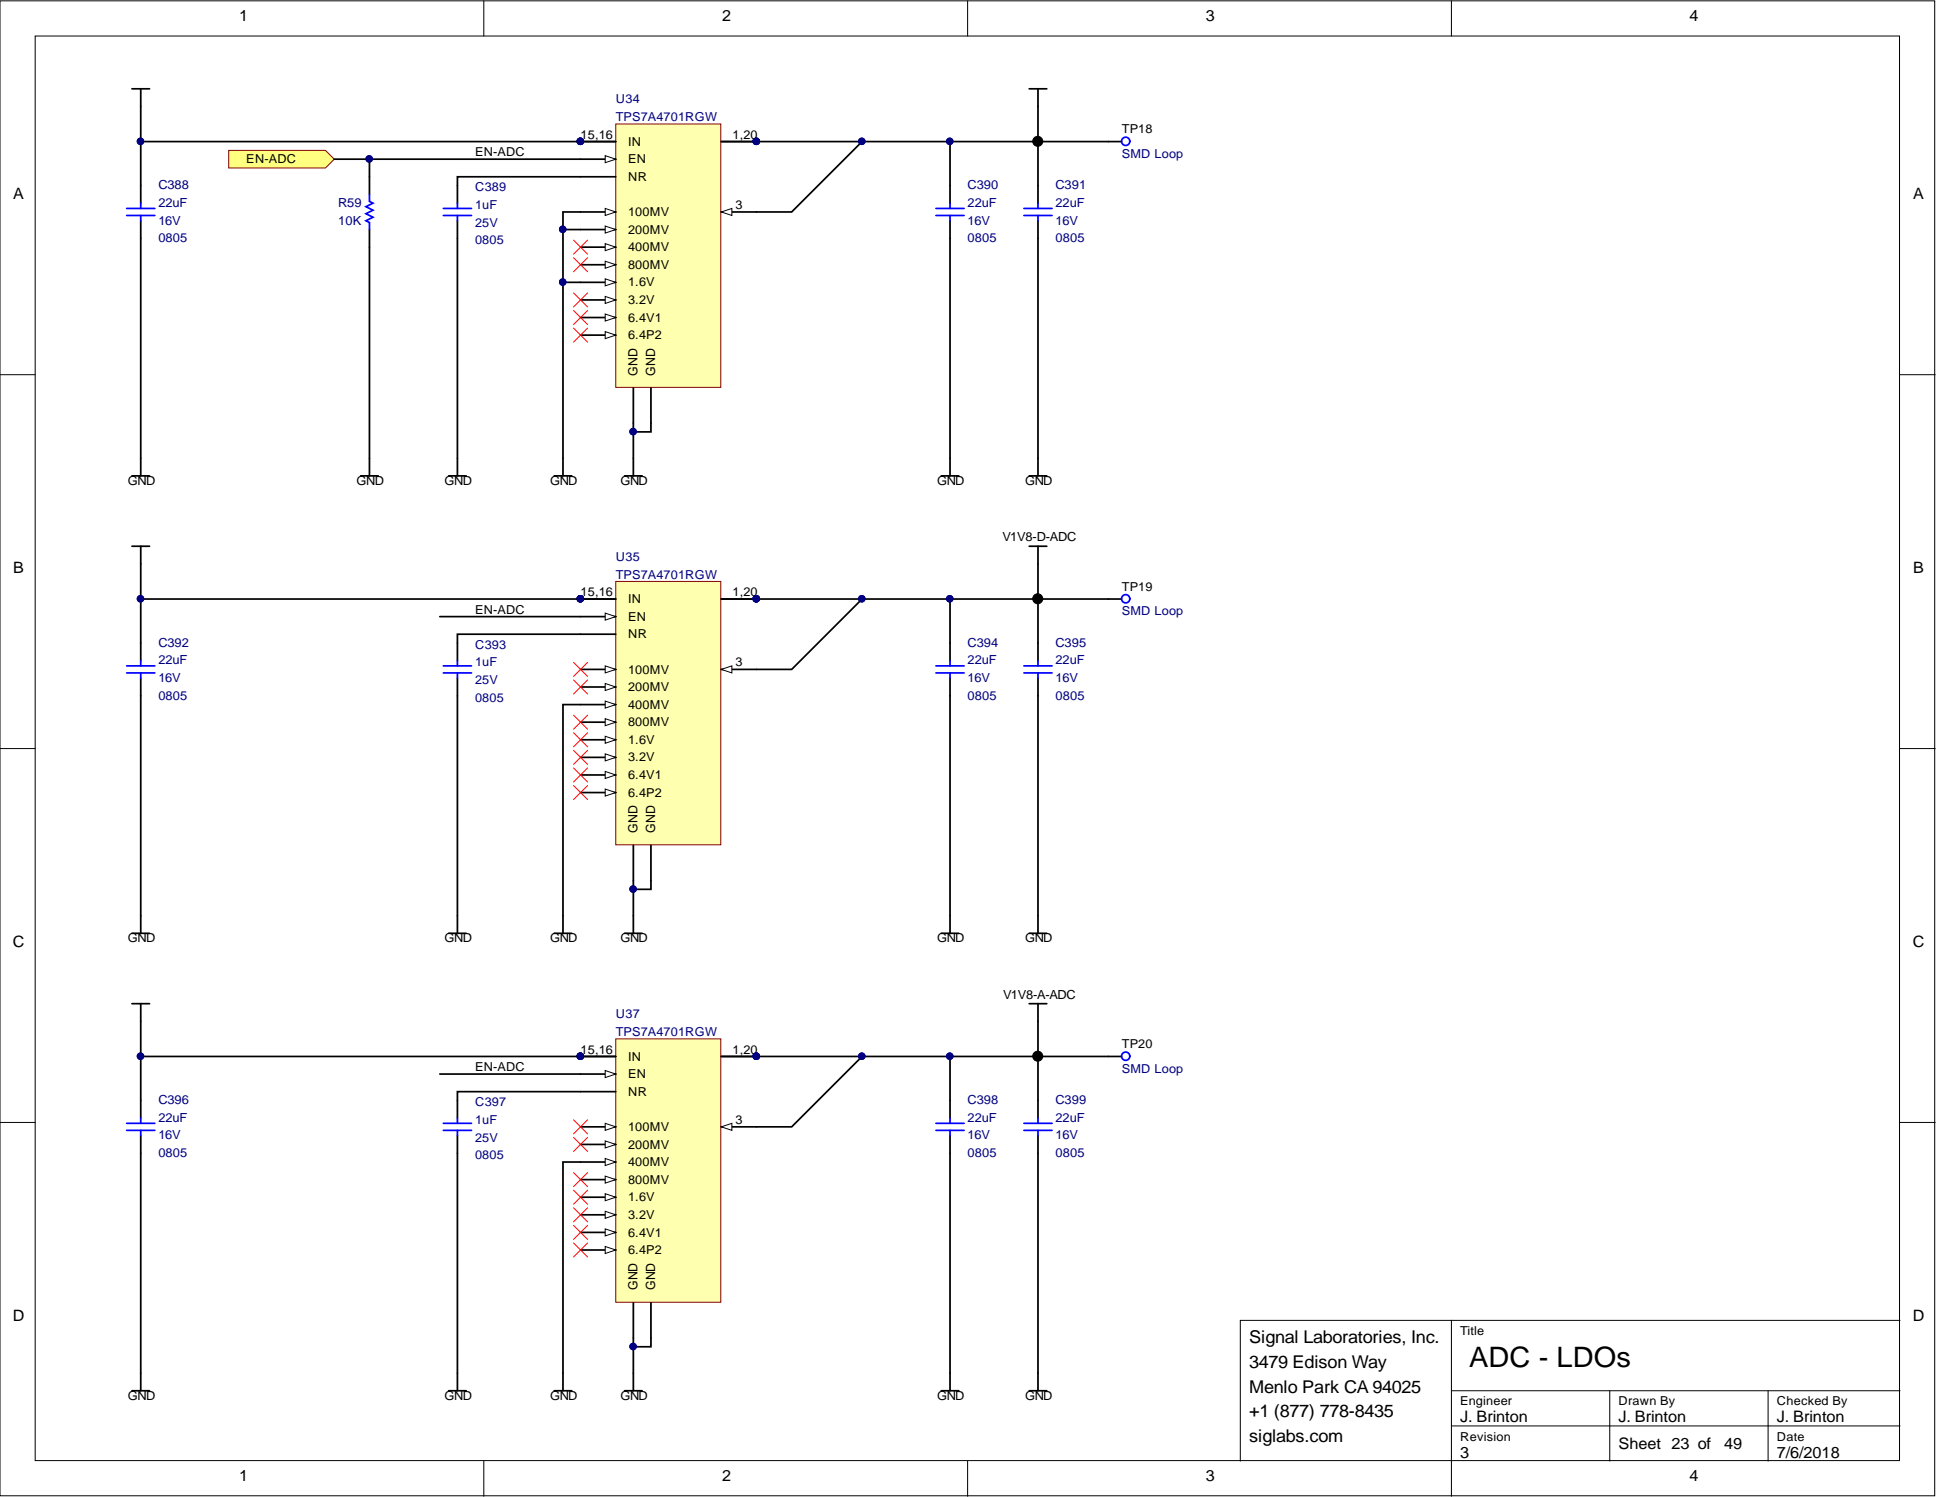
[picture p40: page 23]

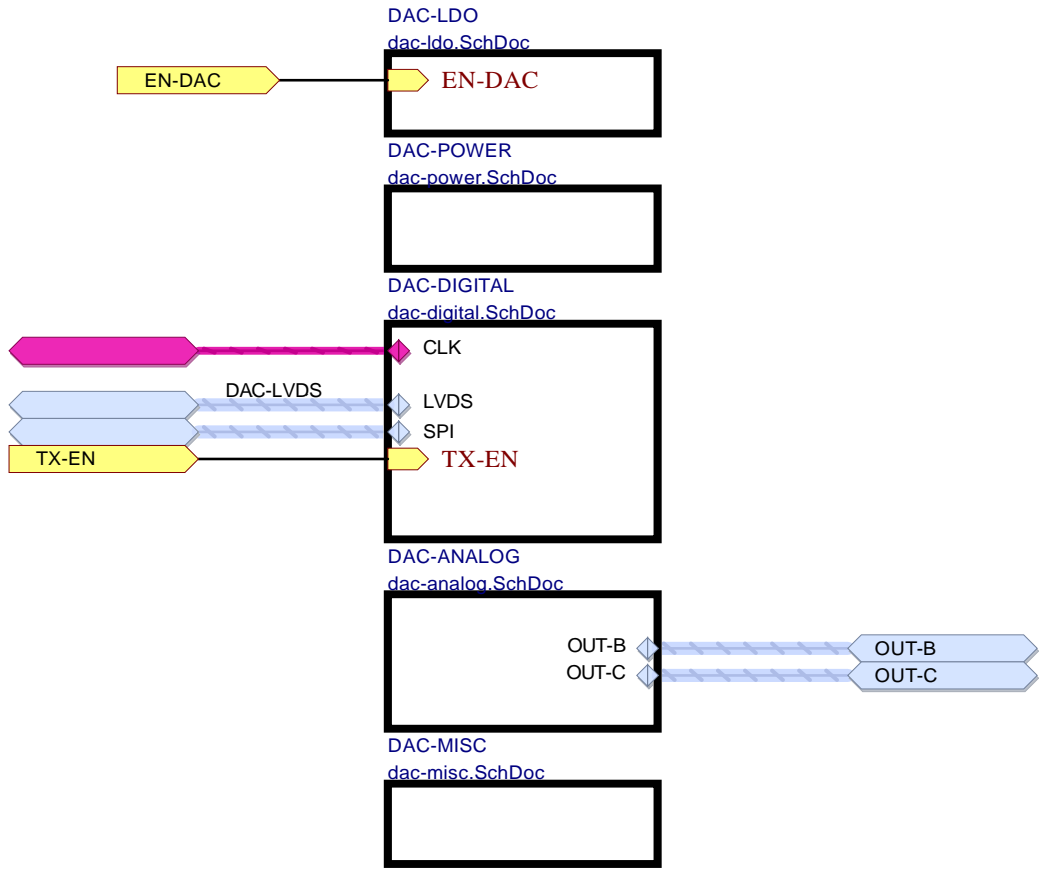
[picture p41: page 24]

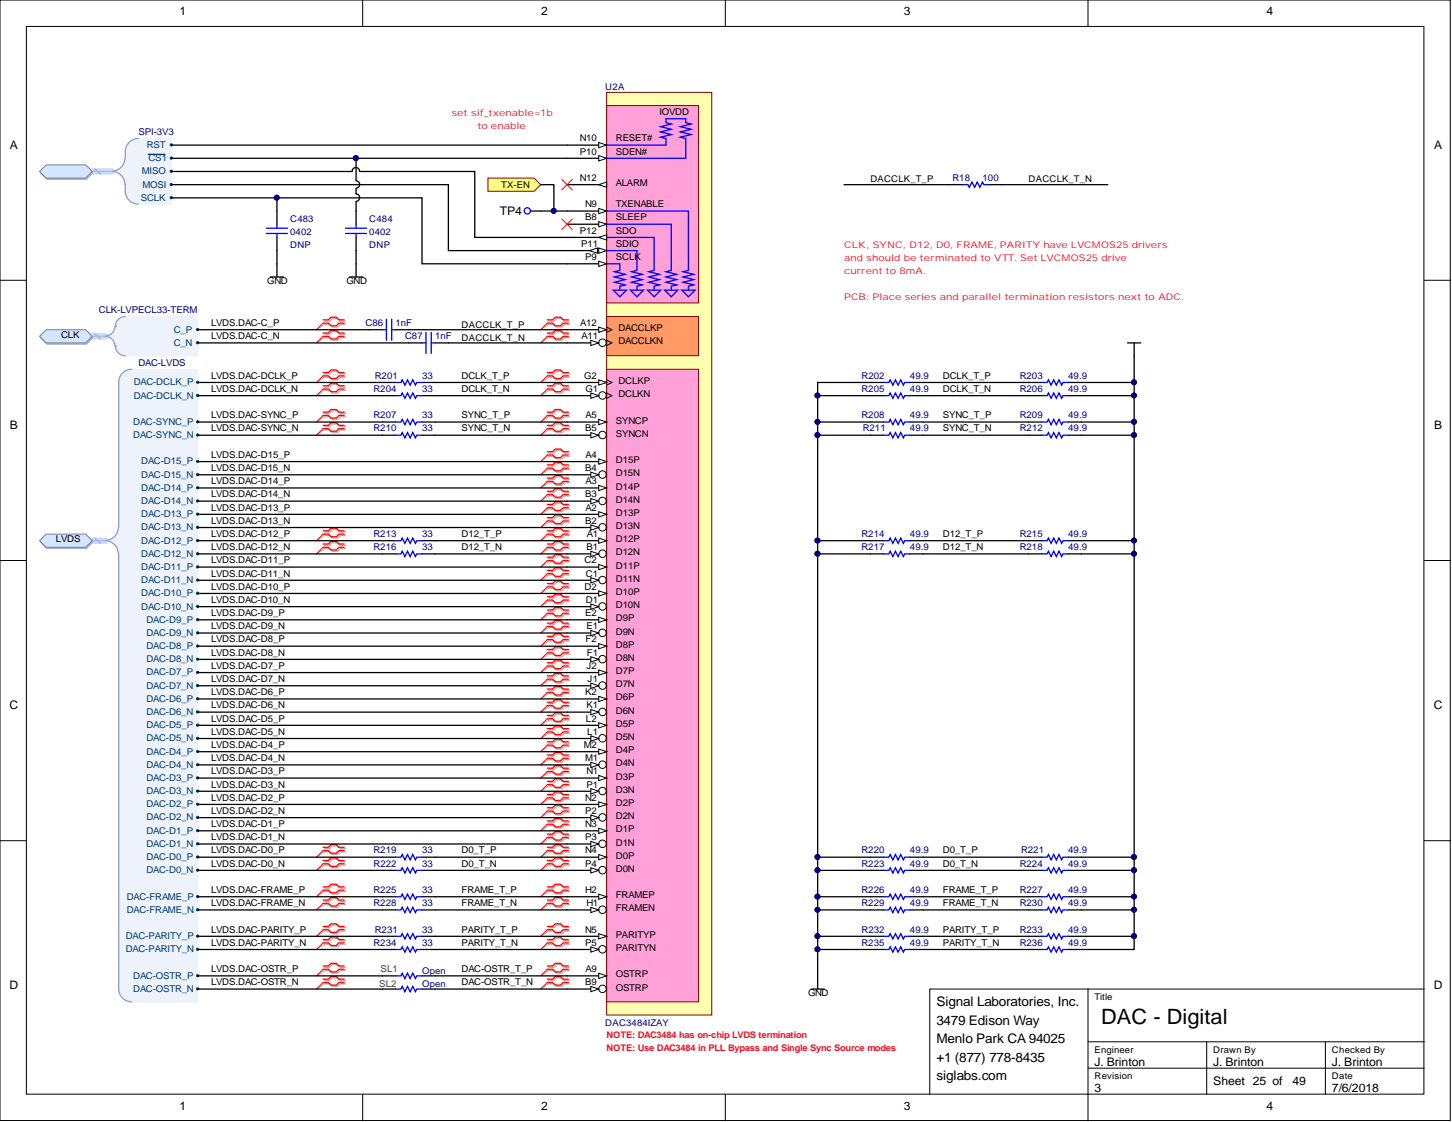
[picture p42: page 25]

CLK, SY
and should be terminated to VTT. Set L
cur

B: Place series and parallel termination resistors next to A

Si g n a l L a b ora t ori es, I nc. 3 4 7 9 Ed iso n W a y Me n l o Park C A + 1 (8 7) 8-8 si g l a bs.co m | T itl e DAC - Digital

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

R e v i s i o n | | D ate 7/6/2018 Sheet 25 of 49

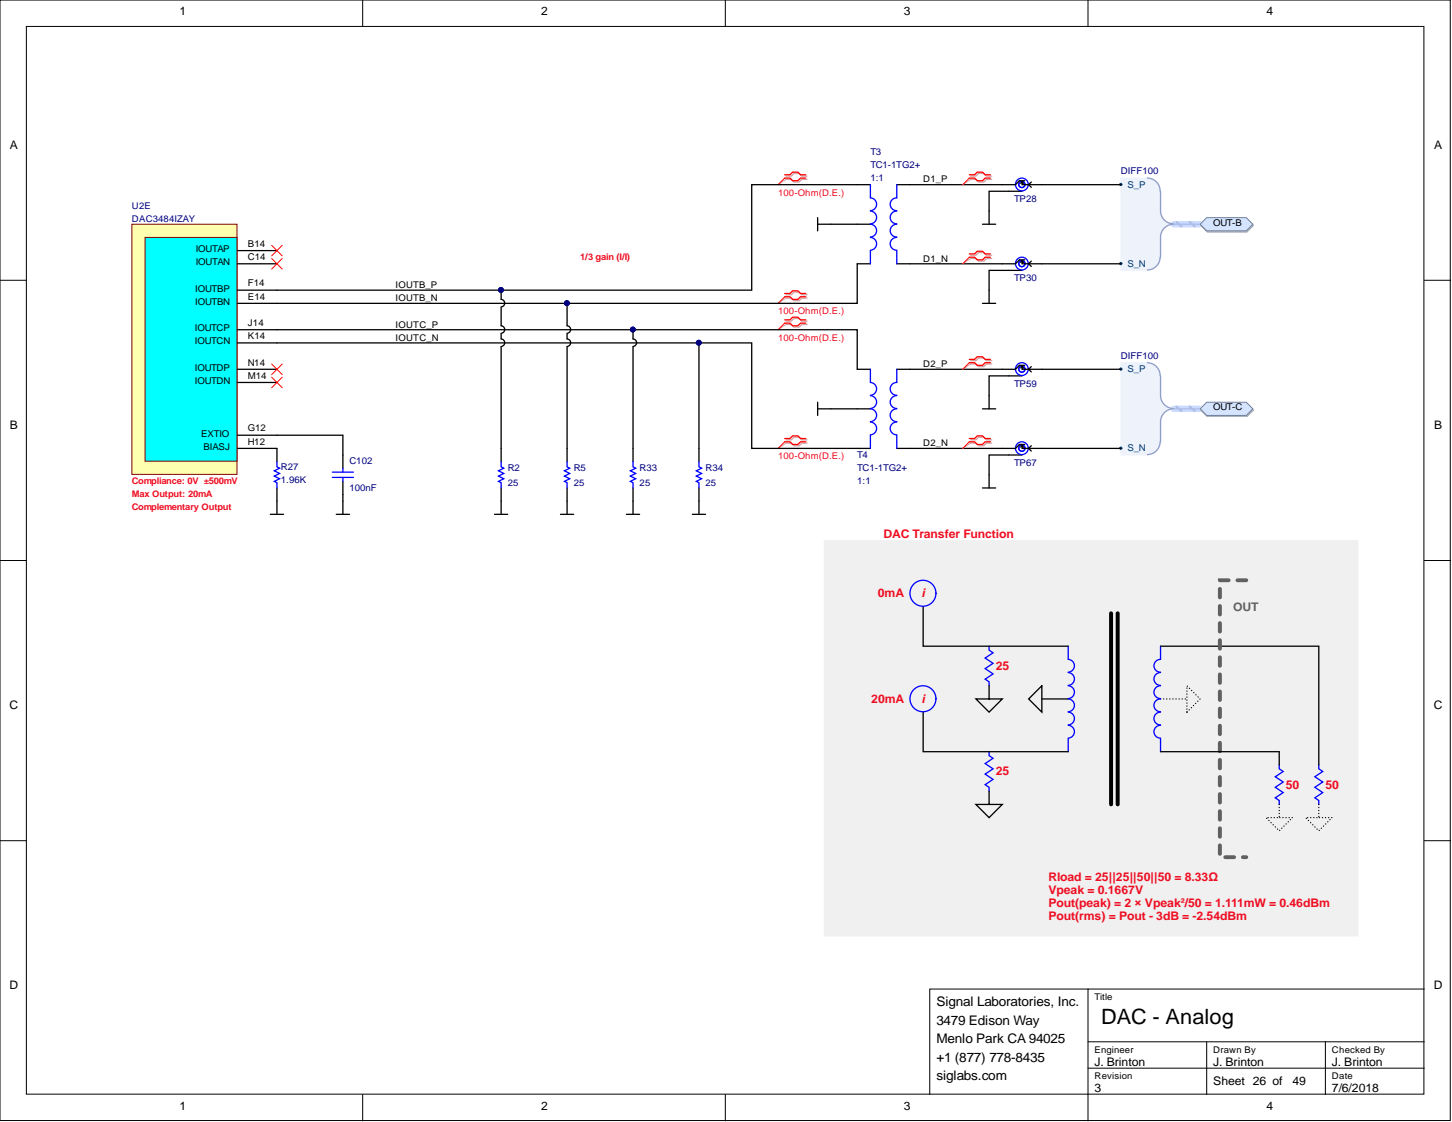
[picture p43: page 26]

N14
M14

Si g n a l L a b ora t ori es, I nc. 3 4 7 9 Ed iso n W a y Me n l o Park C A + 1 (8 7) 8-8 si g l a bs.co m | T itl e DAC - Analog

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

R e v i s i o n | | D ate 7/6/2018 Sheet 26 of 49

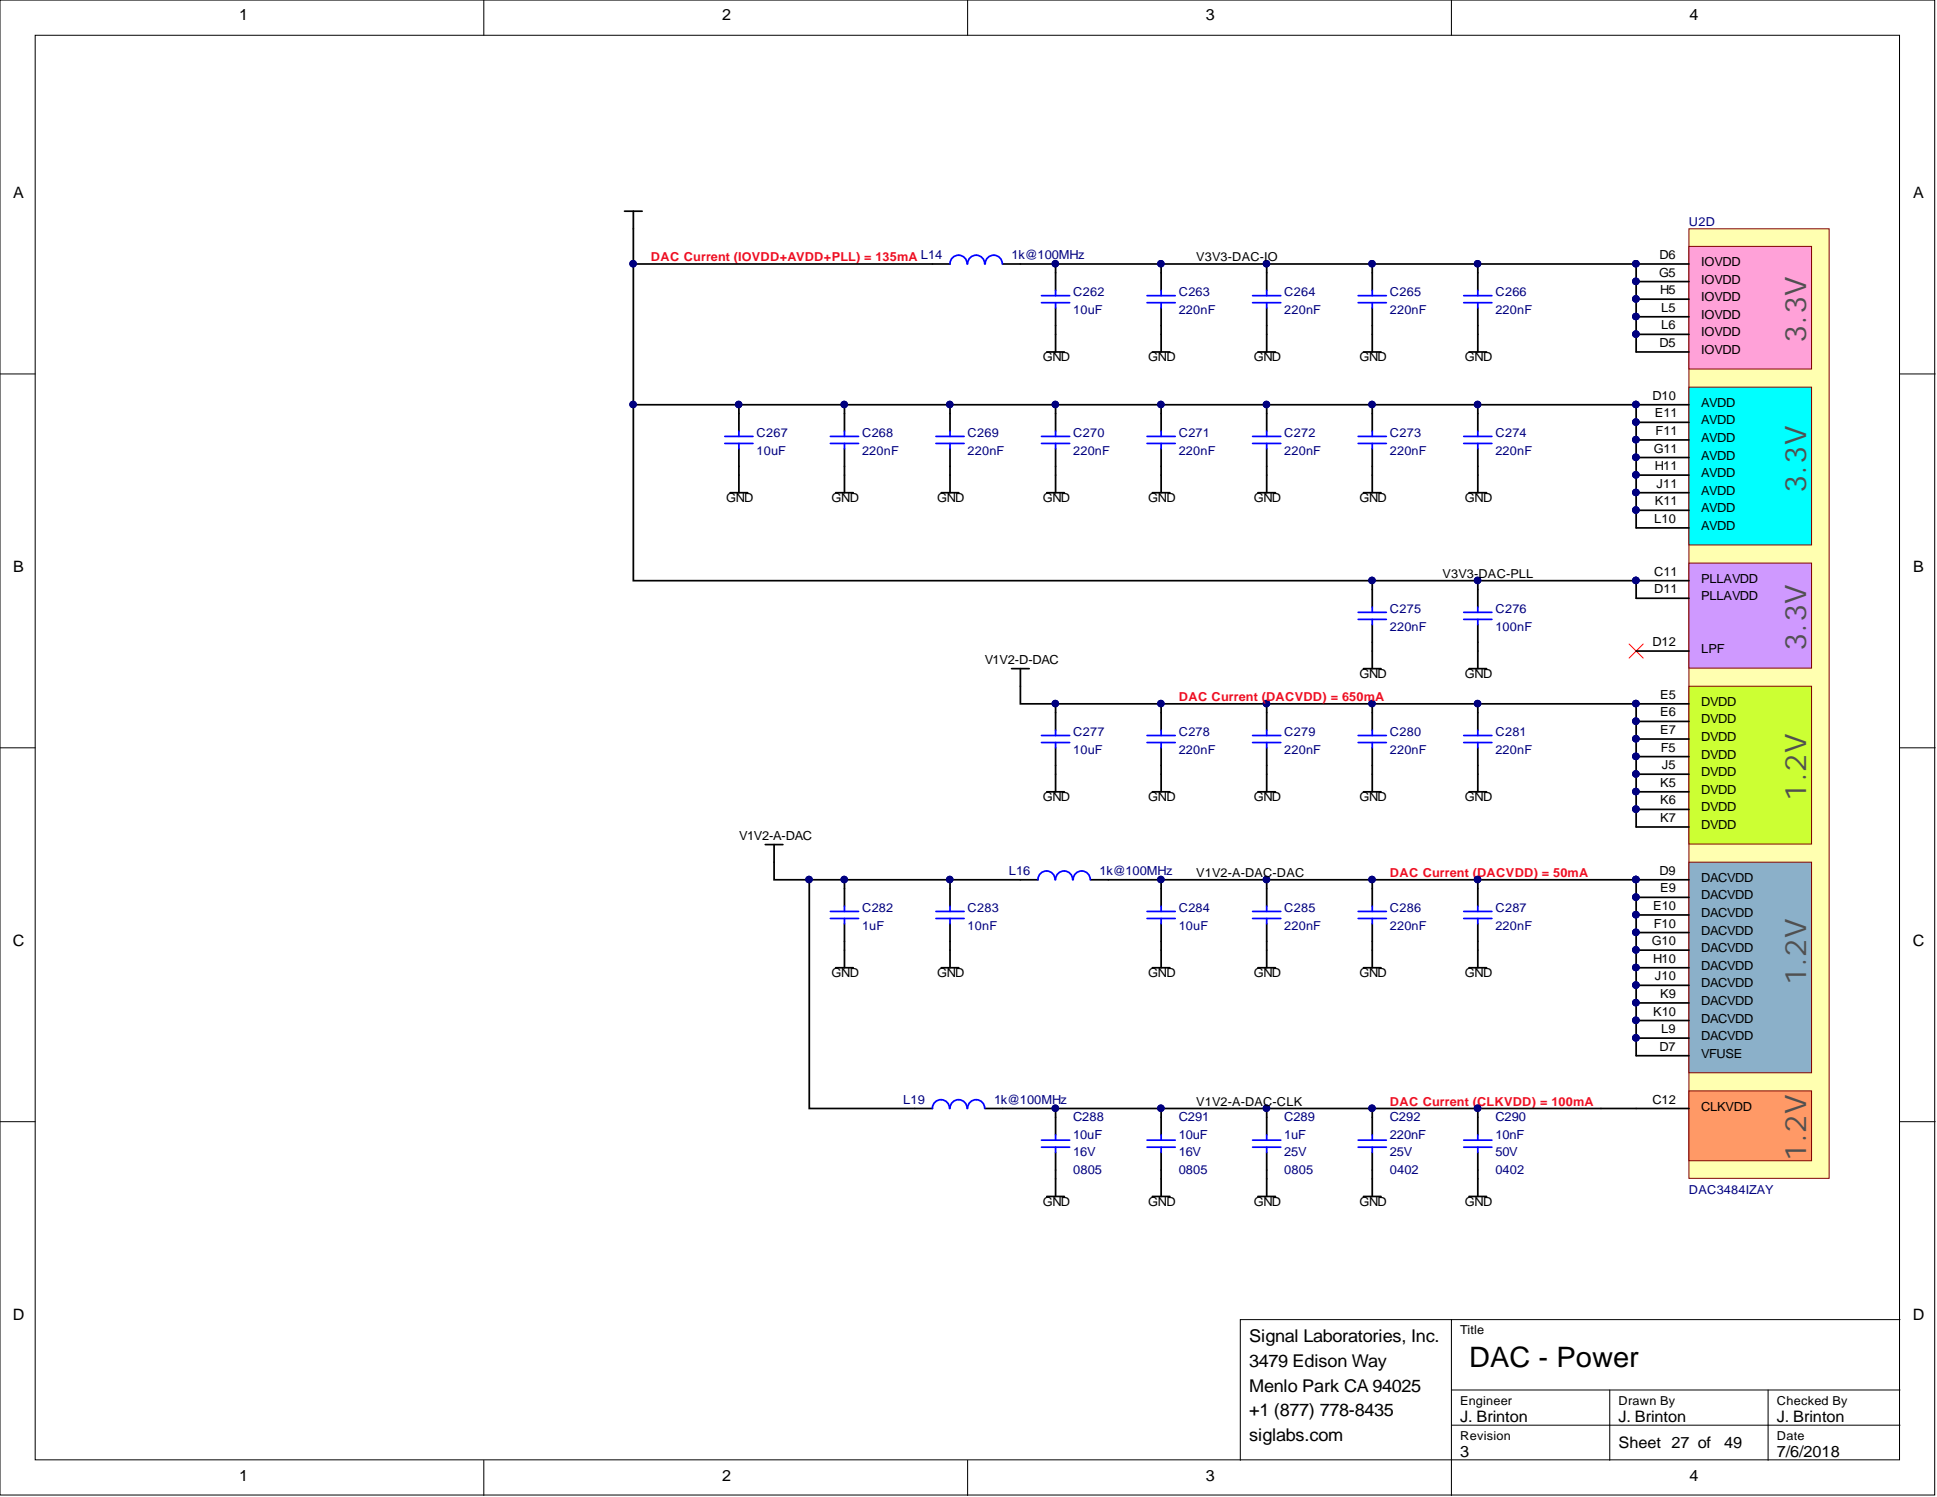
[picture p44: page 27]

DAC Current (IOVDD+AVDD+PLL) = 135mA

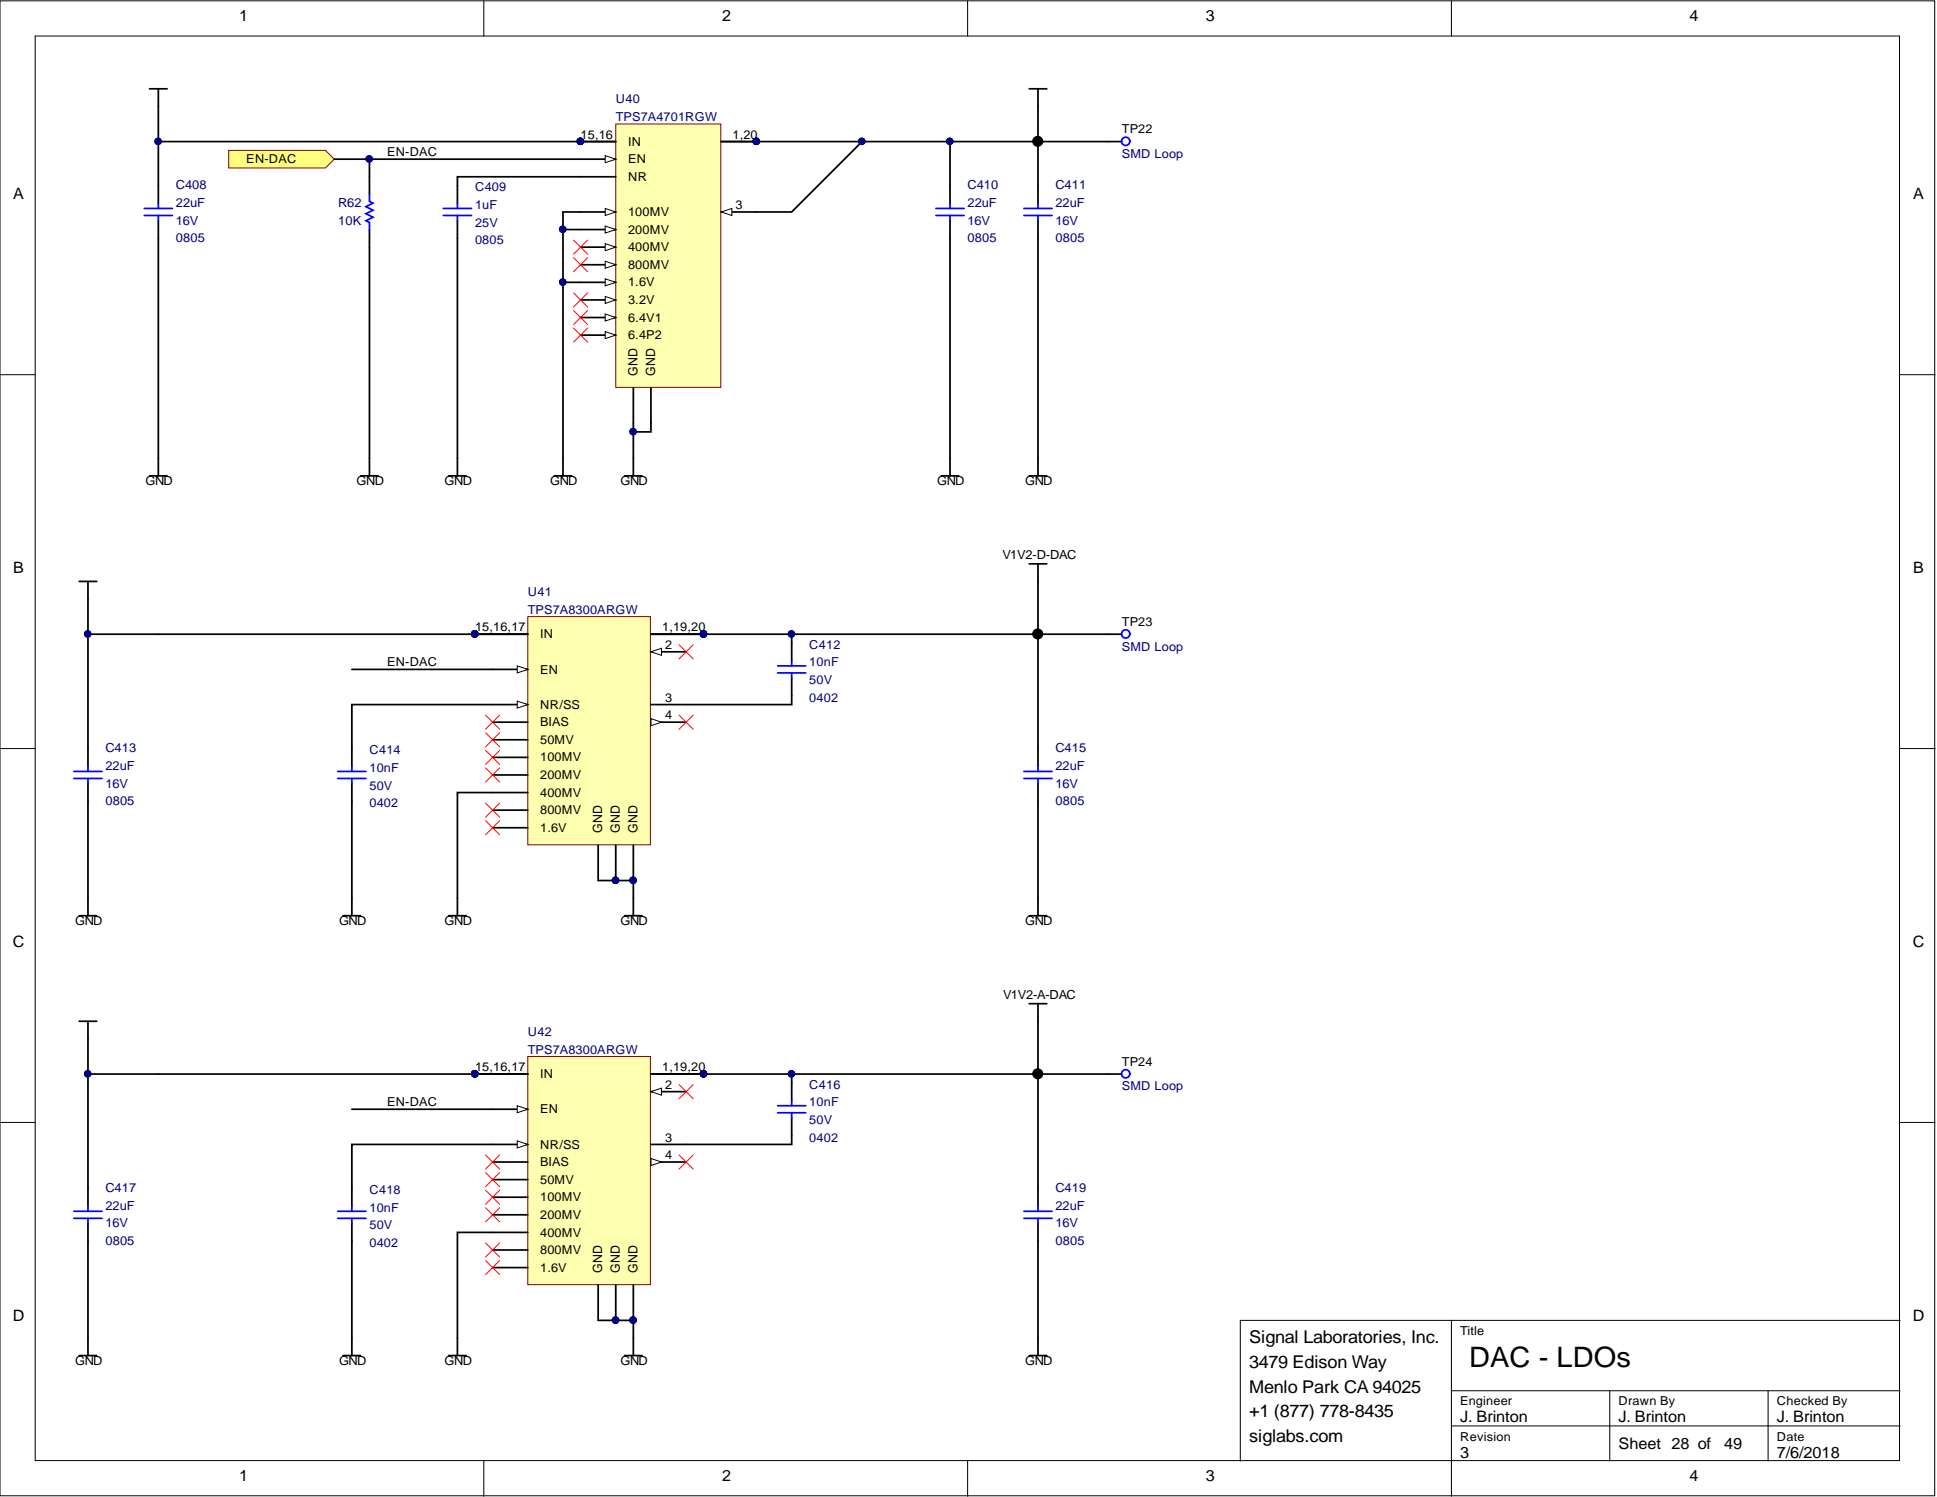
[picture p45: page 28]

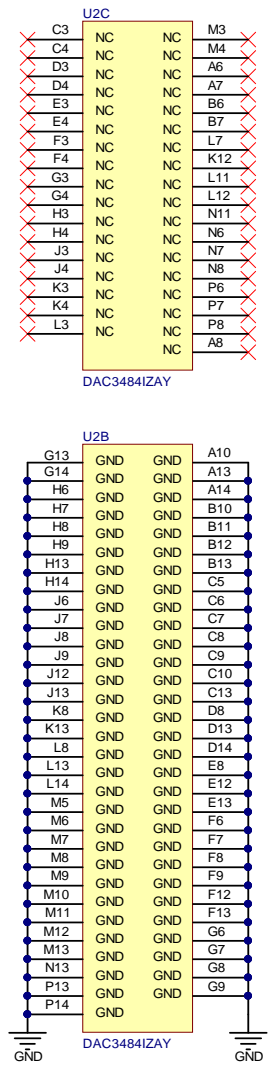
[picture p46: page 29]

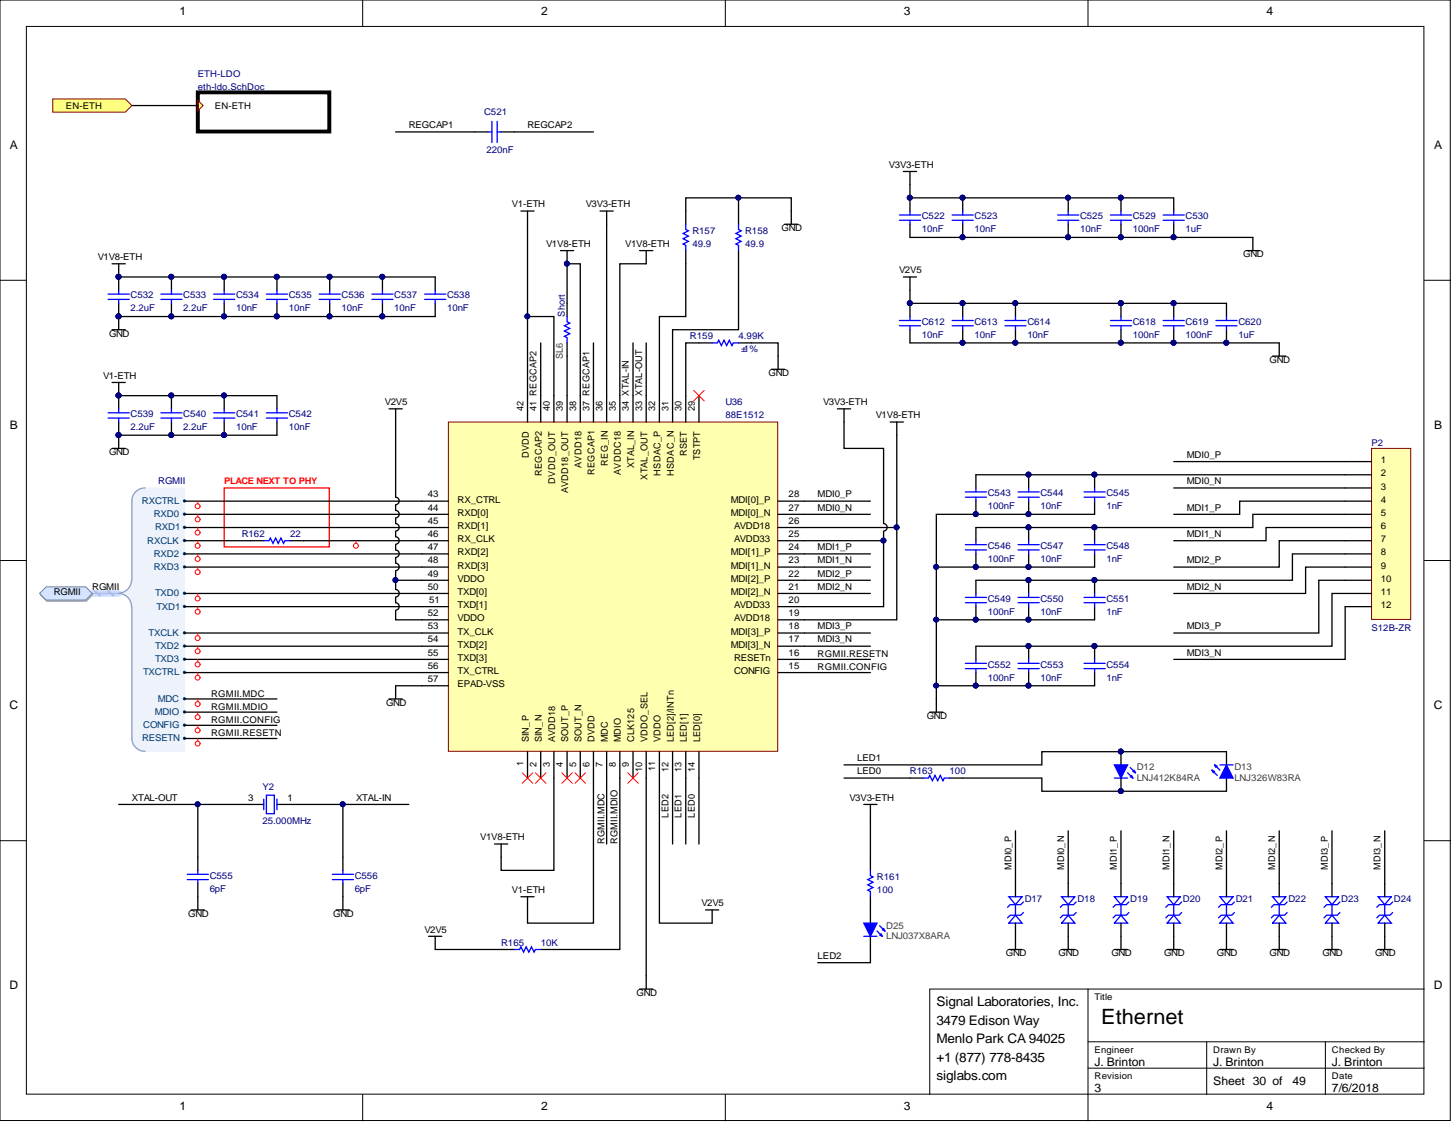
[picture p47: page 30]

PLACE NEXT TO PHY

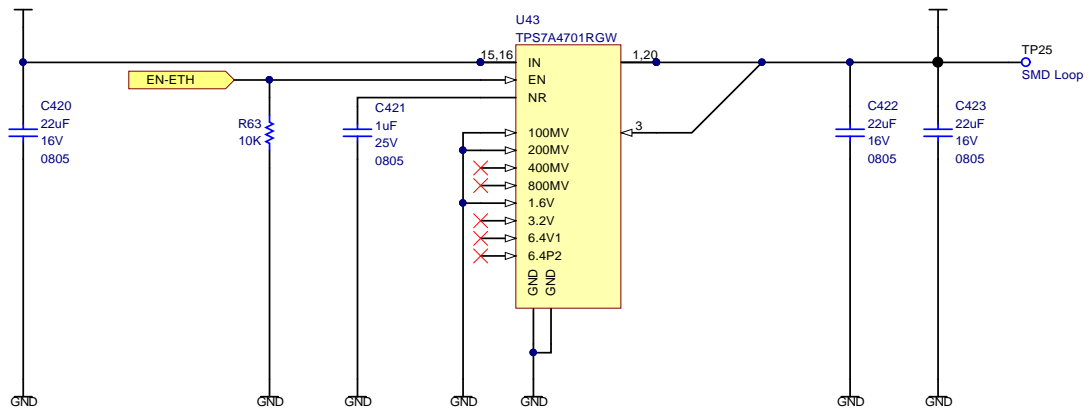
[picture p48: page 31]

Si g n a l L a b ora t ori es, I nc. 3 4 7 9 Ed iso n W a y Me n l o Park C A + 1 (8 7) 8-8 si g l a bs.co m | T itl e Ethernet - LDO s

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

R e v i s i o n | | D ate 7/6/2018 Sheet 31 of 49

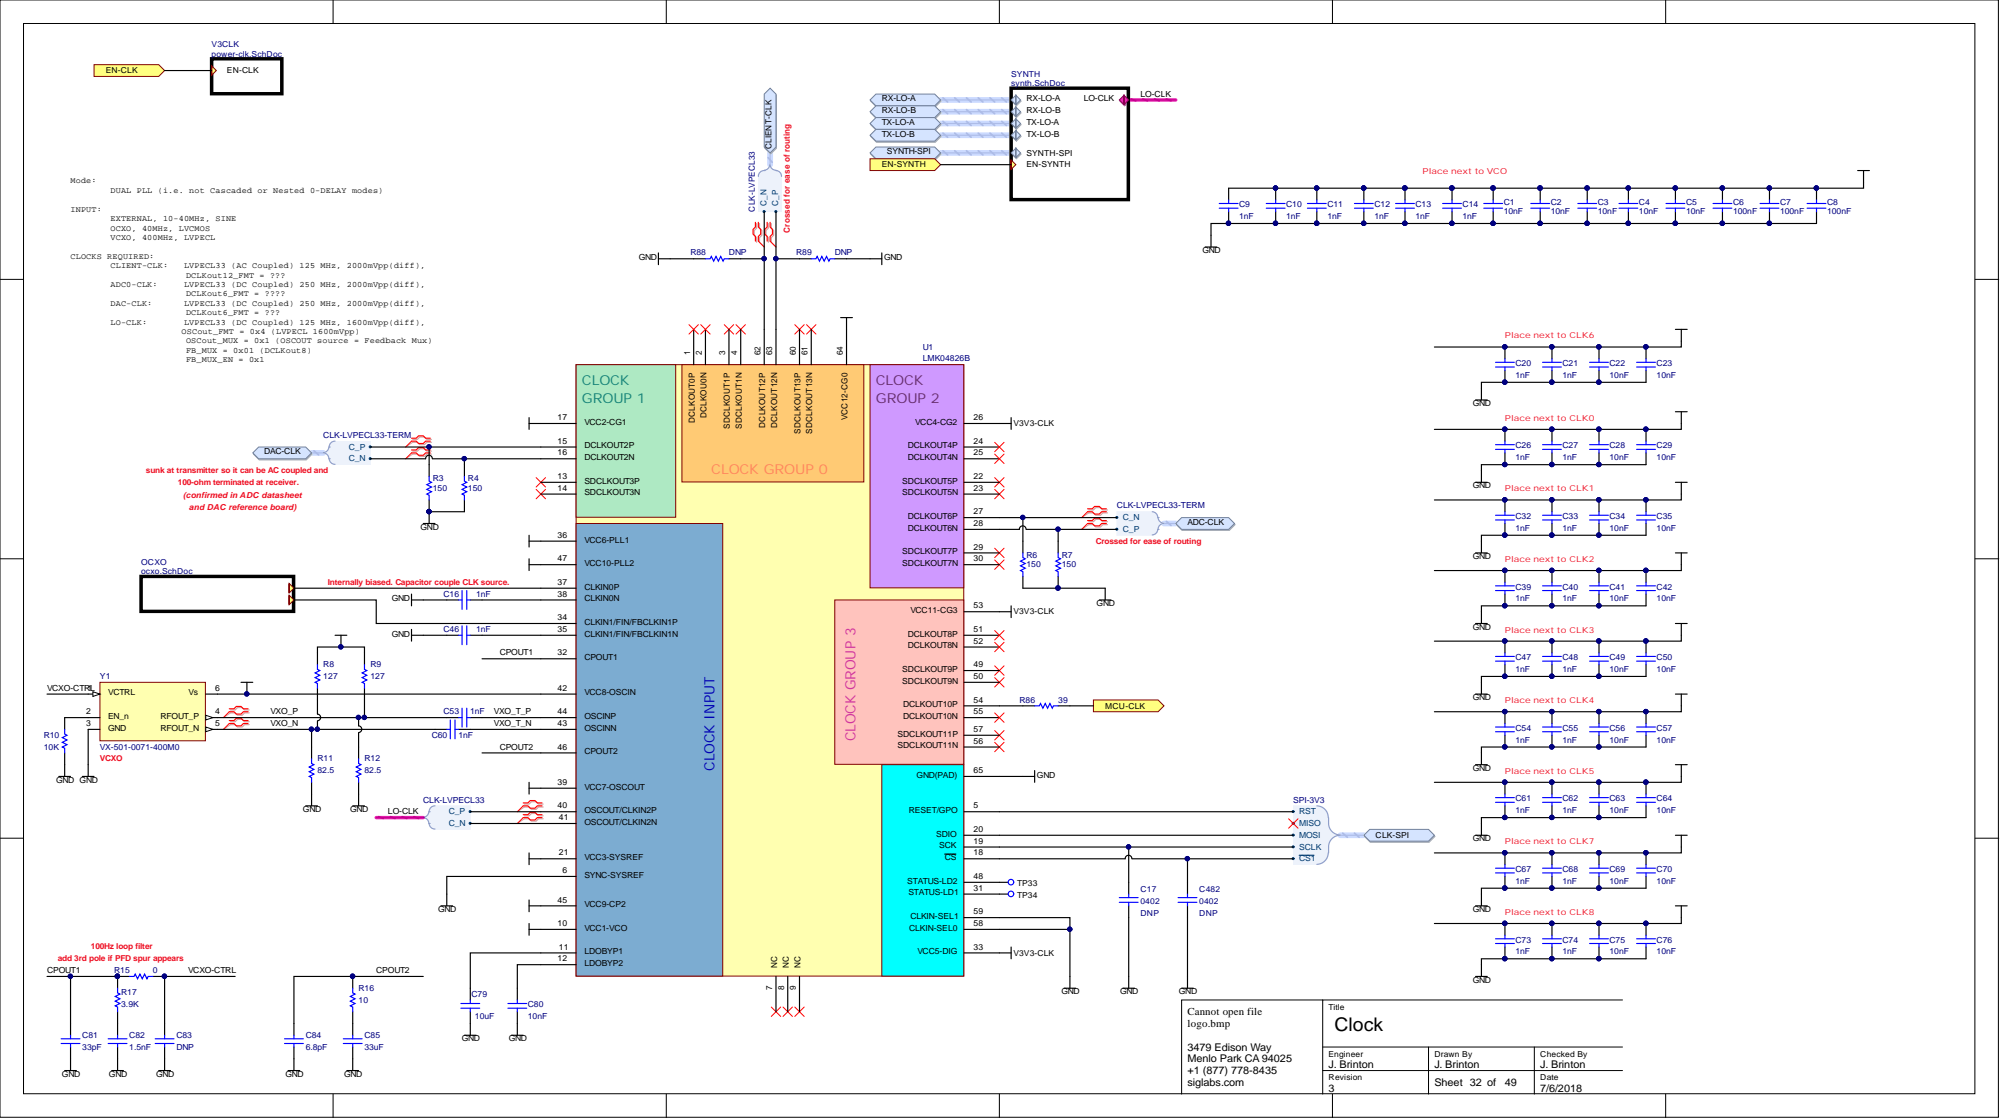
[picture p49: page 32]

Crossed for ease of routing

SYNTH-SPI TX-LO-A TX-LO-B

Place next to CLK

Can n o t o pen fi le l o g o.bmp 3479 Edison Way Menlo Park C A 94025 +1 (877) 778-8435 siglabs.com | T itl e Clock

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

R e v i s i o n | | D ate 7/6/2018 Sheet 32 of 49

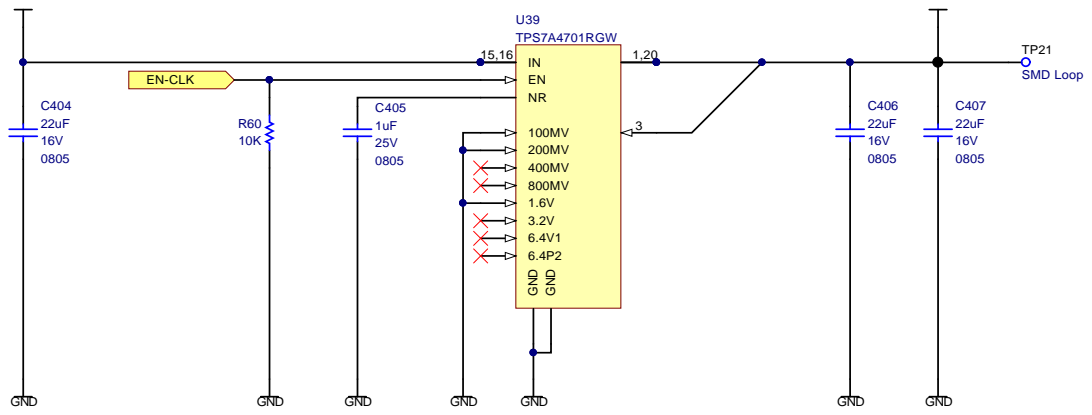
[picture p50: page 33]

Si g n a l L a b ora t ori es, I nc. 3 4 7 9 Ed iso n W a y Me n l o Park C A + 1 (8 7) 8-8 si g l a bs.co m | T itl e Clock - LDO

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

R e v i s i o n | | D ate 7/6/2018 Sheet 33 of 49

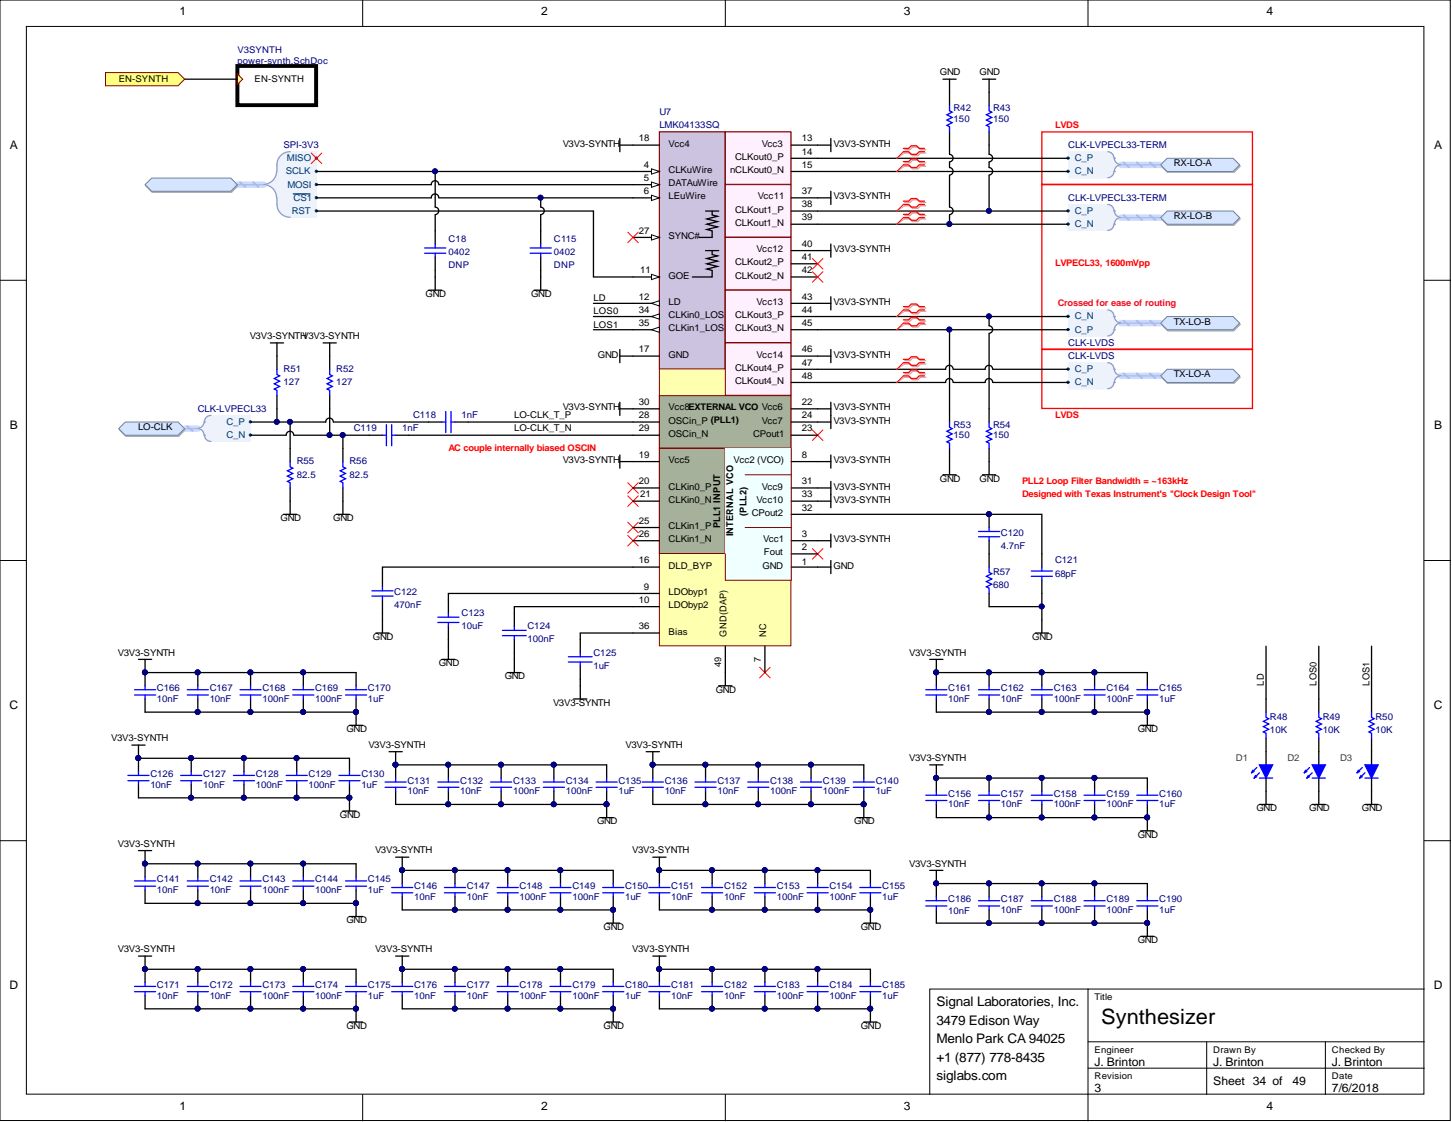
[picture p51: page 34]

AC couple internally biased OSCIN

PLL2 Loop Filter Bandwidth = ~163kHz
Designed with Texas Instrument's "Clock Design Tool"

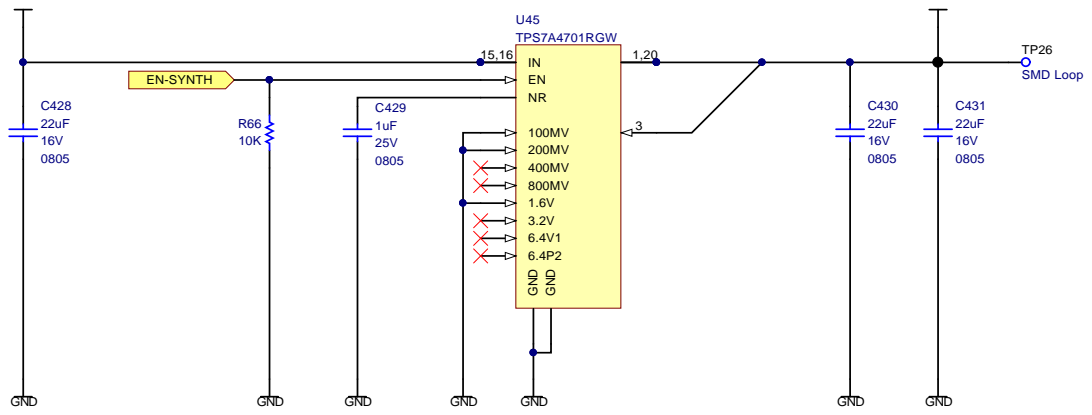
[picture p52: page 35]

Si g n a l L a b ora t ori es, I nc. 3 4 7 9 Ed iso n W a y Me n l o Park C A + 1 (8 7) 8-8 si g l a bs.co m | T itl e Synthesizer - LDO

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

R e v i s i o n | | D ate 7/6/2018 Sheet 35 of 49

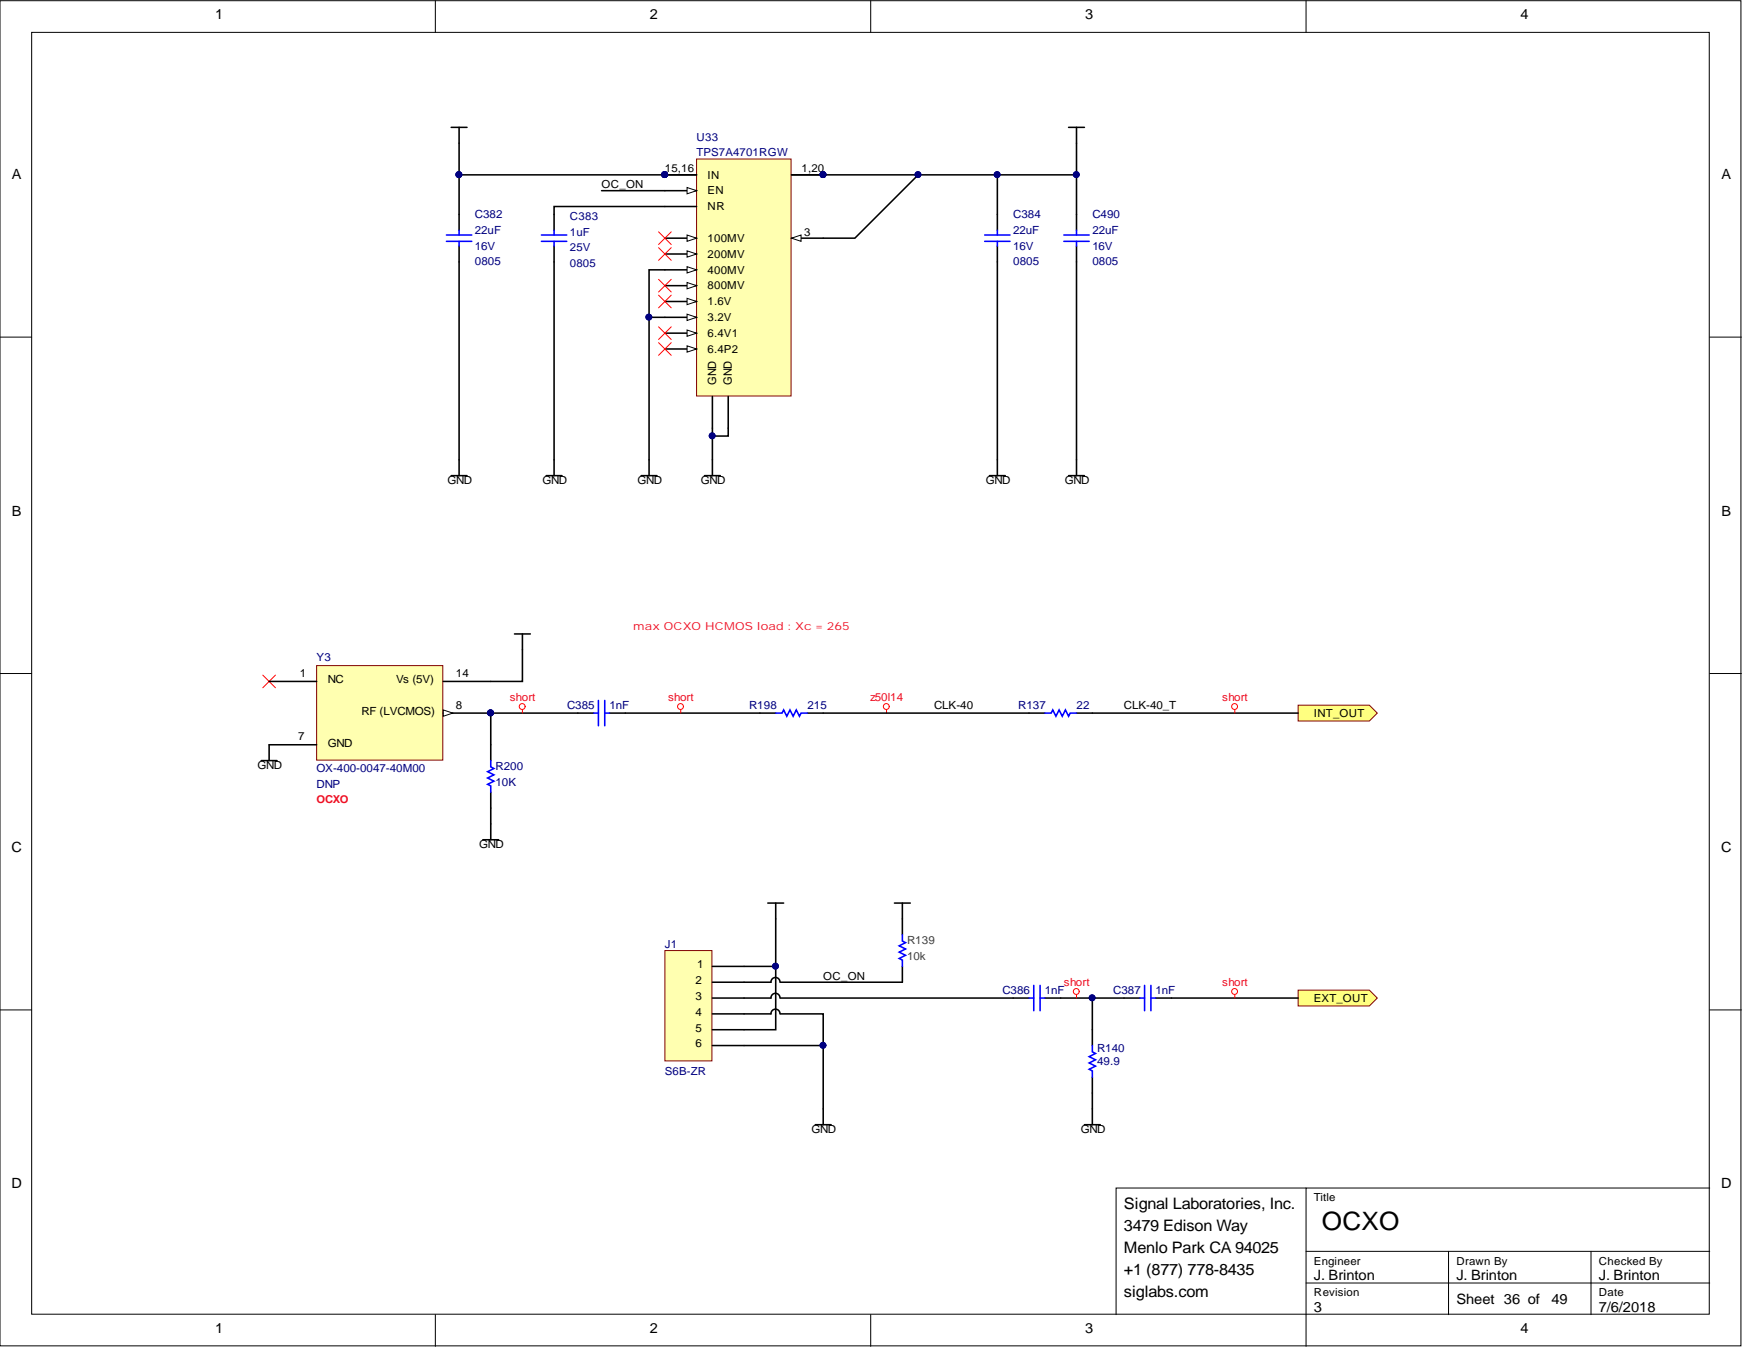
[picture p53: page 36]

max OCXO HCMOS load : Xc = 265

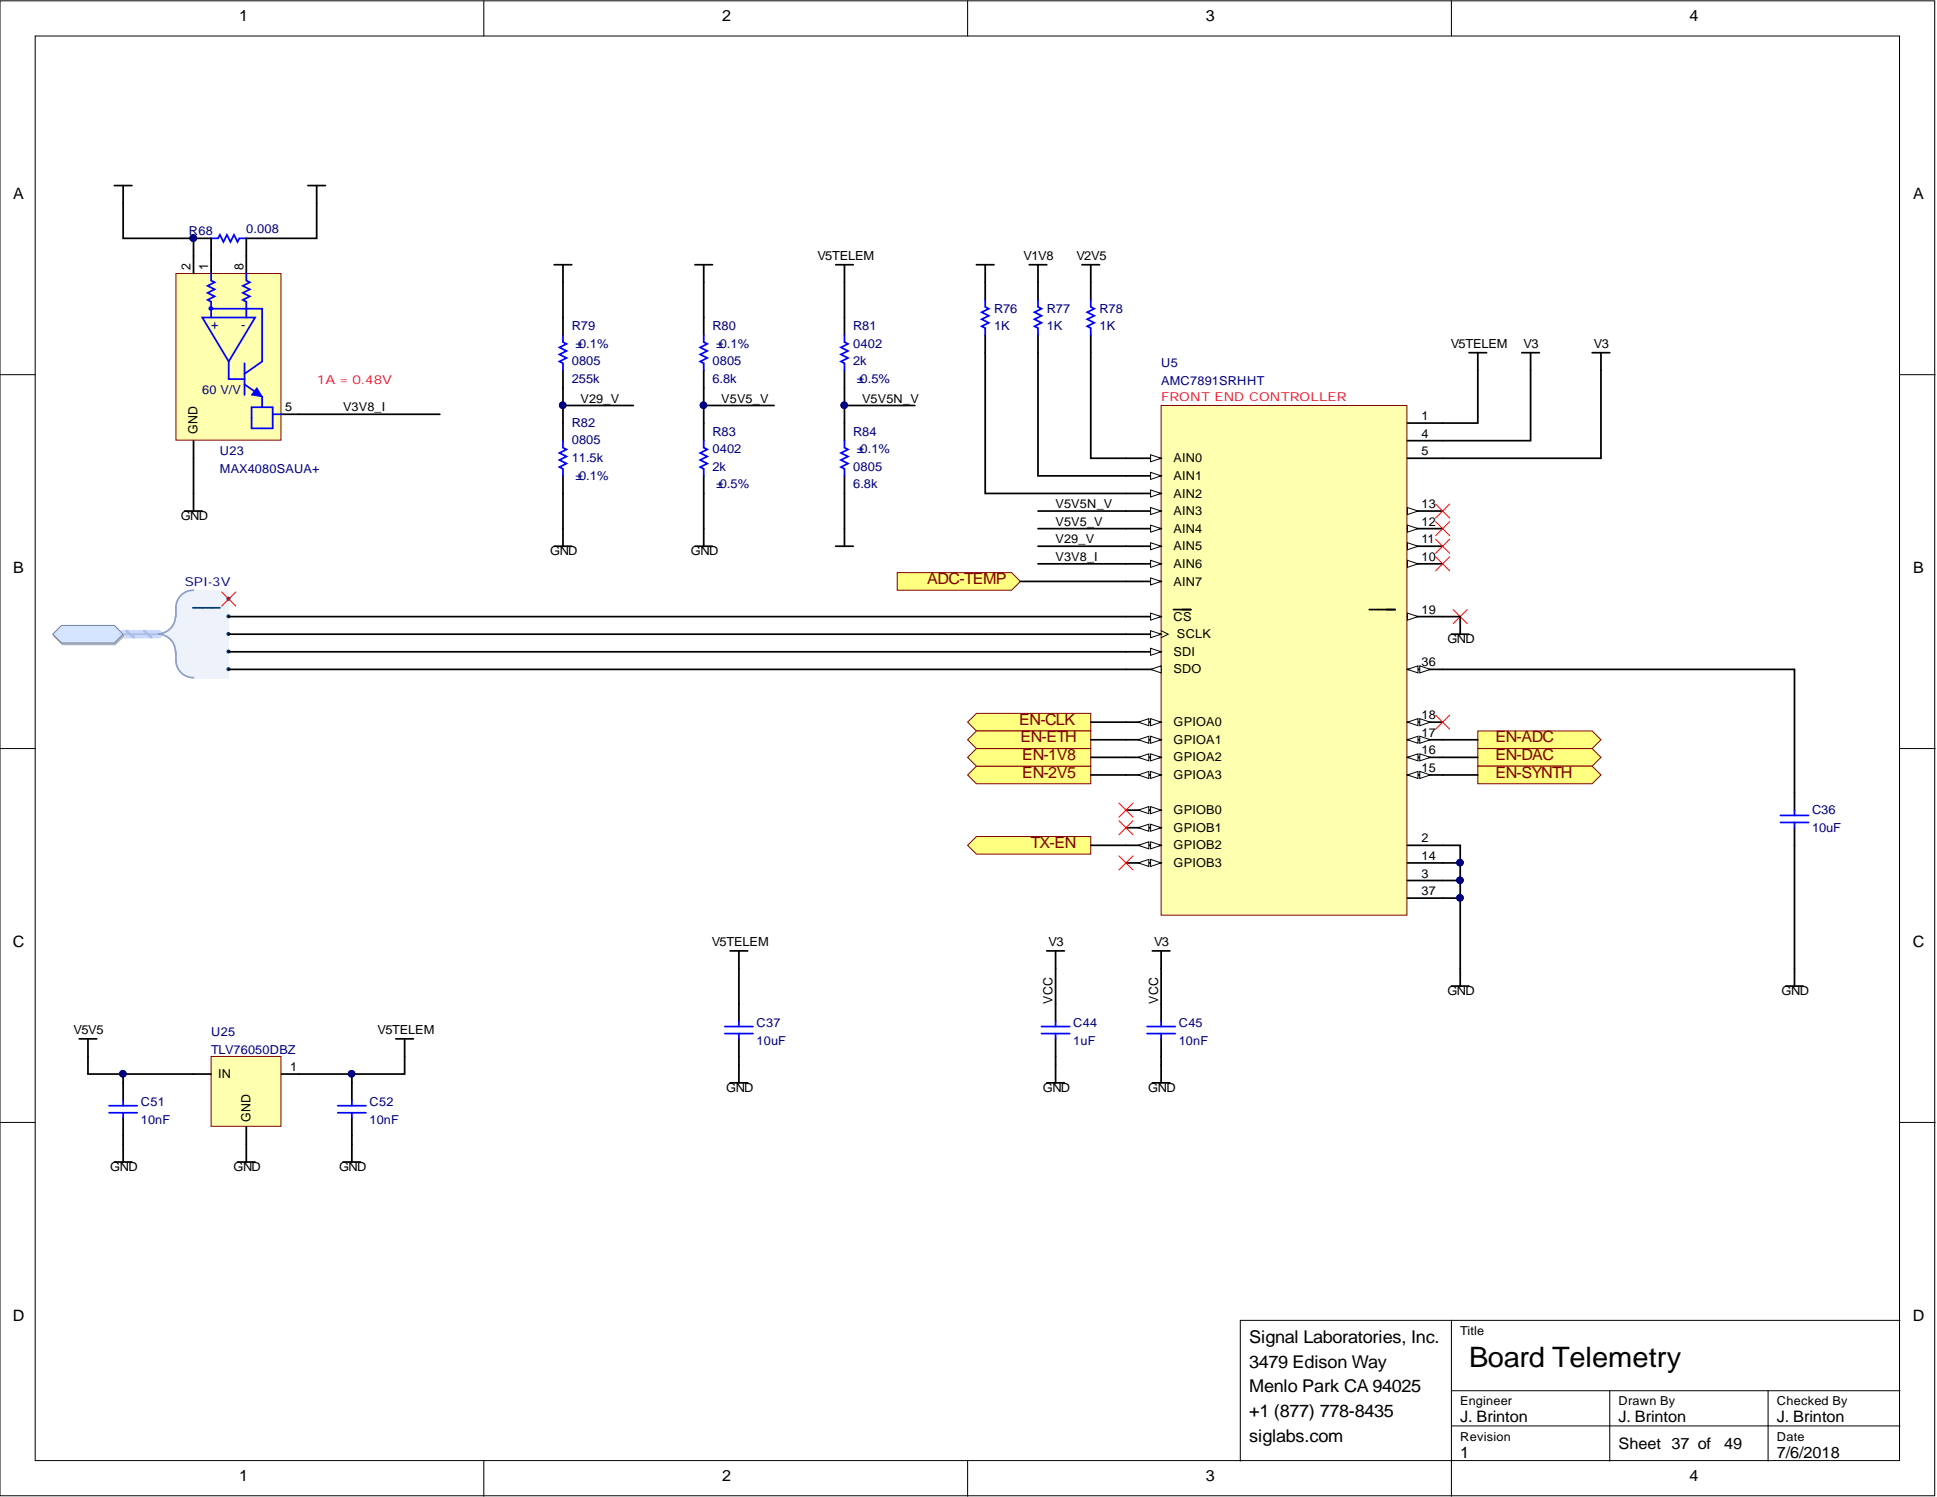
[picture p54: page 37]

Si g n a l L a b ora t ori es, I nc. 3 4 7 9 Ed iso n W a y Me n l o Park C A + 1 (8 7) 8-8 si g l a bs.co m | T itl e Board Telemetry

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

R e v i s i o n | | D ate 7/6/2018 Sheet 37 of 49

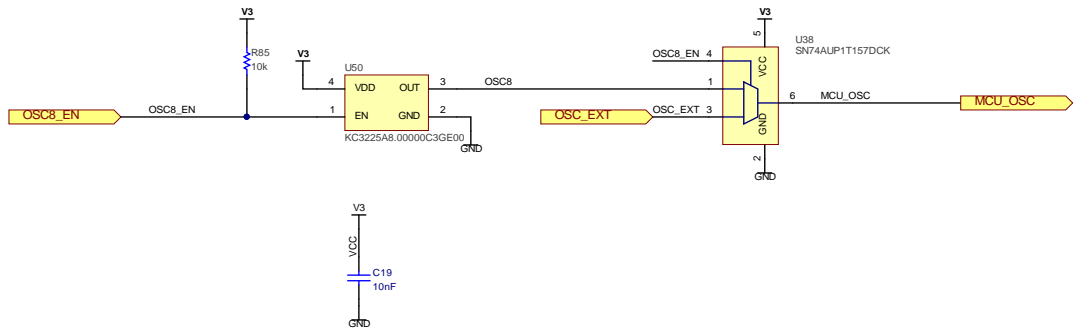
[picture p55: page 38]

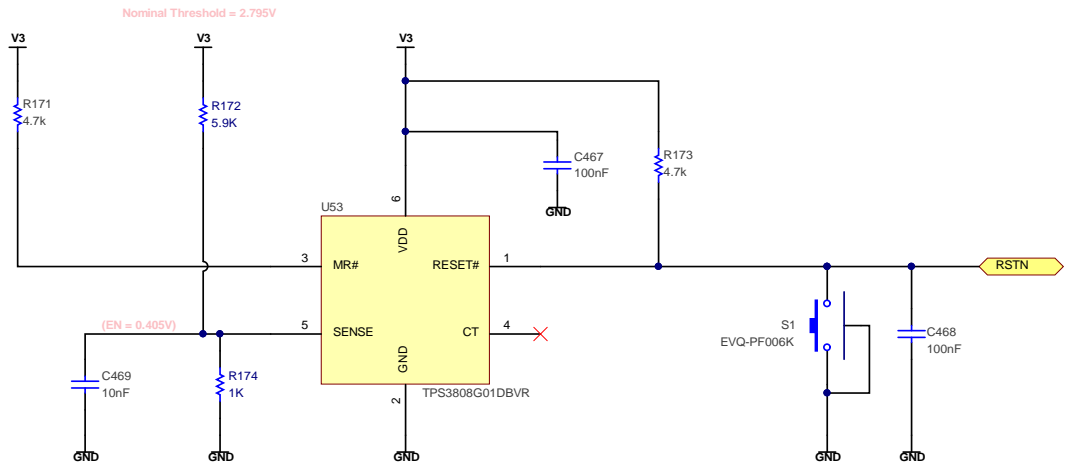
[picture p56: page 39]

Si g n a l L a b ora t ori es, I nc. 3 4 7 9 Ed iso n W a y Me n l o Park C A + 1 (8 7) 8-8 si g l a bs.co m | T itl e Reset

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

R e v i s i o n | | D ate 7/6/2018 Sheet 39 of 49

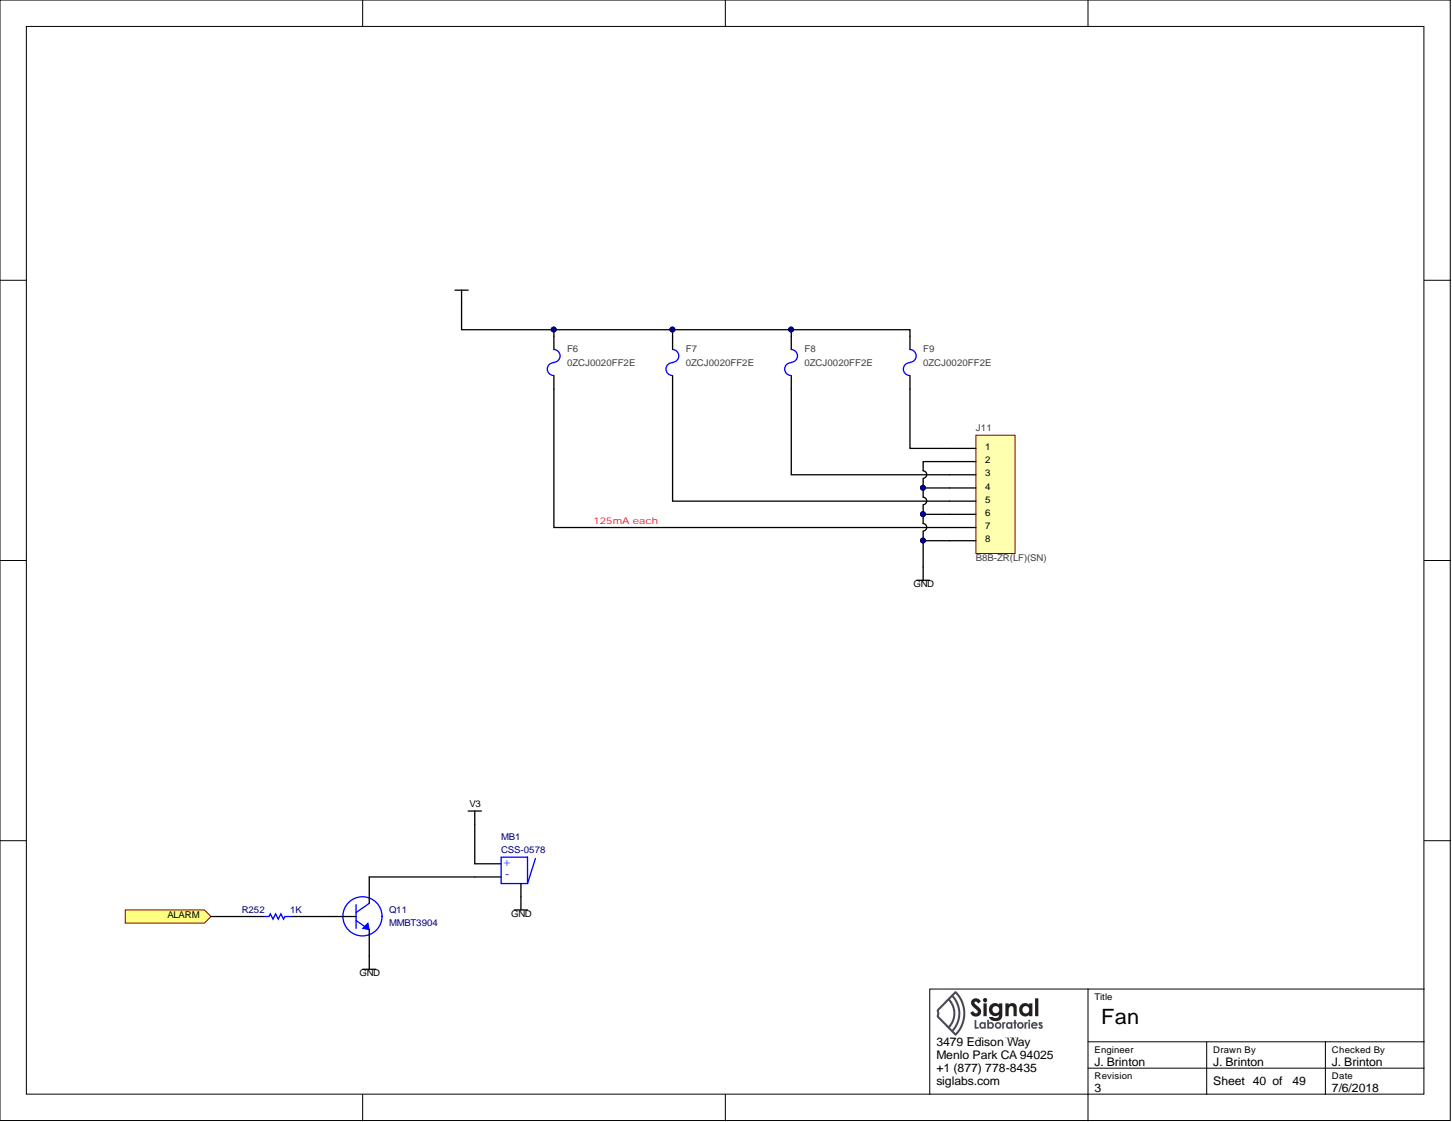
[picture p57: page 40]

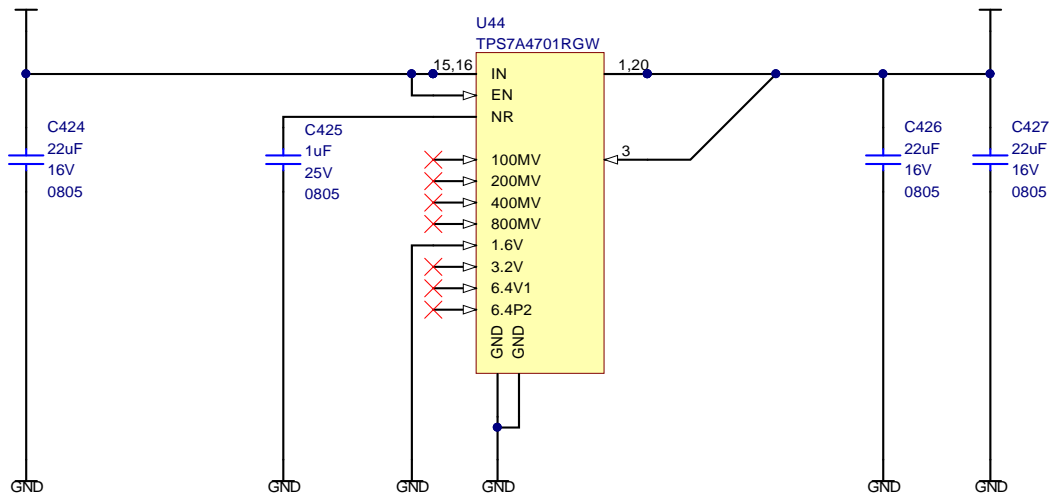
[picture p58: page 41]

Si g n a l L a b ora t ori es, I nc. 3 4 7 9 Ed iso n W a y Me n l o Park C A + 1 (8 7) 8-8 si g l a bs.co m | T itl e Power 3V

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

R e v i s i o n | | D ate 7/6/2018 Sheet 41 of 49

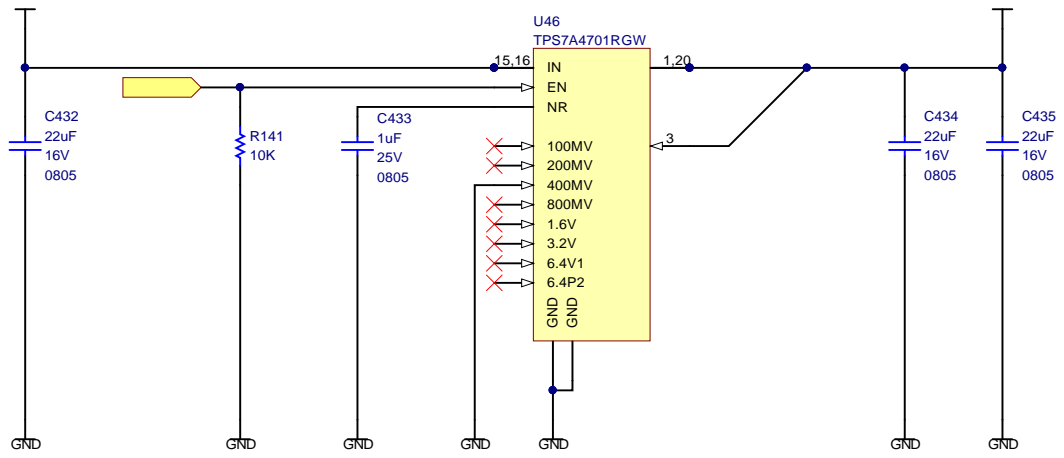
[picture p59: page 42]

Si g n a l L a b ora t ori es, I nc. 3 4 7 9 Ed iso n W a y Me n l o Park C A + 1 (8 7) 8-8 si g l a bs.co m | T itl e Power 1.8V

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

R e v i s i o n | | D ate 7/6/2018 Sheet 42 of 49

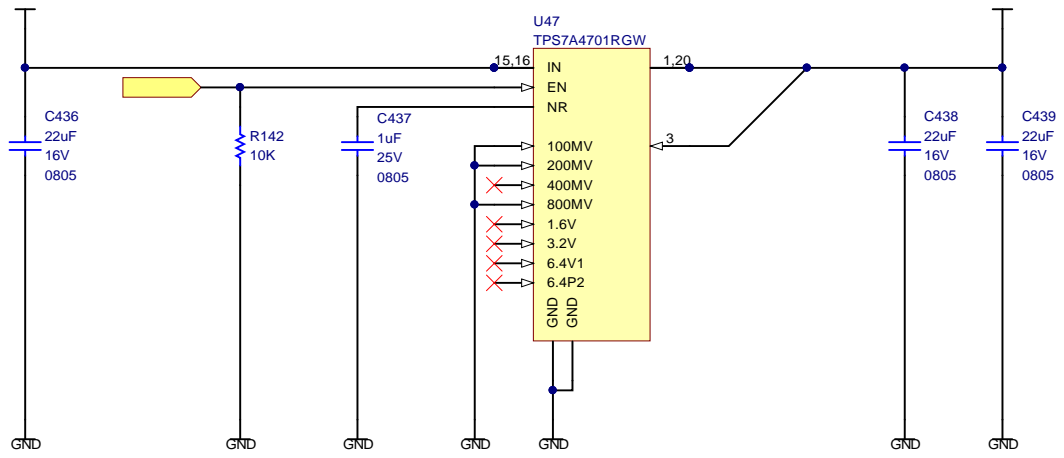
[picture p60: page 43]

Si g n a l L a b ora t ori es, I nc. 3 4 7 9 Ed iso n W a y Me n l o Park C A + 1 (8 7) 8-8 si g l a bs.co m | T itl e Power 2.5V

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

R e v i s i o n | | D ate 7/6/2018 Sheet 43 of 49

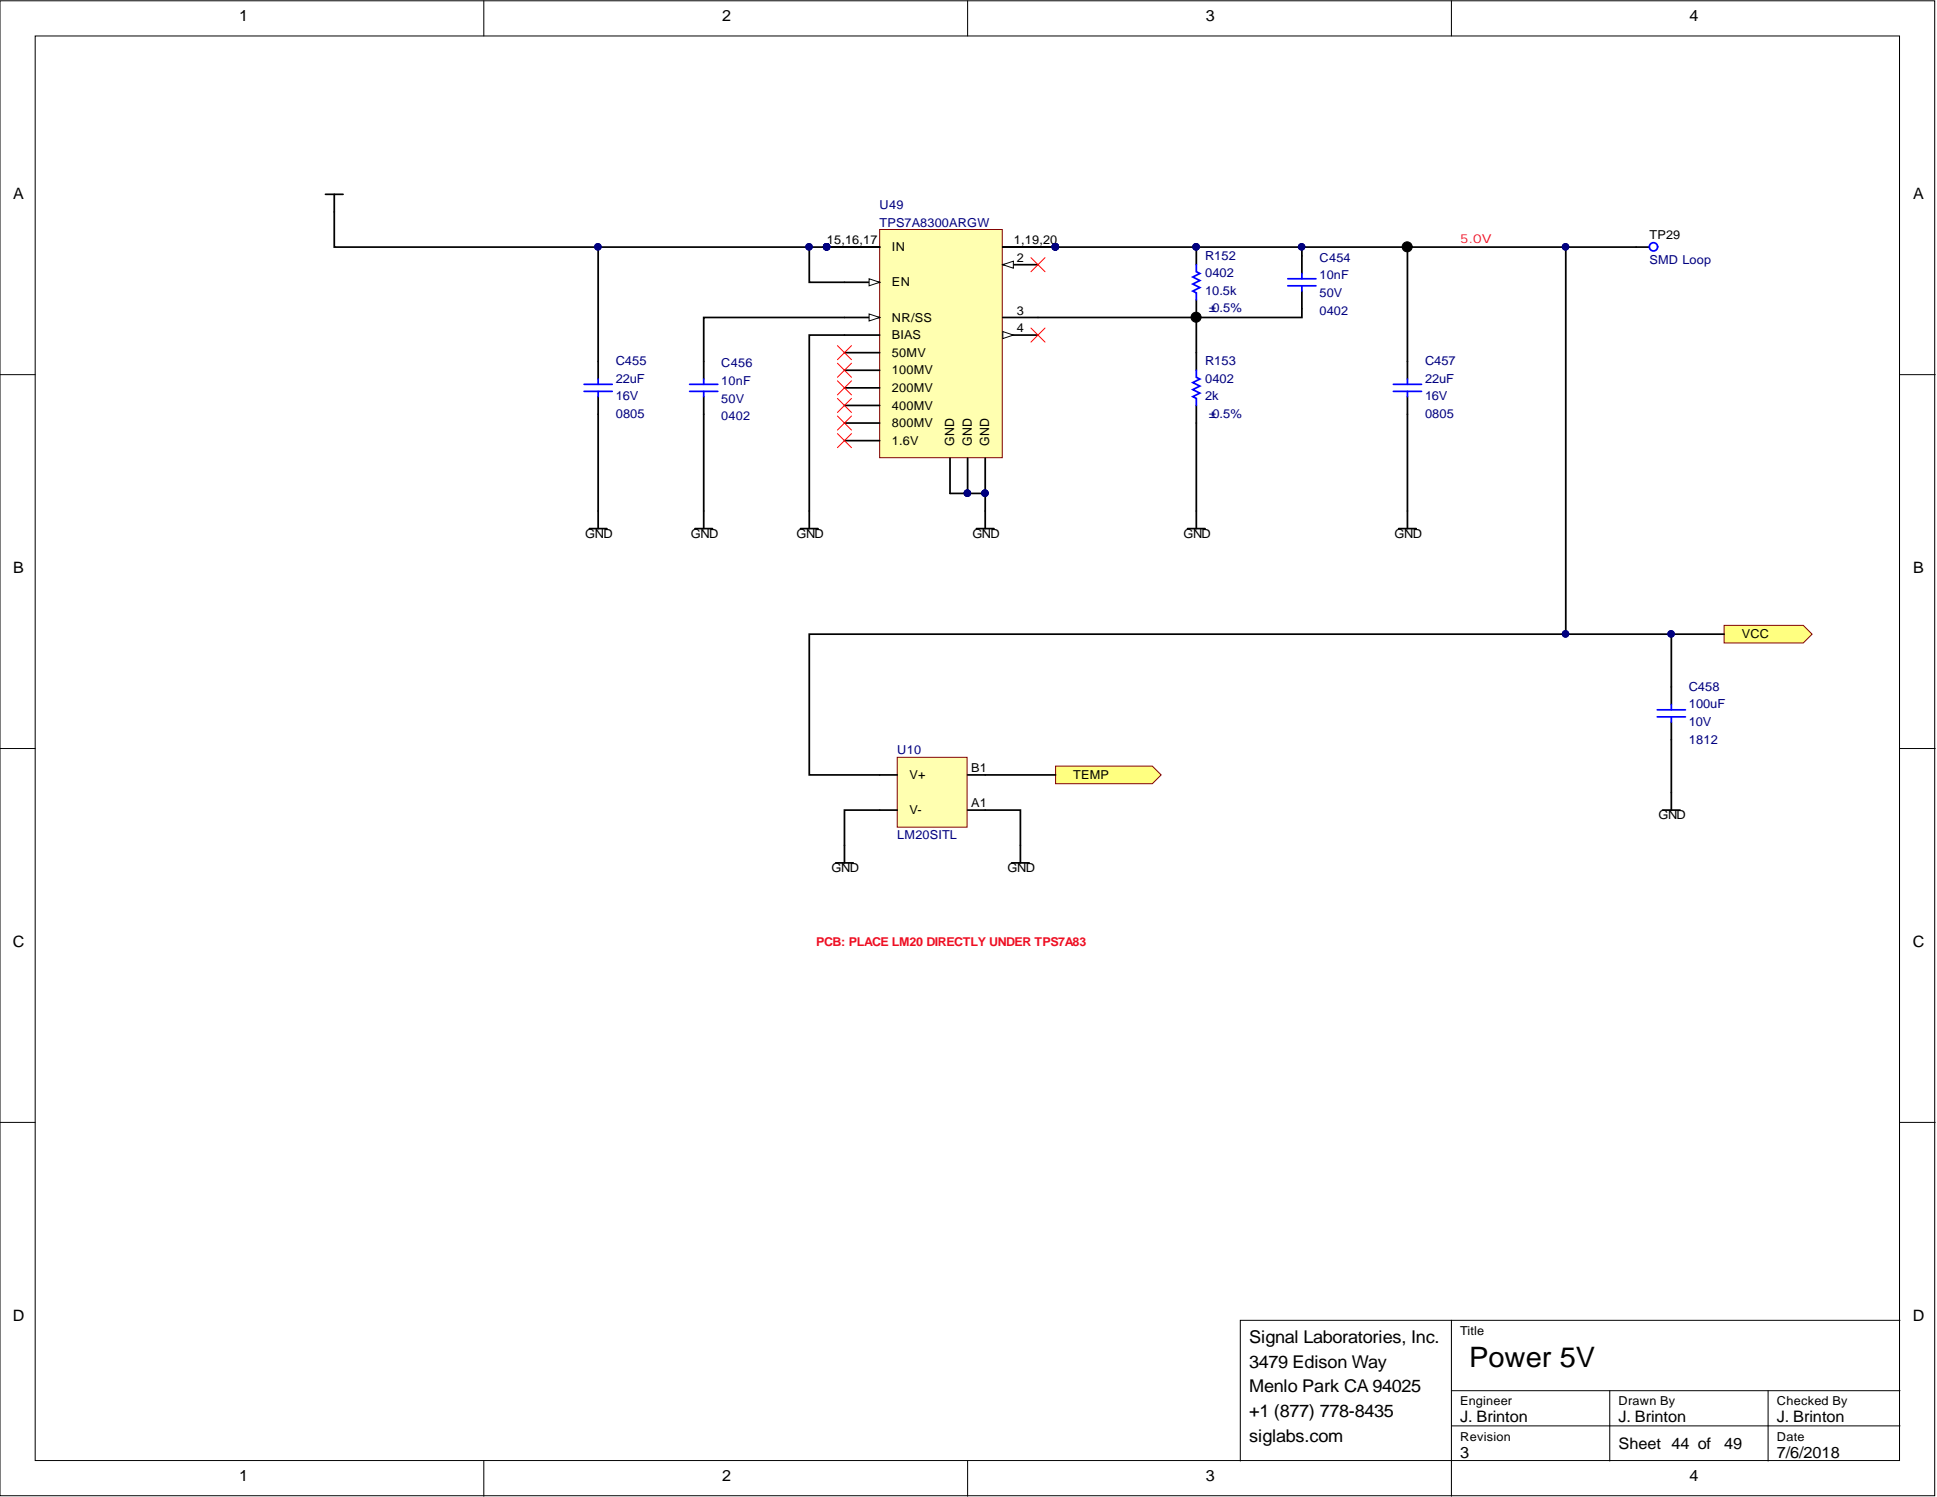
[picture p61: page 44]

PCB: PLACE LM20 DIRECTLY UNDER TPS7A83

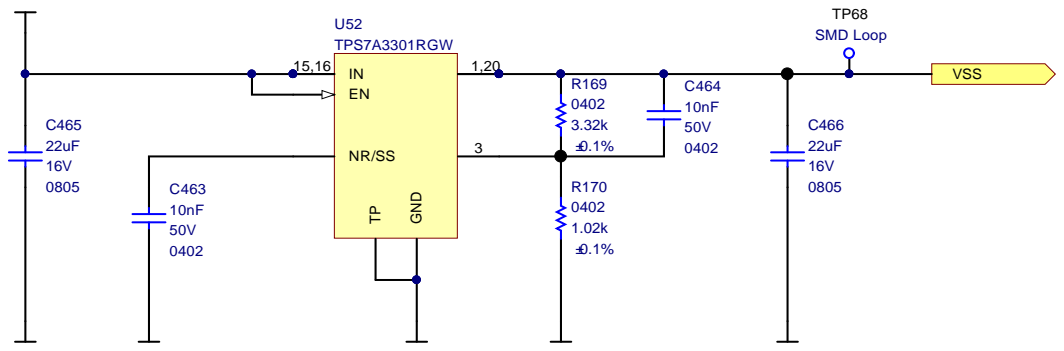
[picture p62: page 45]

Si g n a l L a b ora t ori es, I nc. 3 4 7 9 Ed iso n W a y Me n l o Park C A + 1 (8 7) 8-8 si g l a bs.co m | T itl e Power -5V

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

R e v i s i o n | | D ate 7/6/2018 Sheet 45 of 49

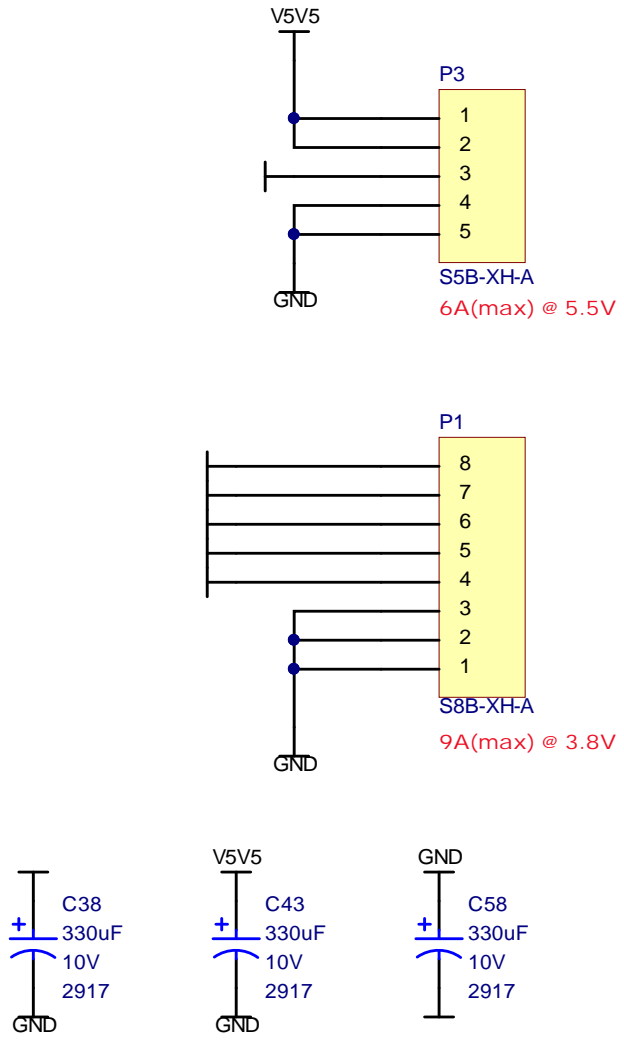
[picture p63: page 46]

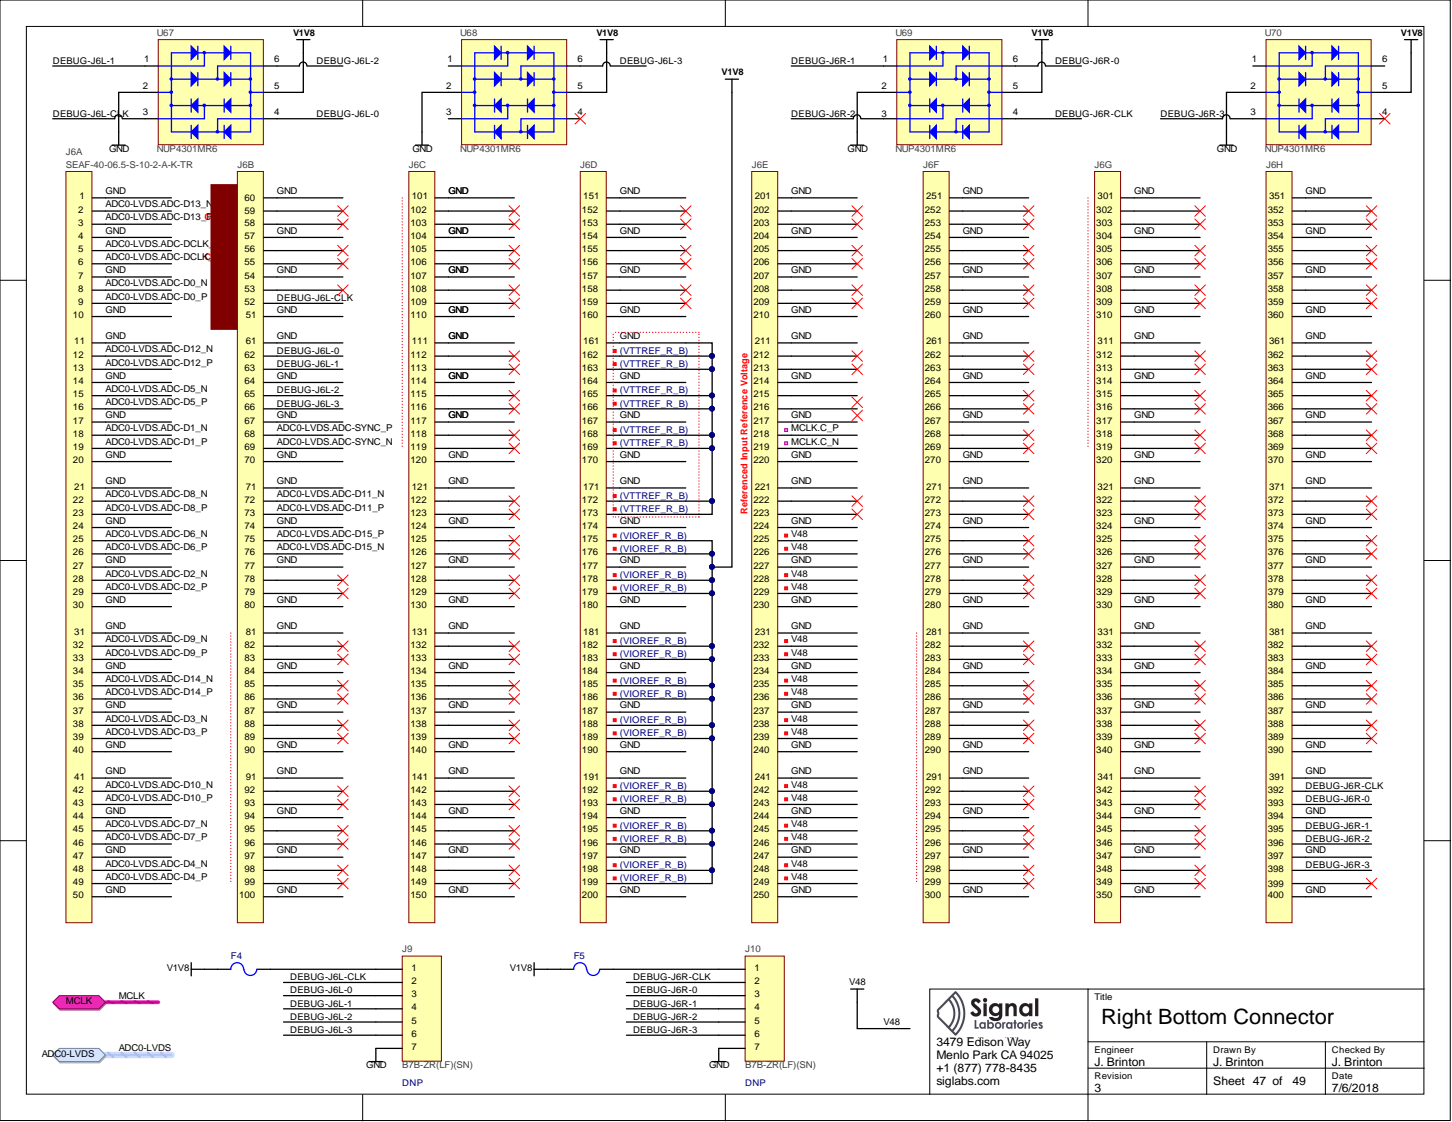
[picture p64: page 47]

Referenced Input Reference Voltage

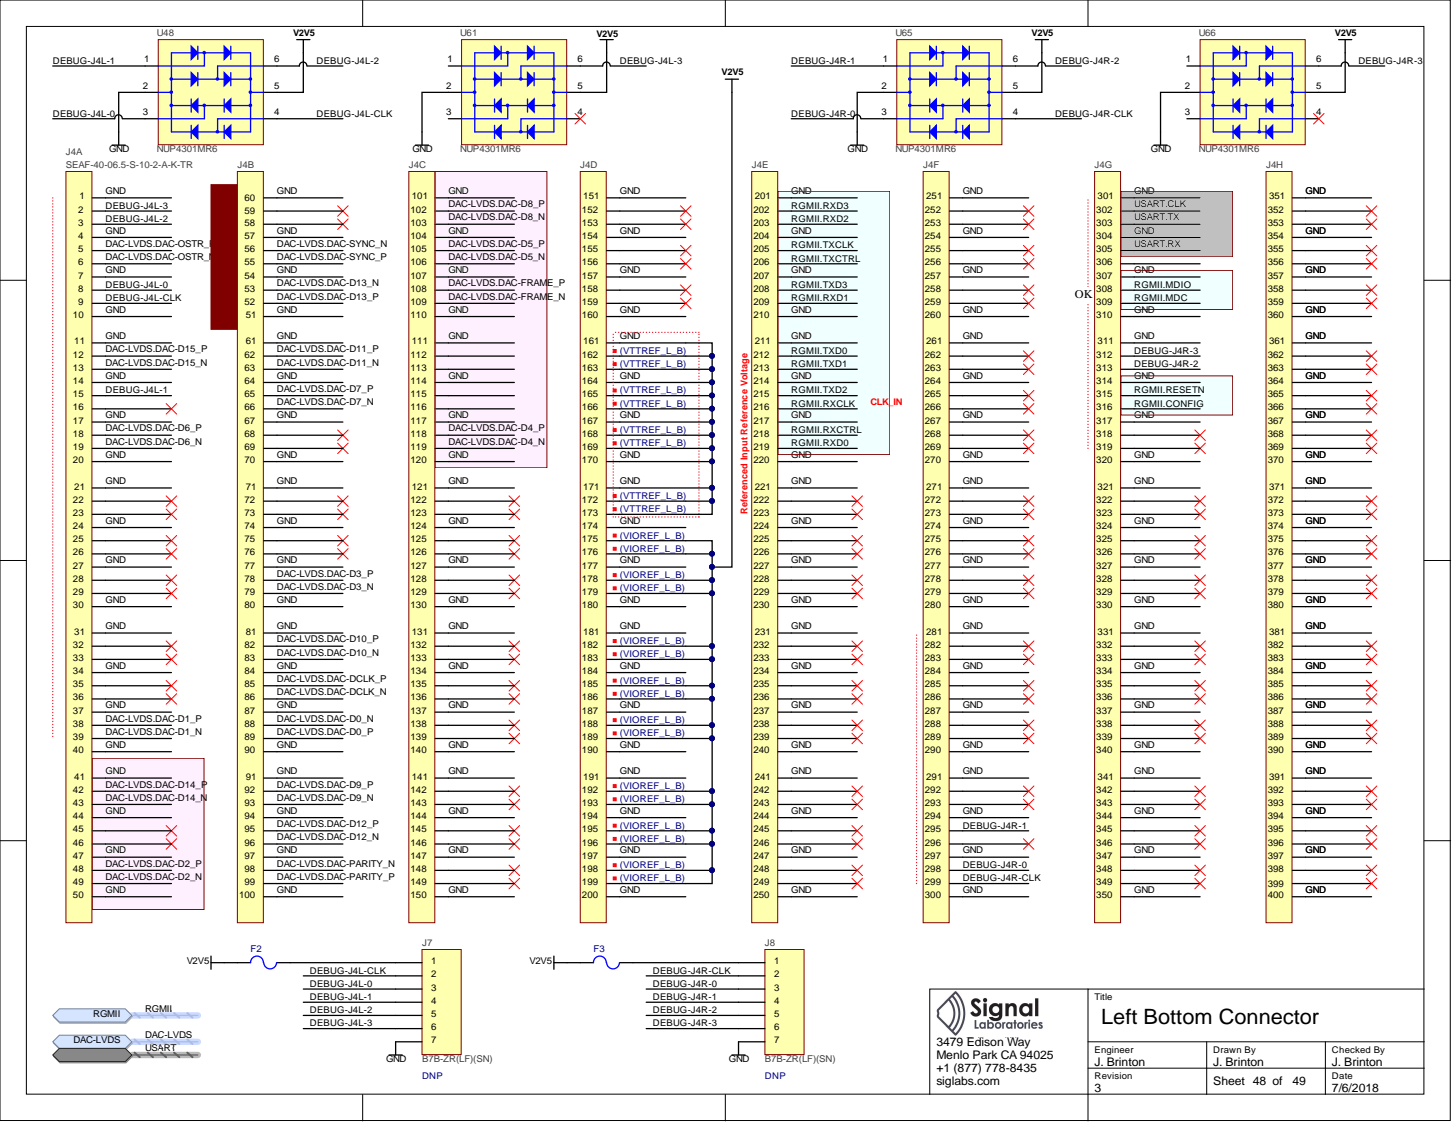
[picture p65: page 48]

Referenced Input Reference Voltage

(VTTREF_L_B)

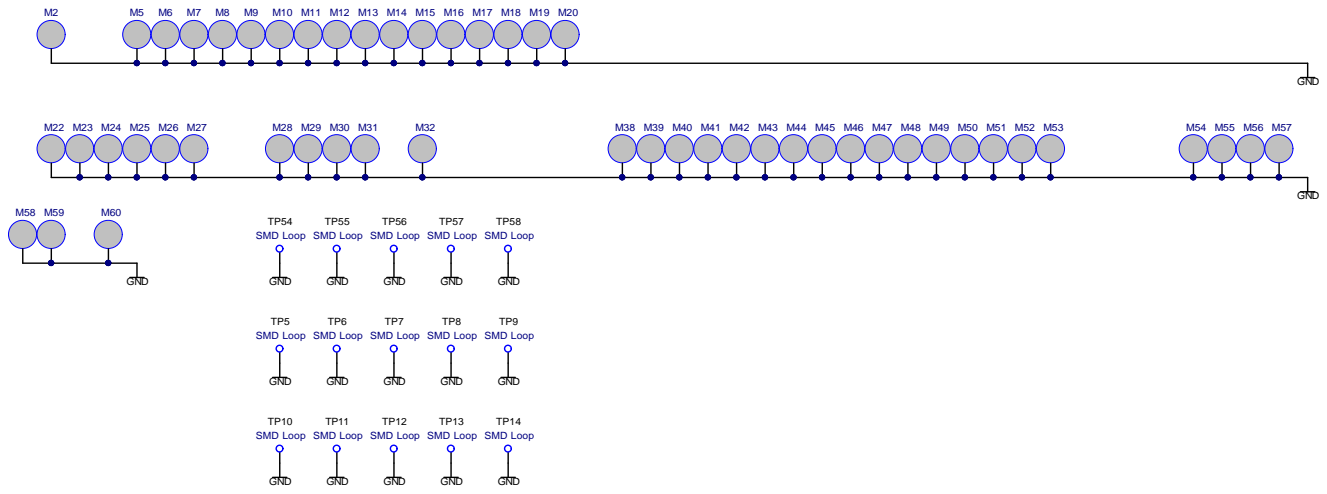
[picture p66: page 49]
