siglabsoss/graviton/docs/signal_chain.pdf

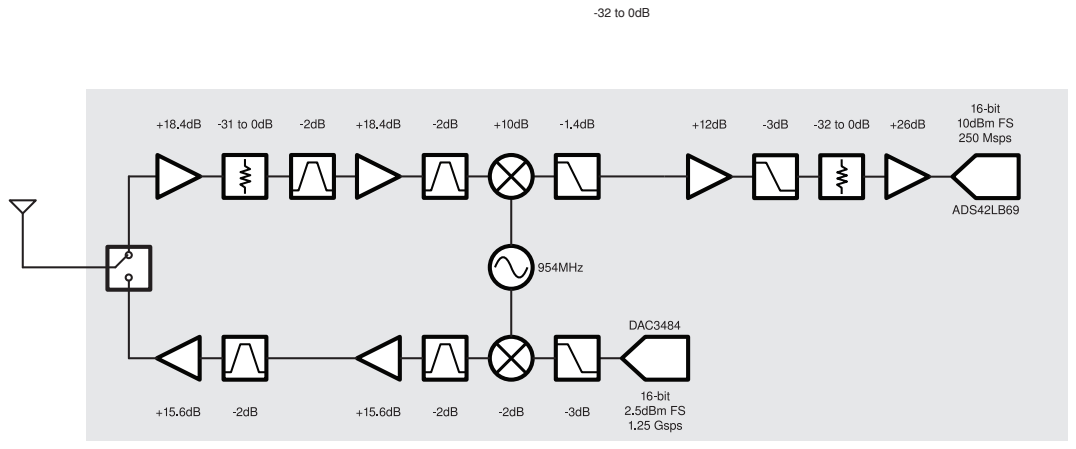
[picture p67: page 1]
