siglabsoss/graviton/docs/dac_transfer_function.asc

I1: current; SINE(0.01 0.01 1e6)
I2: current; SINE(0.01 0.01 1e6)
I3: current; SINE(0.01 0.01 1e6 0 0 180)
I4: current; SINE(0.01 0.01 1e6 0 0 180)
L2: ind2; 0.25
L3: ind2; 0.25
L4: ind2; 0.25
L6: ind2; 0.25
R1: res; 100
R2: res; 10
R3: res; 25
R4: res; 25
R5: res; 25
R6: res; 1Meg
V1: voltage; 3
V2: voltage; 0
Named nets: 0, outp, outn
K1 L2 L4 L6 L3 1
.tran 10us
