siglabsoss/graviton/docs/sims/lmh6554.asc

C1: cap; 1
C2: cap; 1µ
C3: cap; 1µ
L2: ind2; 4
L4: ind2; 1
R1: res; 50
R2: res; 50
R3: res; 50
R4: res; 400
R5: res; 400
R6: res; 1G
R10: res; 100
U1: lmh6554
V1: voltage; 2.5
V3: voltage; 2.5
V4: voltage; SINE(0 0.001 50Meg 0 0 180); AC 1 0; Rser=50
V5: voltage; 1
Named nets: 0, out, in, vom, vop, test1
;.tran 200n
.ac oct 100 1k 10G
;.noise V(out) V4 oct 200n 1k 100G
K3 L2 L4 1
