siglabsoss/graviton/(list of files, drawings)

Other design files:
hardware/adc-amp.SchDoc
hardware/adc-analog.SchDoc
hardware/adc-digital.SchDoc
hardware/adc-ldo.SchDoc
hardware/adc-power.SchDoc
hardware/ADC.SchDoc
hardware/amp-33dbm.SchDoc
hardware/clock.SchDoc
hardware/con-left-bot.SchDoc
hardware/con-right-bot.SchDoc
hardware/dac-analog.SchDoc
hardware/dac-digital.SchDoc
hardware/dac-ldo.SchDoc
hardware/dac-misc.SchDoc
hardware/dac-power.SchDoc
hardware/DAC.SchDoc
hardware/dsa.SchDoc
hardware/eth-ldo.SchDoc
hardware/eth.SchDoc
hardware/fans.SchDoc
hardware/Graviton.PcbDoc
hardware/Graviton.PcbLib
hardware/Graviton.PrjPcb
hardware/Graviton.SchLib
hardware/ifamp-rx.SchDoc
hardware/ifamp-tx.SchDoc
hardware/ingress.SchDoc
hardware/lna.SchDoc
hardware/main.SchDoc
hardware/mcu-osc.SchDoc
hardware/mechanical.SchDoc
hardware/mixer-rx.SchDoc
hardware/mixer-tx.SchDoc
hardware/ocxo.SchDoc
hardware/pa-ldo.SchDoc
hardware/pa.SchDoc
hardware/power-clk.SchDoc
hardware/power-mcu.SchDoc
hardware/power-synth.SchDoc
hardware/power-v1v8.SchDoc
hardware/power-v2v5.SchDoc
hardware/power-v5.SchDoc
hardware/power-v5n.SchDoc
hardware/reset.SchDoc
hardware/rf.SchDoc
hardware/rx.SchDoc
hardware/saw.SchDoc
hardware/switch.SchDoc
hardware/synth.SchDoc
hardware/telem.SchDoc
hardware/top.SchDoc
hardware/tx.SchDoc
hardware/vswr.SchDoc
