siglabsoss/graviton/(commit log)

2014-10-18 initial creation of graviton skeleton
    [ADC.SchDoc, DAC.SchDoc, Graviton-Top.SchDoc, Graviton.PcbDoc, Graviton.PcbLib, Graviton.PrjPcb, Graviton.SchLib, cell-modem-gps.SchDoc]
2014-10-21 created DAC/ADC interface (currently matched to Lattice Board Adapter pinout)
2014-10-22 Skeleton pages for ADC, DAC, wifi, and cell modem.
    [ADC.SchDoc, DAC.SchDoc, Graviton.PrjPcb, cell-modem-gps.SchDoc, wifi.SchDoc]
2014-10-28 clock chip skeleton added, memory interface defined
    [ADC.SchDoc, DAC.SchDoc, cell-modem-gps.SchDoc, clock.SchDoc, fpga-packet.SchDoc, host-mcu.SchDoc, sdram.SchDoc, wifi.SchDoc]
2014-10-28 defining fpga-demod interfaces
    [ADC.SchDoc, DAC.SchDoc, Graviton.PrjPcb, legal - Copy (3).SchDoc, sdram.SchDoc, wifi.SchDoc]
2014-10-28 top level connections
    [Graviton-Top.SchDoc, Graviton.PrjPcb, host-mcu.SchDoc, power.SchDoc]
2014-11-05 initial check in of TX chain, some top level interconnect
    [DAC.SchDoc, Graviton.PrjPcb, Graviton.SchLib, RFTX.SchDoc, host-mcu.SchDoc]
2014-11-07 adding RX chain, TX PAs, top level organization
    [ADC.SchDoc, DAC.SchDoc, Graviton-Top.SchDoc, Graviton.PrjPcb, RFRX.SchDoc, RFTX.SchDoc, TXPA.SchDoc]
2014-11-13 check in before staging TX amplification
    [RFRX.SchDoc, RFTX.SchDoc, TXPA.SchDoc]
2014-12-02 TX moved over to staged amplification
    [RFTX.SchDoc, TXPA.SchDoc]
2014-12-03 parts selection, DC biasing
    [Graviton.SchLib, RFTX.SchDoc, TXPA.SchDoc]
2014-12-04 rx chain part selection
    [ADC.SchDoc, DAC.SchDoc, Graviton-Top.SchDoc, RFRX.SchDoc, RFTX.SchDoc, TXPA.SchDoc]
2014-12-20 PLL updated with OCXO and VCXO
    [ADC.SchDoc, Graviton.SchLib, RFRX.SchDoc, cell-modem-gps.SchDoc, clock.SchDoc, wifi.SchDoc]
2015-01-06 updated with power balance
    [ADC.SchDoc, Graviton-Top.SchDoc, Graviton.PrjPcb, cell-modem-gps.SchDoc, clock.SchDoc, sdram.SchDoc, wifi.SchDoc]
2015-01-15 power supplies
    [Graviton-Top.SchDoc, Graviton.PrjPcb, power.SchDoc]
2015-01-23 corrected power supplies
    [power.SchDoc]
2015-08-12 adding RFLNA
    [Graviton.PrjPcb, Graviton.SchLib, RFLNA.SchDoc]
2015-08-14 revising analog RX chain
    [Graviton-Top.SchDoc, Graviton.PrjPcb, RFRX.SchDoc]
2015-08-14 adding pages for antenna, mixer
    [Antenna.SchDoc, RXMIX.SchDoc]
2015-08-20 high speed IO selection: sdram, dac, adc
2015-08-20 reverted to TI mixer design
    [RFLNA.SchDoc, RXMIX-T3.SchDoc, RXMIX.SchDoc]
2015-08-21 updates to RF front end. added TXPA and IF amp.
    [Graviton-Top.SchDoc, Graviton.PrjPcb, RFLNA.SchDoc, RFRX.SchDoc, RXMIX.SchDoc, TXPA.SchDoc]
2015-08-22 baluns for yer FACE. also added missing DSA sheet. Added single ended RF intermediate amp.
    [ADC.SchDoc, DSA.SchDoc, Graviton-Top.SchDoc, RFAMP.SchDoc, RFLNA.SchDoc, RFRX.SchDoc]
2015-09-09 added discrete lowpass filter to RXMIX
    [RFRX.SchDoc, RXMIX.SchDoc]
2015-09-15 reassigned inter-FPGA busses to conform to PCLK domains.
    [Graviton-Top.SchDoc, Graviton.PrjPcb, RXMIX.SchDoc, clock.SchDoc]
2015-09-16 redid FPGA interconnects, added SPI flash to FPGA pages, moved SDRAM inside FPGA pages
    [ADC.SchDoc, Antenna.SchDoc, Graviton.PrjPcb]
2015-09-18 adding ethernet and FPFA farm (processing) pages
    [Graviton-Top.SchDoc, ethernet.SchDoc, flash.SchDoc, fpga-expansion.SchDoc, processing.SchDoc]
2015-09-19 commit before changing to 3-FPGA configuration
    [Graviton-Top.SchDoc, Graviton.PrjPcb]
2015-09-24 reconfiguriong to 3-FPGA configuration
    [Gain, NF, IP3 Balance Sheet.xlsx, Graviton Power Budget.xlsx, Graviton-Top.SchDoc, Graviton.PrjPcb, ethernet.SchDoc, host-mcu.SchDoc, processing.SchDoc]
2015-09-24 spi programming interface and GPMC added to host AP
    [host-mcu.SchDoc]
2015-09-25 SDRAM termination added, changed to 32-bit-wide, single-rank topology.
    [Graviton-Top.SchDoc, Graviton.PrjPcb, clock.SchDoc, host-mcu.SchDoc, processing.SchDoc, sdram.SchDoc]
2015-09-29 adding lo synth
    [Graviton-Top.SchDoc, RFRX.SchDoc, RXMIX.SchDoc, clock.SchDoc, lo-synth.SchDoc, power.SchDoc]
2015-10-03 FPGA started supply decoupling
    [Graviton-Top.SchDoc, Graviton.PrjPcb, host-mcu.SchDoc, lo-synth.SchDoc, sdram.SchDoc]
2015-10-07 power supply clean up separated DAC and FPGA supplies
    [DSA.SchDoc, Graviton.PrjPcb, RFAMP.SchDoc, RFLNA.SchDoc, RFRX.SchDoc, RFTX.SchDoc, RXMIX.SchDoc, TXPA.SchDoc]
2015-10-08 added 48V input buck supply. Cleaned up supply isolation on the TX chain.
    [Graviton.PrjPcb, RFTX.SchDoc, power.SchDoc]
2015-10-13 commit before switching to copper-suicide FPGA configuration
    [Antenna.SchDoc, DAC.SchDoc, DSA.SchDoc, Graviton-Top.SchDoc, RFRX.SchDoc, lo-synth.SchDoc, power.SchDoc, processing.SchDoc]
2015-10-14 started converting to copper-suicide format: created tx2, rx2, enet2, and config FPGA pages.
    [ADC.SchDoc, Antenna.SchDoc, DAC.SchDoc, DSA.SchDoc, Graviton-Top.SchDoc, Graviton.PrjPcb, RFAMP.SchDoc, RFLNA.SchDoc]
2015-10-15 made Ethernet IO 3.3V
    [ethernet.SchDoc]
2015-10-15 net assignment for ENET in copper suicide format
    [fpga-bank0.SchDoc, fpga-bank1.SchDoc, fpga-bank2.SchDoc, fpga-bank6.SchDoc, fpga-bank7.SchDoc, fpga-bank8.SchDoc, fpga-enet2.SchDoc, fpga-power.SchDoc]
2015-10-15 commit before migrating processing page to using new copper suicide FPGA format
    [ADC.SchDoc, Antenna.SchDoc, Graviton-Top.SchDoc, RFTX.SchDoc, config-bank7.SchDoc, config-top.SchDoc, fpga-rx2.SchDoc, fpga-tx2.SchDoc]
2015-10-15 wired up configuration FPGA
    [Graviton.PrjPcb, clock.SchDoc, config-bank2.SchDoc, processing.SchDoc]
2015-10-20 VTT supplies
    [DAC.SchDoc, Graviton-Top.SchDoc, RFRX.SchDoc, RXMIX.SchDoc, clock.SchDoc, config-top.SchDoc, fpga-enet2.SchDoc, fpga-expansion.SchDoc]
2015-10-20 * adding pin mapping
2015-10-20 created interlink connectors, added missing RF-front page
    [Graviton.PrjPcb, RF-Front.SchDoc, clock-dist.SchDoc, host-mcu.SchDoc, interlinkP1A.SchDoc, interlinkP1B.SchDoc, interlinkP2A.SchDoc, interlinkP2B.SchDoc]
2015-10-21 commit before annotation
    [ADC.SchDoc, Antenna.SchDoc, DAC.SchDoc, DSA.SchDoc, Graviton-Top.SchDoc, Graviton.PrjPcb, RF-Front.SchDoc, RFAMP.SchDoc]
2015-10-21 added _P and _N identifiers to diff pairs for FPGA interlink interfaces.
    [ADC.SchDoc, Antenna.SchDoc, DAC.SchDoc, DSA.SchDoc, Graviton-Top.SchDoc, RF-Front.SchDoc, RFAMP.SchDoc, RFLNA.SchDoc]
2015-10-21 committing files that didn't get saved
    [ADC.SchDoc, Antenna.SchDoc, DAC.SchDoc, DSA.SchDoc, Graviton-Top.SchDoc, RF-Front.SchDoc, RFAMP.SchDoc, RFLNA.SchDoc]
2015-10-21 port matching fixes, commit before trying to fix net naming problems
    [ADC.SchDoc, DAC.SchDoc, fpga-enet2.SchDoc, fpga-rx2.SchDoc, fpga-tx2.SchDoc, processing.SchDoc]
2015-10-22 correcting net naming conflicts
    [Graviton-Top.SchDoc, Graviton.PrjPcb, config-top.SchDoc, fpga-bank0.SchDoc, fpga-bank1.SchDoc, fpga-bank2.SchDoc, fpga-bank4.SchDoc, fpga-bank6.SchDoc]
2015-10-22 corrected net naming issues, unique identifier issues
    [ADC.SchDoc, Graviton-Top.SchDoc, Graviton.PrjPcb, RF-Front.SchDoc, RFLNA.SchDoc, clock.SchDoc, config-bank0.SchDoc, config-bank1.SchDoc]
2015-10-22 reinstated ports can name nets.
    [ADC.SchDoc, DAC.SchDoc, Graviton-Top.SchDoc, Graviton.PrjPcb, RFTX.SchDoc, host-mcu.SchDoc]
2015-10-24 correcting compile errors
    [ADC.SchDoc, Graviton-Top.SchDoc, Graviton.PrjPcb, RF-Front.SchDoc, RFTX.SchDoc, clock-dist.SchDoc, fpga-bank0.SchDoc, fpga-rx2.SchDoc]
2015-10-24 fixed footprint assignments for caps
    [sdram.SchDoc]
2015-10-31 assigning footprints, converted VCXO in clock to PECL.
    [DAC.SchDoc, DSA.SchDoc, Graviton.PrjPcb, Graviton.SchLib, RFAMP.SchDoc, RFLNA.SchDoc, RFRX.SchDoc, RFTX.SchDoc]
2015-11-03 assigned PoE part for ethernet jack. corrected SDRAM VREF hookup (upper chip was connected to VTT instead of VREF)
    [ethernet.SchDoc, sdram.SchDoc]
2015-11-03 annotate and prep pcbdoc for placement
    [Graviton-Top.SchDoc, Graviton.PcbDoc, config-top.SchDoc, sdram.SchDoc]
2015-11-04 pushed components to PCB
    [Antenna.SchDoc, Graviton.PrjPcb, RFLNA.SchDoc, RFRX.SchDoc, RFTX.SchDoc, TXPA.SchDoc, fpga-bank8.SchDoc, fpga-misc.SchDoc]
2015-11-04 reverted to template, locked physical mounting features
2015-11-05 begin top level placement, fixed multi-channel problem
    [config-bank7.SchDoc, fpga-enet2.SchDoc, interlinkP1B.SchDoc]
2015-11-06 clock and synth placement
    [Graviton.PrjPcb, clock.SchDoc, power.SchDoc]
2015-11-07 analog layout, added buzzer and RF testpoints
    [Graviton-Top.SchDoc, RF-Front.SchDoc, RFLNA.SchDoc, RFRX.SchDoc, RFTX.SchDoc, fpga-enet2.SchDoc, host-mcu.SchDoc, processing.SchDoc]
2015-11-10 addressing comments from Joel's review
    [RFLNA.SchDoc, clock.SchDoc, config-bank8.SchDoc, config-top.SchDoc, ethernet.SchDoc, power.SchDoc]
2015-11-11 schematic review updates
    [Antenna.SchDoc, clock.SchDoc]
2015-11-12 redesigned mixer to use mini-circuits xlf reflectionless filter
    [ADC.SchDoc, RFAMP.SchDoc, RFRX.SchDoc, RXMIX.SchDoc]
2015-11-13 added diplexer design
    [diplexer.SchDoc]
2015-11-14 analog routing
    [ADC.SchDoc, DSA.SchDoc, RFAMP.SchDoc, RFLNA.SchDoc, RFRX.SchDoc, RXMIX.SchDoc]
2015-11-19 added dc blocking cap between LNA 0 and antenna T/R switch
    [Graviton-Top.SchDoc, RFRX.SchDoc, RFTX.SchDoc]
2015-11-24 schem review fixes
    [RFAMP.SchDoc, clock.SchDoc, config-bank8.SchDoc]
2015-11-24 T/R switch schmitt trigger
    [Antenna.SchDoc, Graviton.PrjPcb]
2015-11-26 post-mixer filter converted to differential reflectionless filter design. Clock backup source converted to HCMOS from sine. Annotation.
    [ADC.SchDoc, Antenna.SchDoc, Graviton.PrjPcb, RFAMP.SchDoc, RFRX.SchDoc, RXMIX.SchDoc, clock.SchDoc, fpga-bank1.SchDoc]
2015-11-26 Update to PCB
    [Antenna.SchDoc, Graviton-Top.SchDoc, Graviton.PrjPcb, RFRX.SchDoc, RFTX.SchDoc, ethernet.SchDoc, power.SchDoc, sdram.SchDoc]
2015-11-30 fixed footprint association, generic.pcblib priority, etc
    [power.SchDoc, processing.SchDoc]
2015-12-01 one channel analog signal placement
    [RFAMP.SchDoc, RFRX.SchDoc]
2015-12-02 fixed room association error in RFLNA11. Cleaned up DSA config.
    [DSA.SchDoc]
2015-12-04 commit before reannotating
    [Graviton.PrjPcb]
2015-12-05 tx routing, updates to LVPECL DC biasing and termination
    [RFTX.SchDoc, RXMIX.SchDoc, lo-synth.SchDoc]
2015-12-07 tx chain routing
    [Graviton.PrjPcb, RF-Front.SchDoc, RFTX.SchDoc, clock.SchDoc]
2015-12-08 tx routing - txpa
    [RFTX.SchDoc]
2015-12-10 tx chain routing, high-level rearrangement of digital section and clock chain.
2015-12-11 clock routing
    [clock.SchDoc]
2015-12-15 clock/adc routing
    [ADC.SchDoc]
2015-12-16 ADC high level routing complete. Moving on to DAC
    [ADC.SchDoc]
2015-12-17 analog routing.
    [ADC.SchDoc, Graviton.PrjPcb, RXMIX.SchDoc, lo-synth.SchDoc]
2015-12-23 switched to BGA version of DAC to avoid HDI board
    [DAC.SchDoc]
2015-12-24 DAC swapped to BGA to avoid HDI
    [Graviton-Top.SchDoc]
2016-01-04 net class for digital routing; commit before changing GPMC naming (currently named by BBB connector)
    [config-top.SchDoc]
2016-01-05 updated naming for BBB nets to something more sensible. added layout notes for digital routing.
    [RFTX.SchDoc, host-mcu.SchDoc]
2016-01-05 power routing.
    [fpga-enet2.SchDoc]
2016-01-06 moved 10mhz osc and added digital/analod division, commit before editing layer stack
    [power.SchDoc]
2016-01-06 J2 pin swaps for routing
    [interlinkP1A.SchDoc, interlinkP1B.SchDoc, interlinkP2B.SchDoc, processing.SchDoc]
2016-01-06 digital routing: pin swaps on interboard connector for routing optimization
    [interlinkP1A.SchDoc, interlinkP1B.SchDoc, processing.SchDoc]
2016-01-06 commit before (potentially) altering stackup thickness.
    [RF-Front.SchDoc]
2016-01-07 new stackup geometries, tested, created sample BGA breakouts using new trace widths
    [RF-Front.SchDoc]
2016-01-08 commiting before sending to Anil.
    [RF-Front.SchDoc, config-bank8.SchDoc]
2016-01-11 Anil layout check in 1/11/15
    [Graviton.PrjPcb]
2016-01-11 adding second file Graviton_11JAN15.PcbDoc. Not sure which is current yet, will ask Anil
2016-01-12 changed board stackup to match what is on RF-front page.
    [RF-Front.SchDoc]
2016-01-13 fixed net naming consistency vs part designators. all alpha now.
    [Graviton.PrjPcb]
2016-01-14 converted supplies to rooms
    [Graviton.PrjPcb, power.SchDoc]
2016-01-15 power placement and routing.
    [ADC.SchDoc, RFAMP.SchDoc]
2016-01-15 anil daily commit - DDR routing
    [Graviton.PrjPcb]
2016-01-16 power supply placement and routing
2016-01-18 corrections from git issues
    [ADC.SchDoc, Graviton.PrjPcb, RFAMP.SchDoc]
2016-01-19 power supply routing, updates to analog chain using new stackup, git issue fixes
2016-01-19 anil daily merge
    [Graviton.PrjPcb]
2016-01-20 changed sdram termination to part that is more easily available.
    [sdram.SchDoc]
2016-01-21 anil daily merge, more power routing, fixed DDR data and address netlist issue.
2016-01-22 anil daily merge, DDR routing, 3.3V power distribution, clock routing.
    [RFRX.SchDoc, lo-synth.SchDoc]
2016-01-23 clock and power routing
    [Graviton.PrjPcb, clock.SchDoc]
2016-01-25 reassigned clock supplies for cleaner performance
    [clock.SchDoc]
2016-01-25 fixed PPCLK5 tied to VCXO supply oopsie
    [Graviton.PrjPcb]
2016-01-26 power routing
    [clock.SchDoc]
2016-01-26 Anil merge w/ fixed via copy preserving net names, length matching fixes, revised PLL IC 3V3 supply routing.
    [Graviton.PrjPcb, clock.SchDoc]
2016-01-26 and project file
    [Graviton.PrjPcb]
2016-01-27 sch synch (ramclk)
    [Graviton-Top.SchDoc, fpga-bank3.SchDoc, fpga-enet2.SchDoc, fpga-rx2.SchDoc, fpga-tx2.SchDoc, processing.SchDoc]
2016-01-27 fixed net length issues in DDR3, clock routing, ADC LDO
    [ADC.SchDoc, Graviton.PrjPcb]
2016-01-28 Commit before editing stackup, restoring switcher.schdoc and adding annotation file
    [switcher.SchDoc]
2016-01-28 plus project file and pcb up to date
    [Graviton.PrjPcb, power.SchDoc]
2016-01-29 completed clock power routing
    [clock.SchDoc]
2016-01-30 power and clocks
    [Graviton.PrjPcb]
2016-02-01 copying over copper suicide JTAG design
    [config-bank8.SchDoc, fpga-bank8.SchDoc]
2016-02-01 commit before back Robbie sync and back annotation.
    [clock.SchDoc]
2016-02-02 Robbie merge at RB1
    [fpga-bank8.SchDoc]
2016-02-04 placement and routing; starting cavity pours. commit before copy room formats on LNA.
    [Graviton-Top.SchDoc]
2016-02-05 placement and routing. commit before net naming test
    [ADC.SchDoc]
2016-02-05 swap test: swapping rules applied to connectors
    [interlinkP1A.SchDoc, interlinkP1B.SchDoc, interlinkP2A.SchDoc, interlinkP2B.SchDoc]
2016-02-05 P1B DDRCCCLK net naming error fixed
    [interlinkP1B.SchDoc]
2016-02-05 pin swaps enabled, commit before pin swapping
2016-02-05 P1 Swaps
    [interlinkP1A.SchDoc, interlinkP1B.SchDoc]
2016-02-06 P1 and P2 net swaps pushed back to schem
    [interlinkP1A.SchDoc, interlinkP1B.SchDoc, interlinkP2A.SchDoc, interlinkP2B.SchDoc]
2016-02-06 revereted to 9b1c91273a1f76fc55cbd5d8a81c1953754d649b
    [interlinkP1A.SchDoc, interlinkP1B.SchDoc, interlinkP2A.SchDoc, interlinkP2B.SchDoc]
2016-02-06 commit before P1/P2 pin swapping
    [interlinkP1A.SchDoc, interlinkP1B.SchDoc, interlinkP2A.SchDoc, interlinkP2B.SchDoc]
2016-02-06 pin swapping on P1/P2 complete
    [interlinkP1A.SchDoc, interlinkP1B.SchDoc, interlinkP2A.SchDoc, interlinkP2B.SchDoc]
2016-02-08 post PCB merge, pre push back to schem
2016-02-09 changes synced with schematic; merge complete, now up-to-date with EC's pin swapping and RB's last update.
    [DAC.SchDoc]
2016-02-09 applied DAC ball fix
    [DAC.SchDoc]
2016-02-09 push to PCB
    [DAC.SchDoc]
2016-02-09 PCB merged with Robbie update RB3 (pre schem merge)
2016-02-09 RXMIX power
2016-02-09 antenna placement, pre-room-copy
2016-02-09 antenna room copy, rf amp placement (pre-room-copy)
2016-02-11 added +8V and -2.7V RF bias supplies
    [power.SchDoc]
2016-02-12 added charge pump LDO (low noise) supplies for 8V rf switch and negative bias for the DSA
2016-02-13 switched ethernet PHY to external 1.8V supply
    [RF-Front.SchDoc, RFTX.SchDoc, RXMIX.SchDoc, TXPA.SchDoc, ethernet.SchDoc]
2016-02-13 Creating GCPW planes
    [Graviton.PrjPcb, clock.SchDoc]
2016-02-16 Robbie RB5 intermediate merge - PCB merged, pre schem pushback
2016-02-16 schem fix to off-grid net label
    [RFRX.SchDoc]
2016-02-16 schem fixes
    [RFRX.SchDoc, interlinkP1B.SchDoc, processing.SchDoc]
2016-02-16 added reset pins to inter-board connector
    [interlinkP1B.SchDoc]
2016-02-17 commit before reordering SDRAM vias for length matching
    [sdram.SchDoc]
2016-02-18 pre-termination swapping
    [power.SchDoc, sdram.SchDoc]
2016-02-18 flyby routing and termination
    [Graviton.PrjPcb, sdram.SchDoc]
2016-02-19 ddr3 termination
    [sdram.SchDoc]
2016-02-19 pre-length matching
    [sdram.SchDoc]
2016-02-19 DDR flyby termination length match
    [sdram.SchDoc]
2016-02-19 commit before pushing DDR pin swaps back to schem
    [fpga-bank3.SchDoc]
2016-02-19 pushed back, note this fucked a bunch of the TX FPGA net assignments, so remember to go back and fix those. Going to try length matching the addr and control lines. Might be too much (in which case r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
2016-02-19 DDR3 address and ctrl routed and length matched
    [Graviton.PrjPcb, fpga-bank3.SchDoc, fpga-bank4.SchDoc]
2016-02-19 added more CT caps to match marvell eval board CT config
    [ethernet.SchDoc]
2016-02-20 Reorganized to make the FPGA top sheets (TX-FPGA, RX-FPGA, ENET-FPGA) act as the interposer, where then pin swaps will happen
    [ethernet.SchDoc, fpga-bank3.SchDoc, fpga-bank4.SchDoc, fpga-enet2.SchDoc, fpga-rx2.SchDoc, fpga-tx2.SchDoc]
2016-02-23 DDR ADDR/CTRL rerouted, swapping optimized, length matching complete
    [fpga-enet2.SchDoc, fpga-tx2.SchDoc]
2016-02-23 DQS0 routing and swapping
    [fpga-enet2.SchDoc]
2016-02-24 completed DQS0 swapping and routing
    [fpga-enet2.SchDoc]
2016-02-25 3/4 DQS groups swapped and routed
    [fpga-enet2.SchDoc]
2016-02-25 all dqs swapped and routed
    [fpga-enet2.SchDoc]
2016-02-27 moved SDRAM spacing for decoupling caps
    [sdram.SchDoc]
2016-02-27 sdram decoupling
    [sdram.SchDoc]
2016-03-01 sdram decoupling and GPMC routing
    [sdram.SchDoc]
2016-03-01 pre GPMC pin swapping
2016-03-01 GPMC pin swaps, fixed TRANSMIT signal using GPMC net
    [fpga-enet2.SchDoc, fpga-rx2.SchDoc, fpga-tx2.SchDoc]
2016-03-01 one more GPMC swap, fixed ENET conflict
    [fpga-enet2.SchDoc, fpga-rx2.SchDoc, fpga-tx2.SchDoc]
2016-03-02 connected config FPGA to GPMC
    [Graviton.PrjPcb, config-bank6.SchDoc, config-top.SchDoc, processing.SchDoc]
2016-03-03 GPMC routing to interboard connector complete
2016-03-03 ok now GPMC routing to connector is done
2016-03-03 DAC routing
    [fpga-tx2.SchDoc]
2016-03-03 DAC LVDS swapping and routing complete
    [fpga-tx2.SchDoc]
2016-03-04 Begin ENET routing
    [fpga-enet2.SchDoc, processing.SchDoc]
2016-03-04 completed DAC LVDS swaps and routing, started ENET routing
    [fpga-enet2.SchDoc]
2016-04-19 ethernet pin swapping
    [fpga-enet2.SchDoc]
2016-06-13 enet control routing
    [cell-modem-gps.SchDoc, fpga-enet2.SchDoc]
2016-06-14 enet placement routing
    [ethernet.SchDoc]
2016-06-15 power and decoupling routing
    [RF-Front.SchDoc, ethernet.SchDoc]
2016-06-24 JTAG routing
    [Graviton.PrjPcb, processing.SchDoc]
2016-06-29 added control interfaces to bank3 of config FPGA
    [config-bank3.SchDoc]
2016-06-30 commit before pushing RF control changes to PCB
    [ADC.SchDoc, Graviton-Top.SchDoc, Graviton.PrjPcb, config-bank3.SchDoc, config-top.SchDoc, host-mcu.SchDoc, processing.SchDoc]
2016-07-13 control routing complete.
    [config-bank2.SchDoc]
2016-07-13 started dac/adc control routing.
2016-07-15 adc/dac routing pre swap
    [config-top.SchDoc]
2016-07-15 clock dac synth control swaps
    [ADC.SchDoc, config-top.SchDoc]
2016-07-16 adc control routing and level shifters
    [ADC.SchDoc, Graviton-Top.SchDoc, config-top.SchDoc]
2016-07-18 adc/dac/clock/synth control routing complete
2016-07-19 DSA routing complete
    [fpga-rx2.SchDoc]
2016-07-19 added debug header
    [Graviton-Top.SchDoc, Graviton.PrjPcb, config-top.SchDoc, debug-header.SchDoc]
2016-07-20 debug connector routing complete
    [debug-header.SchDoc]
2016-07-21 rf routing, pre-DAC channel swap for polarity optimization
    [DAC.SchDoc, Graviton-Top.SchDoc]
2016-07-21 no this is the pre-swap commit
    [Graviton-Top.SchDoc]
2016-07-21 plus polarity swap on DAC channel B to avoid crossing on the DAC pair going to the mixer
    [DAC.SchDoc]
2016-07-22 eliminated need for TX side polarity swapping by mirroring transformer footprint (part is symmetric)
    [DAC.SchDoc, RFTX.SchDoc]
2016-07-23 rf routing complete
    [DAC.SchDoc, RXMIX.SchDoc]
2016-07-25 FPGA decoupling
    [config-top.SchDoc]
2016-07-28 FPGA power routing, conflict with GPMC and debug routing.
2016-08-02 flash routing complete
    [config-bank8.SchDoc]
2016-08-04 schematic annotation fix pushed to PCB
2016-08-04 orphan parts routing. fixed led wiring in ENET
    [ethernet.SchDoc]
2016-08-05 orphan routing, power to config fpga
2016-08-05 orphan placement and routing done
    [Graviton.PrjPcb, sdram.SchDoc]
2016-08-10 power routing, outer mounting holes
2016-08-11 ADC DAC GPIO8 cross link
2016-08-11 cavity hole placement
2016-08-15 POWER, MECHANICAL
2016-08-16 fixed no net via problem, mech and power routing
2016-08-16 converted IO, JTAG,and SDRAM to 1.35V operation (now matches Copper Suicide)
    [Graviton-Top.SchDoc, config-bank6.SchDoc, config-bank8.SchDoc, config-top.SchDoc, fpga-enet2.SchDoc, fpga-rx2.SchDoc, fpga-tx2.SchDoc, power.SchDoc]
2016-08-16 DDRVTT to 0.675V
    [fpga-enet2.SchDoc, fpga-rx2.SchDoc, fpga-tx2.SchDoc, power.SchDoc, sdram.SchDoc]
2016-08-17 updated stackup
    [RF-Front.SchDoc]
2016-08-18 MOUNTING HOLE ASSIGNMENTS, ADDING TVS TO JTAG ON SCHEM
    [Graviton-Top.SchDoc, fpga-bank8.SchDoc]
2016-08-18 ADDING MECH AND SDRAM MAPPING DOCS
    [Graviton SDRAM pin assignments.xlsx, mechanical.SchDoc]
2016-08-18 component links cleanup, pre-sync for mounting holes and jtag tvs
    [Graviton-Top.SchDoc, Graviton.PrjPcb]
2016-08-18 jtag 1.35v sheet entry fix
    [config-top.SchDoc, mechanical.SchDoc]
2016-08-19 fixed problem with component channels getting swapped
    [power.SchDoc, switcher.SchDoc]
2016-08-20 swapped ADC DCLK pins to match pass Anurag's test implementation
    [Graviton SDRAM pin assignments.xlsx, fpga-rx2.SchDoc, fpga-tx2.SchDoc]
2016-08-20 Applied Anurag's SDRAM CKp CKn swap to put clk on DQS bank
    [Graviton.PrjPcb, fpga-enet2.SchDoc]
2016-08-23 tx chain ground routing.
2016-08-23 JTAG TVS pins swapped for routing optimization
    [fpga-bank8.SchDoc]
2016-08-23 RX ground routing
2016-08-24 split up transmit signals for the two RF sides
    [Graviton-Top.SchDoc, config-top.SchDoc, fpga-tx2.SchDoc]
2016-08-24 clock power routing
2016-08-25 ground routing
2016-08-25 moved RF switch bias supply
2016-08-25 pre-update-pads on avago PAs (adding pads to gnd net)
    [RXMIX.SchDoc, mechanical.SchDoc]
2016-08-25 synced grounded pads in PCB for reflectionless filter and PA with schem
2016-08-26 swapped over SDRAM CLK pair to bank 3. TODO: re-equalize control and address line lengths
    [Graviton.PrjPcb, lo-synth.SchDoc, processing.SchDoc]
2016-08-26 generated preview BOM
    [20160825-Graviton-PreviewBOM.xls, Graviton.PrjPcb]
2016-08-26 power plane connect style
2016-09-07 commit before attempting bulk-remove of net antennae
2016-09-07 fixed a few legit net antennae before bulk net antennae remove
2016-09-07 legit net antennae fix
2016-09-07 unused nets - antennae removal - via phase
2016-09-07 unused pin - net antennae removal- tracks phase - complete
2016-09-09 1.35V routing
2016-09-10 1.35V and 0.68V routing
2016-09-13 0.68V, 3.3v routing
2016-09-13 addign NF calc sheet
    [Graviton NF Calc 20160913.xlsx]
2016-09-14 5v and 2.5v routing
2016-09-14 VCCIO routing, 3.3V routing
2016-09-14 negative rail routing
2016-09-15 1.8V routing
2016-09-15 1.2v, 1.8V adc routing
2016-09-22 net antennae DRC cleared
2016-09-27 scrubbing out 50-ohm traces. All mid layer 0.14mm, all outer layers 0.12mm.
2016-09-28 re-balancing lengths in SDRAM after correcting internal trace widths. Work in progress. First leg length should be 27.25mm
2016-09-29 commit before converting trace widths due to stackup feedback from TTM
2016-09-29 updated outer 50 ohm trace widths to 0.17mm
2016-09-30 first leg reblancing of SDRAM with new surface widths complete
2016-10-03 SDRAM leg 2 length matching complete
2016-10-03 SDram leg 3 WIP
2016-10-04 leg 3 of SDRAM flyby routing - SDRAM re-routing and length matching complete. Surface widths corrected.
2016-10-04 spacing out 7mil bottom traces WIP
2016-10-04 rerouting surface traces WIP
2016-10-05 DRC clear of all clearance violations. Only length matching to fix traces rerouted by width change remain
2016-10-07 DRC zero (minus RX chain changes)
2016-10-11 updated NF calcs with MAX2031 mixer and additional gain
    [Graviton NF Calc 20160913.xlsx]
2016-10-11 fixed datasheet links
    [Graviton NF Calc 20160913.xlsx]
2016-10-12 schem: switching out both RX and TX mixers with MAX2031 high side injection up/down converter (change originated due to TRF37b32's IF lower end limit of 30mhz)
    [Graviton.PrjPcb, RF-Front.SchDoc, RFRX.SchDoc, RXMIX-SE.SchDoc, TXMIX-SE.SchDoc]
2016-10-13 and..annotation broke some things. should be fixed now. clean compile. pre-PCB-update commit
    [Graviton.PrjPcb, RF-Front.SchDoc, RFRX.SchDoc, RXMIX-SE.SchDoc, TXMIX-SE.SchDoc]
2016-10-13 Push to PCB. Fixed problem where PA rooms were not preserved.
2016-10-13 swapped a few rf caps to 0402 package
    [RXMIX-SE.SchDoc, TXMIX-SE.SchDoc]
2016-10-13 ChB mixer placement and routing
    [RF-Front.SchDoc, RXMIX-SE.SchDoc, TXMIX-SE.SchDoc]
2016-10-15 tidy up 5V star power
2016-10-15 adding RX only ports
    [Antenna.SchDoc, Graviton-Top.SchDoc, RFRX.SchDoc]
2016-10-15 DRC zero with RF chain changes integrated
2016-10-17 WIP bom cleanup
    [20161017-Graviton-PreviewBOM.xls, ADC.SchDoc, DAC.SchDoc, Graviton-Top.SchDoc, Graviton.PrjPcb, RFAMP.SchDoc, RXMIX-SE.SchDoc, TXMIX-SE.SchDoc]
2016-10-17 WIP BOM: consolidated 2.2uF caps into 2.2uF 50V ceramic 0805
    [DAC.SchDoc, TXPA.SchDoc, clock.SchDoc, ethernet.SchDoc, power.SchDoc]
2016-10-18 WIP BOM
    [ADC.SchDoc, DSA.SchDoc, RFAMP.SchDoc, RFLNA.SchDoc, TXPA.SchDoc, clock-dist.SchDoc, ethernet.SchDoc, lo-synth.SchDoc]
2016-10-18 WIP BOM consolidation complete thru LO Synth (analog front end complete)
    [ADC.SchDoc, DAC.SchDoc, DSA.SchDoc, clock-dist.SchDoc, config-power.SchDoc, ethernet.SchDoc, fpga-power.SchDoc, interlinkP2B.SchDoc]
2016-10-18 missed two files in the save
    [RFAMP.SchDoc, RFLNA.SchDoc]
2016-10-18 WIP BOM DAC complete
    [DAC.SchDoc]
2016-10-19 BOM consolidation complete thru to 48V supply
    [RFLNA.SchDoc, RFRX.SchDoc, RXMIX-SE.SchDoc, power.SchDoc, processing.SchDoc]
2016-10-19 WIP BOM consolidating 10uF to 0603 25V
    [power.SchDoc, switcher.SchDoc]
2016-10-19 BOM consolidation complete thru power
    [power.SchDoc]
2016-10-20 WIP BOM complete thru ADC
    [ADC.SchDoc, lo-synth.SchDoc, processing.SchDoc]
2016-10-20 WIP BOM consolidation complete thru SDRAM
    [config-bank8.SchDoc, ethernet.SchDoc, fpga-bank8.SchDoc, power.SchDoc, sdram.SchDoc]
2016-10-20 First pass entire project BOM consolidation complete
    [clock.SchDoc, ethernet.SchDoc, sdram.SchDoc]
2016-10-21 push BOM consolidation changes to PCB.
2016-10-21 WIP PCB cleanup from BOM consolidation
2016-10-21 Changes from BOM consolidation pushed to PCB (including some package changes), all resulting DRC errors cleared
2016-10-21 pre-silkscreen commit
2016-10-25 WIP silk
    [Graviton.PrjPcb]
2016-10-27 placing mounting holes around RF ports, adding TTM stackup to the repo
2016-10-28 removing DRC file from project. adding hard and soft reset lines to connector
    [Graviton-Top.SchDoc, Graviton.PrjPcb, config-top.SchDoc, interlinkP1B.SchDoc, mechanical.SchDoc, processing.SchDoc]
2016-10-29 WIP PCB review
    [clock.SchDoc]
2016-10-31 LVPECL source termination for client clock to Copper Suicide connector
    [clock.SchDoc]
2016-11-01 WIP pch review - cleaning up traces under soldermask pullback
    [Graviton.PrjPcb]
2016-11-01 WIP trace to mask clearance
2016-11-02 QIP PCB review - all track-mask overlaps cleared from interboard connectors.
2016-11-03 pre-experimentation commit for reducing solder slivers on FPGA decoupling
2016-11-04 * adding TTM capabilities document. Per Marty Thompson, Graviton will be manufactured in Santa Ana. Although it could possibly be done at Anaheim (and many of my previous boards were done at Anaheim 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
2016-11-04 WIP solder mask sliver reduction. FPGA decoupling section complete.
2016-11-04 WIP pcb review: eliminated mounting hole thermal reliefs, increased thermal relief on all other pads to 0.1mm air gap
2016-11-05 WIP pcb review: implementation of pad to trace spacing (and by extension soldermask sliver at pads) complete
2016-11-05 * adding noise figure worksheet
    [noise_figure_worksheet.xlsx]
2016-11-07 added LVPECL termination with AC coupling to client clock output (clock output to Copper Suicide)
    [RFRX.SchDoc, clock.SchDoc]
2016-11-08 mitigating discontinuous ground for ADC bus
    [Graviton.PrjPcb]
2016-11-08 moved RF IN SMA connector to the same cavity as TX/RX connector.
2016-11-09 * updates to noise figure worksheet
    [noise_figure_worksheet.xlsx]
2016-11-10 WIP adding bigger 1.35V supply
    [power.SchDoc]
2016-11-10 WIP PCB review - cap 397 and SAW filters
    [RFRX.SchDoc]
2016-11-10 WIP 1.35V supply
    [power.SchDoc]
2016-11-10 1.35V supply increased to 6A, DRC cleanup complete from resulting changes
    [power.SchDoc]
2016-11-11 corrections to TPS40178 main 5V supply following TI note about webench bug
    [RFAMP.SchDoc, power.SchDoc]
2016-11-14 WIP new RX IF chain
    [ADC.SchDoc, Graviton.PrjPcb, RF-Front.SchDoc, RFAMP.SchDoc, RFRX.SchDoc, clock.SchDoc, processing.SchDoc]
2016-11-15 WIP RX chain
    [ADC.SchDoc, DSA.SchDoc, Graviton-Top.SchDoc, RFAMP.SchDoc, RFRX.SchDoc, fpga-rx2.SchDoc]
2016-11-15 New RF chain channel B
    [Graviton.PrjPcb, RFAMP.SchDoc, RFRX.SchDoc]
2016-11-15 WIP RF Chain A
2016-11-15 new IF chain channel A routed
2016-11-15 checking in missing files
    [ADC-Front.SchDoc, switcher1V35.SchDoc]
2016-11-16 RX chain LNA and SAW filter
    [ADC.SchDoc, Graviton.PrjPcb, RFRX.SchDoc]
2016-11-16 RX chain changed fully implemented, with DRC cleanup
2016-11-18 * renaming spreadsheet and adding additional sheets
    [graviton_master.xlsx, noise_figure_worksheet.xlsx]
2016-11-18 WIP TX chain changes
    [RFRX.SchDoc, RXMIX-SE.SchDoc, TXMIX-SE.SchDoc, ethernet.SchDoc, power.SchDoc, switcher.SchDoc]
2016-11-18 * adding master design review spreadsheet
    [graviton_master.xlsx]
2016-11-18 applied TX chain changes
    [Graviton.PrjPcb]
2016-11-18 committing missing files
    [RFLNA-14dB.SchDoc, TXPA-24dB.SchDoc]
2016-11-18 WIP TX chain cleanup
2016-11-19 updated rules to include 50ohm diff pairs for MAX2031 IF port
2016-11-19 updating rules for internal layers for 50 ohm DE
2016-11-19 tx chain cleanup
2016-11-19 wip review items
    [ADC.SchDoc]
2016-11-22 * further detailing graviton_master spreadsheet
    [graviton_master.xlsx]
2016-11-23 adding fcc power limit worksheet
    [fcc_power_limits.xlsx]
2016-11-24 see issue tracker for changes
    [ADC-Front.SchDoc, ADC.SchDoc, Antenna.SchDoc, DAC.SchDoc, DSA.SchDoc, Graviton-Top.SchDoc, Graviton.PrjPcb, RF-Front.SchDoc]
2016-11-26 Schem changes for issues 92, 90, 89
    [ADC.SchDoc, DAC.SchDoc, config-bank2.SchDoc, config-bank8.SchDoc, config-top.SchDoc, debug-header.SchDoc, processing.SchDoc]
2016-11-26 issues 68 and 83
    [DAC.SchDoc, clock.SchDoc, debug-header.SchDoc, processing.SchDoc, sdram.SchDoc]
2016-11-26 schematic cleanup
    [DAC.SchDoc, processing.SchDoc]
2016-11-26 pushed issue changes to PCB, routed DACIOVDD
2016-11-26 repour all polygons and saving project
    [Graviton.PrjPcb]
2016-11-26 working on open issues. see github for more details.
    [RFRX.SchDoc, TXMIX-SE.SchDoc, clock.SchDoc, power.SchDoc, sdram.SchDoc, switcher1V35.SchDoc]
2016-11-26 more issues tackled. see github for details.
    [clock.SchDoc, graviton_master.xlsx]
2016-11-27 pushing issue changes to PCB
2016-11-27 cleanup for handoff, added DE-50ohm class
    [RXMIX-SE.SchDoc, TXMIX-SE.SchDoc]
2016-11-27 see github for issues closed. also had to remove annotation file because it was corrupted with identical unique ids (from SchDoc copies) and was causing components to constantly be deleted and re-add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
    [Graviton.PrjPcb, RFLNA-14dB.SchDoc, RXMIX-SE.SchDoc, TXPA.SchDoc, clock-dist.SchDoc, sdram.SchDoc]
2016-11-28 about to refactor all the part numbers per ticket 107
    [ADC.SchDoc, Graviton-Top.SchDoc, Graviton.PrjPcb, clock-dist.SchDoc, clock.SchDoc, config-bank0.SchDoc, config-bank1.SchDoc, config-bank2.SchDoc]
2016-11-28 successfully updated all model library links, see issue 107
    [ADC-Front.SchDoc, ADC.SchDoc, Antenna.SchDoc, DAC.SchDoc, DSA.SchDoc, Graviton.PrjPcb, RFAMP.SchDoc, RFLNA-14dB.SchDoc]
2016-11-28 see github for issues closed
    [ADC-Front.SchDoc, ADC.SchDoc, Antenna.SchDoc, DAC.SchDoc, DSA.SchDoc, Graviton-Top.SchDoc, Graviton.PrjPcb, RFAMP.SchDoc]
2016-11-28 making eth 2.5v and adding eth termination
    [Antenna.SchDoc, Graviton-Top.SchDoc, RF-Front.SchDoc, config-bank0.SchDoc, ethernet.SchDoc, fpga-enet2.SchDoc, fpga-tx2.SchDoc, processing.SchDoc]
2016-11-28 beefing up supply traces
2016-11-29 altered diff routing rules:
    Layers 3 and 8, Edge-Coupled Differential routing with 3mil trace/3mil spacing. This gives 100ohm differential, and can fit between 8/16mil vias on a 0.8mm grid.
    Note that this deviates from the TTM reference doc. I have put a text note in the folder with the TTM doc.
    Also set up rules for ADC and DAC length matching
2016-11-29 WIP ADC length matching
2016-11-29 PCB synchronized with schematic. See github for details.
    [ADC-Front.SchDoc, ADC.SchDoc, Antenna.SchDoc, DAC.SchDoc, DSA.SchDoc, Graviton-Top.SchDoc, Graviton.PcbLib, Graviton.PrjPcb]
2016-11-29 adding missing files
    [if-amp.SchDoc]
2016-11-29 adc length matching complete
2016-11-30 minor schematic cleanup
    [clock.SchDoc, lo-synth.SchDoc]
2016-12-01 WIP clock routing
    [Graviton.PrjPcb, clock.SchDoc]
2016-12-01 part number cleanup
    [TXMIX-SE.SchDoc, clock.SchDoc, ethernet.SchDoc]
2016-12-01 adding PLL2 filter
    [clock.SchDoc]
2016-12-01 adding updated LMK04826B clock design tool file with new loop filter values
    [mechanical.SchDoc]
2016-12-01 new clock routing minus pair swaps. LO-SYNTH swapped RX mixer inputs for routing.
    [lo-synth.SchDoc]
2016-12-02 clock pair swaps + correcting diff pair geometries on all clock lines
    [clock.SchDoc]
2016-12-02 updated clock page
    [Graviton.PrjPcb, clock.SchDoc, config-bank2.SchDoc, config-bank3.SchDoc, config-bank6.SchDoc, config-bank8.SchDoc, config-power.SchDoc, fpga-bank0.SchDoc]
2016-12-02 clock swaps
    [clock.SchDoc]
2016-12-02 fixed synth clock term resistors
    [lo-synth.SchDoc]
2016-12-02 actually fixing lo-synth.SchDoc
    [lo-synth.SchDoc]
2016-12-03 WIP issue #102 RX ChB IF changes complete
    [RXMIX-SE.SchDoc]
2016-12-03 bom edit 1
    [clock.SchDoc, sdram.SchDoc]
2016-12-03 bom edit 2
    [ADC-Front.SchDoc, ADC.SchDoc, DAC.SchDoc, DSA.SchDoc, clock.SchDoc, config-bank2.SchDoc, config-bank3.SchDoc, config-bank6.SchDoc]
2016-12-03 bom edit 3
    [RFLNA-14dB.SchDoc, RFLNA.SchDoc, RXMIX-SE.SchDoc, TXMIX-SE.SchDoc, TXPA-24dB.SchDoc, TXPA.SchDoc, if-amp.SchDoc, lo-synth.SchDoc]
2016-12-03 bom edit 4
    [config-bank2.SchDoc, config-bank3.SchDoc, config-bank6.SchDoc, config-bank8.SchDoc, config-power.SchDoc, ethernet.SchDoc, fpga-bank0.SchDoc, fpga-bank1.SchDoc]
2016-12-03 bom edit 5
    [config-bank2.SchDoc, config-bank3.SchDoc, config-bank6.SchDoc, config-bank8.SchDoc, config-power.SchDoc, fpga-bank0.SchDoc, fpga-bank1.SchDoc, fpga-bank2.SchDoc]
2016-12-03 bom edit 6
    [DAC.SchDoc, RFLNA-14dB.SchDoc, RXMIX-SE.SchDoc, TXMIX-SE.SchDoc, clock.SchDoc, ethernet.SchDoc, if-amp.SchDoc, lo-synth.SchDoc]
2016-12-03 bom edit 7
    [ADC-Front.SchDoc, ADC.SchDoc, DAC.SchDoc, DSA.SchDoc, clock.SchDoc, config-power.SchDoc, ethernet.SchDoc, fpga-power.SchDoc]
2016-12-03 bom edit 8
    [DAC.SchDoc, DSA.SchDoc, RFLNA-14dB.SchDoc, RFLNA.SchDoc, RFRX.SchDoc, RXMIX-SE.SchDoc, TXMIX-SE.SchDoc, TXPA-24dB.SchDoc]
2016-12-03 bom edit 9
    [DSA.SchDoc, clock.SchDoc, power.SchDoc]
2016-12-03 BOM cleanup
    [RFLNA.SchDoc, TXMIX-SE.SchDoc, TXPA.SchDoc, clock.SchDoc, ethernet.SchDoc, lo-synth.SchDoc, power.SchDoc]
2016-12-03 adding diff pair directives to rxif_ per edwin request
    [RXMIX-SE.SchDoc]
2016-12-03 bom cleanup 1
    [DAC.SchDoc, RXMIX-SE.SchDoc, TXMIX-SE.SchDoc, clock.SchDoc, ethernet.SchDoc, if-amp.SchDoc, lo-synth.SchDoc, power.SchDoc]
2016-12-03 bom cleanup 2
    [DAC.SchDoc]
2016-12-03 bom cleanup 3
    [RXMIX-SE.SchDoc, TXMIX-SE.SchDoc, if-amp.SchDoc, lo-synth.SchDoc, power.SchDoc]
2016-12-03 bom cleanup 4
    [Graviton.PrjPcb, RXMIX-SE.SchDoc, TXMIX-SE.SchDoc, clock.SchDoc, config-bank6.SchDoc, fpga-bank6.SchDoc, if-amp.SchDoc, lo-synth.SchDoc]
2016-12-03 bom cleanup 5
    [Antenna.SchDoc, power.SchDoc, switcher1V35.SchDoc]
2016-12-03 bom cleanup 6
    [ADC.SchDoc, RFLNA.SchDoc, RXMIX-SE.SchDoc, TXMIX-SE.SchDoc, TXPA.SchDoc, clock.SchDoc, config-bank6.SchDoc, config-bank8.SchDoc]
2016-12-03 bom cleanup 7
    [DAC.SchDoc, RXMIX-SE.SchDoc, TXMIX-SE.SchDoc, clock.SchDoc, ethernet.SchDoc, if-amp.SchDoc]
2016-12-03 bom cleanup 8
    [ADC.SchDoc, Antenna.SchDoc, DAC.SchDoc, DSA.SchDoc, RFLNA-14dB.SchDoc, RXMIX-SE.SchDoc, TXMIX-SE.SchDoc, clock.SchDoc]
2016-12-03 bom cleanup 9
    [ADC.SchDoc, DAC.SchDoc, RFLNA.SchDoc, clock.SchDoc, config-bank8.SchDoc, ethernet.SchDoc, fpga-bank8.SchDoc, if-amp.SchDoc]
2016-12-03 bom cleanup 10 - inductors
    [ADC.SchDoc, DAC.SchDoc, RFLNA-14dB.SchDoc, RFLNA.SchDoc, RXMIX-SE.SchDoc, TXMIX-SE.SchDoc, TXPA-24dB.SchDoc, TXPA.SchDoc]
2016-12-03 bom cleanup 11
    [DAC.SchDoc, RFLNA.SchDoc, RXMIX-SE.SchDoc, TXMIX-SE.SchDoc, TXPA.SchDoc, clock.SchDoc, config-bank8.SchDoc, ethernet.SchDoc]
2016-12-03 bom cleanup finished, added pcb logo, added power and ground pins to debug connector
    [ADC-Front.SchDoc, ADC.SchDoc, DAC.SchDoc, DSA.SchDoc, RFLNA-14dB.SchDoc, RFLNA.SchDoc, TXPA-24dB.SchDoc, TXPA.SchDoc]
2016-12-06 manual merge of ChA RX chain
2016-12-06 WIP placement and silkscreen
2016-12-07 adding diff pairs
    [ADC.SchDoc, clock.SchDoc]
2016-12-07 * fixed a few BOM items per email 12/7
    [TXMIX-SE.SchDoc, ethernet.SchDoc, power.SchDoc, processing.SchDoc]
2016-12-07 * removed old notes * added reset button
    [ADC.SchDoc, RFLNA-14dB.SchDoc, RFLNA.SchDoc, RFRX.SchDoc, RXMIX-SE.SchDoc, TXMIX-SE.SchDoc, TXPA-24dB.SchDoc, TXPA.SchDoc]
2016-12-07 * adding extra lines for DSA control
    [DSA.SchDoc, fpga-rx2.SchDoc]
2016-12-07 * removed D0 and put capacitors back in on DSA control.
    [DSA.SchDoc, fpga-rx2.SchDoc]
2016-12-07 schem: fixed reversed pin order on fpga bank 2, grounded D0 on DSAs
    [DSA.SchDoc, fpga-bank2.SchDoc]
2016-12-08 * fixed netlist import problem (I think) * fixed FPGA bank 2 schematic symbol (no netlist changes)
    [config-bank2.SchDoc, fpga-bank2.SchDoc]
2016-12-09 bank 2 pin swaps on config fpga
    [config-bank2.SchDoc]
2016-12-09 cleared all clearance, short, and unconnected DRCs except those caused by the net ties.
    [Graviton.PrjPcb]
2016-12-09 * added indicator LEDs * moved ADC control lines to RX fpga * length matched ADC LVDS * misc routing and PCB work
    [ADC-Front.SchDoc, ADC.SchDoc, Graviton-Top.SchDoc, clock.SchDoc, config-bank8.SchDoc, config-top.SchDoc, debug-header.SchDoc, fpga-bank2.SchDoc]
2016-12-09 issue #54: reduce potential for crosstalk between ADC LVDS on S3 and power distribution on S2
2016-12-09 * fixed DC-blocking capacitors.
    [DSA.SchDoc, RFRX.SchDoc, RXMIX-SE.SchDoc, TXMIX-SE.SchDoc, TXPA-24dB.SchDoc, ethernet.SchDoc]
2016-12-09 * option resistors for reflectionless filters
    [RXMIX-SE.SchDoc]
2016-12-10 corrected inner layer rf nets and IF 50ohm diff pair geometry.
2016-12-10 WIP DRC cleanup
    [RF-Front.SchDoc]
2016-12-10 updating ADC control line widths
2016-12-13 adding vias to interboard connectors
2016-12-15 schem pcb sync
2016-12-15 GCPW changed to 0.21mm surface width
2016-12-16 WIP changing RF coupling caps
    [Graviton.PrjPcb]
2016-12-17 WIP RX filter common
2016-12-19 * updating ferrite bead p/n to handle FPGA VCC power consumption
    [config-power.SchDoc, fpga-power.SchDoc]
2016-12-20 filter common PCB changes complete
2016-12-20 Issues #52 and #77: fixed trace widths and RF coupling caps
2016-12-20 added width rule for creating correct GCPW gaps with grounded polygons
2016-12-21 changes to FPGA refclk input for issue #119. Clocks have been moved on RX, TX, and ENET FPGAs from GPLL to PCLK input pins.
    [fpga-bank6.SchDoc]
2016-12-21 missed save for last commit
    [fpga-tx2.SchDoc]
2016-12-22 WIP DAC LVDS switch to LVDS driver capable pairs on FPGA Issue #121
    [fpga-tx2.SchDoc]
2016-12-22 WIP commit before regenerate harness definitions
    [DAC.SchDoc, Graviton-Top.SchDoc, fpga-tx2.SchDoc]
2016-12-22 Issue 121, all DAC interface pairs have been placed on native-LVDS-drive capable FPGA pins on Banks 2 and 3
    [Graviton-Top.SchDoc, fpga-tx2.SchDoc]
2016-12-22 VCCIO on Banks 2 and 3 of TX FPGA converted over to 2.5V to support LVDS drivers
    [fpga-tx2.SchDoc]
2016-12-24 synch project
    [Graviton.PrjPcb, fpga-enet2.SchDoc]
2017-01-03 adding WIP schematic
2017-01-06 pin swaps to length match OSTR on DAC interface, closing out issue #117
    [fpga-tx2.SchDoc]
2017-01-06 WIP ADC LVDS length adjustment
2017-01-07 WIP ADC length adjustment
2017-01-07 DRC burndown: ADC LVDS length adjustment
2017-01-11 removed redundant solder mask definitions from texas instruments RTE package, U24 (TPS54618)
2017-01-11 fixed all solder sliver violations except known issue with super small linear reg for RX chain. Prepping for DRC run with net antennae turned on
2017-01-11 net antennae DRC violations checked and fixed. Diff pair clearance rules turned on in preparation for gebers. Internal layer assignments checked.
2017-01-11 updating outjob and test run of gerbers
2017-01-12 adding fab notes
    [RF-Front.SchDoc]
2017-01-12 updating page numbers and schem title blocks
    [ADC-Front.SchDoc, ADC.SchDoc, Antenna.SchDoc, DAC.SchDoc, DSA.SchDoc, Graviton-Top.SchDoc, RF-Front.SchDoc, RFLNA-14dB.SchDoc]
2017-01-13 BOM Cleanup (a few caps had the wrong manufacturer) and bom generation. committing REV1-RC1 BOM sent to Tina for ordering.
    [DSA.SchDoc, RFRX.SchDoc, RXMIX-SE.SchDoc, TXMIX-SE.SchDoc, TXPA-24dB.SchDoc, interlinkP2A.SchDoc]
2017-01-13 oops adding BOM now to commit
    [20170112-Graviton-REV1-RC1-BOM.xls]
2017-01-14 adding assy files
    [Graviton.PrjPcb]
2017-01-16 saving PCB after creating all fab/assy outputs
2017-01-18 adding PDF schematic
2017-01-18 committing fab responses and updated fab package with new IPC testpoint file
    [Responses to Speedy Circuits EChiu B84P00004A103(20170111-GRAVITON-REV1-RC1-PKG-FAB).xls]
2017-01-20 adding final stackup
    [Final-Stackup-Speedy-Circuits-20170111-GRAVITON-REV1-RC1.xlsx, Responses to Speedy Circuits EChiu B84P00004A103(20170111-GRAVITON-REV1-RC1-PKG-FAB).xls]
2017-01-27 file corrupted, re-saving
    [Final-Stackup-Speedy-Circuits-20170111-GRAVITON-REV1-RC1.xlsx]
2017-01-27 adding FAB-house-updated gerbers with their impedance control trace width modifications
2017-02-10 adding netlist file manipulated from Altium ready for Lattice
    [graviton_rev1_netlist.csv]
2017-02-10 replacing csv with xlsx
    [graviton_rev1_netlist.csv, graviton_rev1_netlist.xlsx]
2017-02-10 adding comment to tab
    [graviton_rev1_netlist.xlsx]
2017-02-16 adding new 5V power supply to resolve issue #127 still need to check current sense resistor value and add sub-schematic
    [20170112-Graviton-REV1-RC1-BOM.xls, Graviton.PrjPcb, power-v5.SchDoc, power.SchDoc]
2017-02-17 nightly commit fixing open tickets
    [Graviton.PrjPcb, clock.SchDoc, config-bank8.SchDoc, config-top.SchDoc, fpga-bank8.SchDoc, power-v5.SchDoc, power.SchDoc, processing.SchDoc]
2017-02-18 fixing export of master netlist file
    [graviton_rev1_netlist.xlsx]
2017-02-18 nightly commit
    [Graviton.PrjPcb]
2017-02-21 changing part number of flash per ticket #139
    [config-bank8.SchDoc]
2017-02-22 fixing ticket #140
    [ADC.SchDoc, Graviton.PrjPcb]
2017-03-06 all changes routed
    [Graviton.PrjPcb, ethernet.SchDoc, switcher.SchDoc]
2017-03-06 schematic labeling
    [lo-synth.SchDoc]
2017-03-07 closed remainder of tickets. needs a bit of clean up before resending to fab.
    [Graviton.PrjPcb, config-top.SchDoc, debug-header.SchDoc, ethernet.SchDoc, fpga-enet2.SchDoc, fpga-tx2.SchDoc, lo-synth.SchDoc, power.SchDoc]
2017-03-09 fixed all open tickets
    [Antenna.SchDoc, config-top.SchDoc, ethernet.SchDoc, fpga-enet2.SchDoc, fpga-rx2.SchDoc, fpga-tx2.SchDoc, graviton_master.xlsx]
2017-03-11 all DRCs fixed needs some silk screen cleanup last checks
    [Graviton-Top.SchDoc, Graviton.PrjPcb, config-bank8.SchDoc, ethernet.SchDoc, mechanical.SchDoc, power-v5.SchDoc, power.SchDoc, processing.SchDoc]
2017-03-12 adding pin mapping for SIGJUMPER
    [graviton_rev1_netlist.xlsx]
2017-03-12 send to fabricator.
    [Antenna.SchDoc, Graviton.PrjPcb, TXMIX-SE.SchDoc, clock.SchDoc, ethernet.SchDoc]
2017-03-13 cleaned up schematics and assembly output job
    [ADC-Front.SchDoc, ADC.SchDoc, Antenna.SchDoc, DAC.SchDoc, DSA.SchDoc, Graviton-Top.SchDoc, RF-Front.SchDoc, RFLNA-14dB.SchDoc]
2017-03-13 adding FPGA pins to loopback pinout
    [graviton_rev1_netlist.xlsx]
2017-03-16 added schematic notes to indicate fpga clock 1 polarity swap ( see ticket #156 )
    [Graviton-Top.SchDoc, clock.SchDoc, fpga-rx2.SchDoc]
2017-03-27 cleaning up rev. 2 before tag
    [20170112-Graviton-REV1-RC1-BOM.xls, Final-Stackup-Speedy-Circuits-20170111-GRAVITON-REV1-RC1.xlsx, Graviton NF Calc 20160913.xlsx, Responses to Speedy Circuits EChiu B84P00004A103(20170111-GRAVITON-REV1-RC1-PKG-FAB).xls]
2017-05-01 cleaning up directory
    [20160825-Graviton-PreviewBOM.xls, 20161017-Graviton-PreviewBOM.xls, Gain, NF, IP3 Balance Sheet.xlsx, Graviton Power Budget.xlsx, Graviton SDRAM pin assignments.xlsx, RFAMP.SchDoc, RFTX.SchDoc, RXMIX-T3.SchDoc]
2017-05-01 cleaning up files
    [Gain, NF, IP3 Balance Sheet.xlsx, Graviton Power Budget.xlsx, Graviton SDRAM pin assignments.xlsx]
2017-05-07 nightly commit added 3rd and 4th transceiver chains need to add FGPA for config control.
    [Graviton-Top.SchDoc, Graviton.PrjPcb, RF-Front.SchDoc, clock.SchDoc, lo-synth.SchDoc]
2017-05-08 some cleanup
    [fpga-bank0.SchDoc, fpga-bank1.SchDoc, fpga-bank2.SchDoc, fpga-bank3.SchDoc, fpga-bank4.SchDoc, fpga-bank6.SchDoc, fpga-bank7.SchDoc, fpga-bank8.SchDoc]
2017-05-08 added FPGA in schematic and copied routing in PCB nightly commit
    [ADC-Front.SchDoc, ADC.SchDoc, Antenna.SchDoc, DAC.SchDoc, DSA.SchDoc, Graviton.PrjPcb, RFLNA-14dB.SchDoc, RFLNA.SchDoc]
2017-05-10 pin mapping setup for routing
    [Antenna.SchDoc, Graviton.PrjPcb, RFRX.SchDoc, clock.SchDoc, lo-synth.SchDoc]
2017-05-13 updating AFE analysis and block diagram
    [graviton_master.xlsx]
2017-05-14 afternoon commit
    [ADC-Front.SchDoc, Antenna.SchDoc, Graviton.PrjPcb, clock.SchDoc, power-v5.SchDoc, power.SchDoc]
2017-05-15 adding IF mixing workshop
    [if_worksheet.xlsx]
2017-05-17 nightly commit adding new files
    [Graviton-Top.SchDoc, Graviton.PrjPcb, clock.SchDoc, con-left-bot.SchDoc, con-left-top.SchDoc, con-right-bot.SchDoc, con-right-top.SchDoc, config-bank0.SchDoc]
2017-06-19 imported enclosure outline more component placement
    [Graviton.PrjPcb, if_worksheet.xlsx, lmk04133_configuration.txt]
2017-07-04 more component placement
    [Graviton.PrjPcb, clock.SchDoc, graviton.SchDoc, lo-synth.SchDoc, power.SchDoc, tie-il0.SchDoc]
2017-07-05 nightly commit adding missing files
    [ethernet.SchDoc]
2017-07-08 changed reference clock input
    [clock.SchDoc]
2017-07-09 fixed triple GND net issue
    [con-left-bot.SchDoc, con-left-top.SchDoc, con-right-bot.SchDoc, con-right-top.SchDoc]
2017-07-09 missed file in last commit
    [graviton.SchDoc]
2017-07-09 removed C308
    [TXMIX-SE.SchDoc]
2017-07-09 DAC-LVDS routed
    [Graviton.PrjPcb, tie-il-cfg.SchDoc, tie-il0.SchDoc]
2017-07-09 ADC0 LVDS routed
    [tie-il1.SchDoc]
2017-07-10 more cfg routing
    [tie-il-cfg.SchDoc]
2017-07-11 connector placement finalized
2017-07-11 savegame - more cfg progress, TXRX cleanup
    [tie-il-cfg.SchDoc]
2017-07-11 EOD checkin - most rough routing complete
    [tie-il-cfg.SchDoc]
2017-07-11 fixed schematic typo on DAC output
    [graviton.SchDoc]
2017-07-11 changed ground on reflectionless filters
    [RFRX.SchDoc]
2017-07-14 rough route complete
    [mechanical.SchDoc]
2017-07-15 cleaned up some power stuff - changed voltage rail on one of the reset circuit resistors
    [reset.SchDoc]
2017-08-05 fixed the ADC and ETH pinouts to connect to PCLK inputs on Copper Suicide
    [DAC.SchDoc, Graviton.PrjPcb, con-left-bot.SchDoc, con-right-bot.SchDoc, fpga-bank1.SchDoc, fpga.SchDoc, tie-il0.SchDoc, tie-il0r.SchDoc]
2017-08-06 all schematic updates made component placement done needs more review final routing
    [Antenna.SchDoc, RF-Front.SchDoc, con-left-top.SchDoc, con-right-bot.SchDoc, con-right-top.SchDoc, graviton.SchDoc, tie-il-cfg.SchDoc]
2017-08-07 nightly push
    [ADC.SchDoc, Antenna.SchDoc, DAC.SchDoc, Graviton.PrjPcb, RFRX.SchDoc, TXMIX-SE.SchDoc, clock.SchDoc, con-left-bot.SchDoc]
2017-08-08 Added mounting vias. Avoided splitting groups of wires.
2017-08-09 Tentative routing for RF switch controls. Trace widths not correct.
2017-08-10 Added decoupling to 5V supply on ALM power amplifiers.
    [TXMIX-SE.SchDoc, decoupling.SchDoc, graviton.SchDoc]
2017-08-10 Added 2V7 and V5 planes for digital step attenuators.
    [decoupling.SchDoc]
2017-08-10 Minor routing, added centre vias around the ADC and clock compartments.
2017-08-10 V3V3 planes around clock and sync chips.
    [Graviton.PrjPcb, decoupling.SchDoc]
2017-08-10 B2B connectors partially fixed.
    [decoupling.SchDoc]
2017-08-10 Added 3V planes to RF switch controls.
2017-08-14 Bypass capacitors on ADC's PP1V8 and PP3V3 inputs.
    [ADC.SchDoc]
2017-08-15 Added decoupling caps to DRVDD on the ADC and non-bias V3V3 on the synch. Repositioned decoupling planes and their corresponding caps.
    [ADC.SchDoc, decoupling.SchDoc, lo-synth.SchDoc]
2017-08-15 Added decoupling capacitors to PP3V3-VCXO and PPCLKx inputs on clock, rearranged decoupling plane caps for V3V3 plane.
    [clock.SchDoc]
2017-08-16 Added vias to one of the RX chains
    [RFRX.SchDoc]
2017-08-16 Added decoupling caps to other RX chain.
    [Graviton.PrjPcb, RFRX.SchDoc]
2017-08-17 TX and RX chains capacitor'd up. Also added vias there.
    [TXMIX-SE.SchDoc]
2017-08-17 Vias for decoupling caps on ADC, synth and clock.
    [Graviton.PrjPcb, TXMIX-SE.SchDoc]
2017-08-18 Finished cleaning top overlay.
    [decoupling.SchDoc]
2017-08-18 Part of the bottom overlay reorganization completed.
    [clock.SchDoc, decoupling.SchDoc]
2017-08-21 Re-annotated all components to make placement easier (C523 next to C524, instead of C523 next to C17)
    [ADC.SchDoc, Antenna.SchDoc, DAC.SchDoc, Graviton.PrjPcb, RFRX.SchDoc, TXMIX-SE.SchDoc, clock.SchDoc, decoupling.SchDoc]
2017-08-22 Swapped polarity of ADC/J2 connector pins. Swapped ADC_DCLK and ADC_D[0].
    [Graviton.PrjPcb, tie-il0.SchDoc, tie-il1.SchDoc]
2017-08-23 More DAC wiring
2017-08-23 Finished routing for differential resistors on DAC.
    [Graviton.PrjPcb]
2017-08-23 Repoured polygons, rearranged differential resistor wires a bit.
2017-08-23 Fixed LTC3265 and MGA-16116 footprints.
    [power.SchDoc]
2017-08-24 Removed net antennas, added pours to remove solder resist traps on J2 connectors.
2017-08-28 Swapped polarity of ADC DCLK, per Mihir's check on lattice Diamond.
    [Graviton.PrjPcb, tie-il1.SchDoc]
2017-08-28 Removed emulated LVDS resistors. Need to figure out correct connections with Mihir.
    [tie-il0.SchDoc]
2017-08-29 Changed nets on DAC for re-routing (TBD). Also need to add emulation resistors.
    [con-left-bot.SchDoc]
2017-08-30 2.5v conversion for Ethernet chip.
    [con-left-bot.SchDoc, ethernet.SchDoc, graviton.SchDoc]
2017-08-30 Initial routing of DAC & emulated LVDS
    [tie-il0.SchDoc]
2017-08-30 Routed DAC & LVDS emulation resistors.
    [Graviton.PrjPcb]
2017-08-31 Finished routing, corrected max decoupled length errors >400mil, corrected silkscreen.
2017-08-31 making some test points DNP.
    [mechanical.SchDoc]
2017-08-31 assembly notes and output job updated.
    [Graviton.PrjPcb]
2017-09-11 final commit before merge
    [Graviton.PrjPcb, TXMIX-SE.SchDoc]
2017-09-14 nightly commit 2
    [RFRX.SchDoc, TXMIX-SE.SchDoc]
2017-09-15 last commit before adding New Power Amplifier
    [TXMIX-SE.SchDoc]
2017-09-15 the rip up has begun to install the power amplifier!
2017-10-03 zener installed backwards updated transmitter link budget fixed DAC output compliance resistors misc changes on TX chain (see Rev2B)
    [DAC.SchDoc, TXMIX-SE.SchDoc, graviton_master.xlsx, power-v5.SchDoc, power.SchDoc]
2017-12-02 misc updates
    [Antenna.SchDoc, graviton.SchDoc, graviton_master.xlsx]
2018-03-12 more work on rev 3. all power supply types added.
    [ADC.SchDoc, Antenna.SchDoc, Graviton.PrjPcb, RF-Front.SchDoc, TXMIX-SE.SchDoc, amp.SchDoc, con-left-top.SchDoc, con-right-top.SchDoc]
2018-03-12 updating master worksheet
    [graviton_master.xlsx]
2018-03-20 nightly update
    [ADC.SchDoc, DAC.SchDoc, Graviton.PrjPcb, RFRX.SchDoc, TXMIX-SE.SchDoc, adc-analog.SchDoc, adc-digital.SchDoc, adc-power.SchDoc]
2018-03-27 updating receiver chain document
    [graviton_master.xlsx]
2018-03-28 * post Khushboo discussion
    [amp-27dBm.SchDoc, amp-33dbm.SchDoc, dac-analog.SchDoc, dsa.SchDoc, graviton_master.xlsx, helical.SchDoc, ifamp.SchDoc, lna.SchDoc]
2018-03-29 updating master doc
    [graviton_master.xlsx]
2018-04-03 updated link budgets
    [graviton_master.xlsx]
2018-04-10 Added MCU for board control
    [ADC.SchDoc, DAC.SchDoc, Graviton.PcbLib, Graviton.PrjPcb, Graviton.SchLib, adc-digital.SchDoc, adc-power.SchDoc, amp-27dBm.SchDoc]
2018-04-10 adding dac power and updated 5V power
    [dac-power.SchDoc, power-v5.SchDoc]
2018-04-11 schematic changes in power supply section
    [DAC.SchDoc]
2018-04-11 power supply changes on these files.
    [dac-v3v3.SchDoc, fans.SchDoc, power-v5.SchDoc, power-v5n.SchDoc]
2018-04-11 Power supply changes
    [ADC.SchDoc, CLK-v3v3.SchDoc, DAC.SchDoc, Graviton.PrjPcb, adc-power.SchDoc, adc-v3v3.SchDoc, clock.SchDoc, dac-power.SchDoc]
2018-04-11 WIP needs to get merged with Khushboo
    [ADC.SchDoc, DAC.SchDoc, Graviton.PrjPcb, adc-analog.SchDoc, adc-digital.SchDoc, adc-power.SchDoc, amp-27dBm.SchDoc, amp-33dbm.SchDoc]
2018-04-11 power supply added
    [Frontend-v3v0.SchDoc, power-v5n.SchDoc, rf.SchDoc, synth.SchDoc]
2018-04-12 finished soft start and V29
    [power-v29.SchDoc, power-v5v5.SchDoc]
2018-04-14 * nightly commit * most everything placed in schematics * major things are to review buck converters
    [ADC.SchDoc, CLK-v3v3.SchDoc, DAC.SchDoc, Graviton.PrjPcb, adc-analog.SchDoc, adc-digital.SchDoc, adc-power.SchDoc, adc-v3v3.SchDoc]
2018-04-17 * nightly * everything has been annotated * all features have been added * review is ongoing
    [ADC.SchDoc, DAC.SchDoc, Graviton.PrjPcb, adc-analog.SchDoc, adc-digital.SchDoc, adc-power.SchDoc, amp-27dBm.SchDoc, amp-33dbm.SchDoc]
2018-04-18 no compile errors
    [ADC.SchDoc, DAC.SchDoc, Graviton.PrjPcb, adc-analog.SchDoc, adc-digital.SchDoc, adc-ldo.SchDoc, adc-power.SchDoc, amp-27dBm.SchDoc]
2018-04-21 * Tina made first pass at BOM * Joel made first pass at BOM * Added Xtal to MCU * More review
    [ADC.SchDoc, DAC.SchDoc, Graviton.PrjPcb, adc-analog.SchDoc, adc-digital.SchDoc, adc-ldo.SchDoc, adc-power.SchDoc, amp-27dBm.SchDoc]
2018-05-02 schematics done with new RX IF chain
    [adc-analog.SchDoc, ifamp-rx.SchDoc, lna.SchDoc, mixer-rx.SchDoc]
2018-05-18 first nightly
    [Graviton.PrjPcb, adc-analog.SchDoc, main.SchDoc, mixer-tx.SchDoc, pa-ldo.SchDoc, power-v5n.SchDoc, rf.SchDoc]
2018-05-23 all errors removed. handing off to vendor for DFM.
    [ADC.SchDoc, Graviton.PrjPcb, adc-digital.SchDoc, adc-power.SchDoc, amp-27dBm.SchDoc, con-left-bot.SchDoc, con-right-bot.SchDoc, dac-power.SchDoc]
2018-05-25 committing before changing plane layers into polygons (to help remove slivers)
    [adc-analog.SchDoc, dsa.SchDoc, pa.SchDoc, rf.SchDoc, switch.SchDoc]
2018-05-25 nightly commit. wip.
    [ADC.SchDoc, Graviton.PrjPcb, adc-analog.SchDoc, pa.SchDoc, rf.SchDoc, rx.SchDoc]
2018-05-27 eth bus rerouted with new clearances
    [con-left-bot.SchDoc, eth.SchDoc]
2018-05-29 adding telemetry and oscillator switching
    [mcu-osc.SchDoc, telem.SchDoc]
2018-05-30 replaced copper planes with polygon pours
    [DAC.SchDoc, clock.SchDoc, dac-digital.SchDoc, ifamp-tx.SchDoc, ingress.SchDoc, lna.SchDoc, main.SchDoc, mixer-tx.SchDoc]
2018-05-30 sent to fab for quote
    [Graviton.PrjPcb, adc-amp.SchDoc, adc-v5.SchDoc, dac-analog.SchDoc, dac-digital.SchDoc, ifamp-tx.SchDoc, main.SchDoc, mixer-tx.SchDoc]
2018-06-04 assembly files from QCD
    [Graviton.PrjPcb, pa.SchDoc]
2018-07-06 updating page numbers adding pdf schematic
    [ADC.SchDoc, DAC.SchDoc, adc-amp.SchDoc, adc-analog.SchDoc, adc-digital.SchDoc, adc-ldo.SchDoc, adc-power.SchDoc, amp-33dbm.SchDoc]
